MechaFlowManiac/Air-Cleaner-2/README.txt

Air-Cleaner-2 

An open source air filter frame concept.  Adaptable to multiple types of fans and filters. 
Based on the Corsi Rosenthal Box DIY air purifier.

This design and documentation is licensed under the CERN-OHL-P license.
