MechaFlowManiac/Air-Cleaner-2/20220318_Air-Cleaner-2_Overview.pdf

# Air Cleaner 2

# Based on the Corsi-Rosenthal Box*

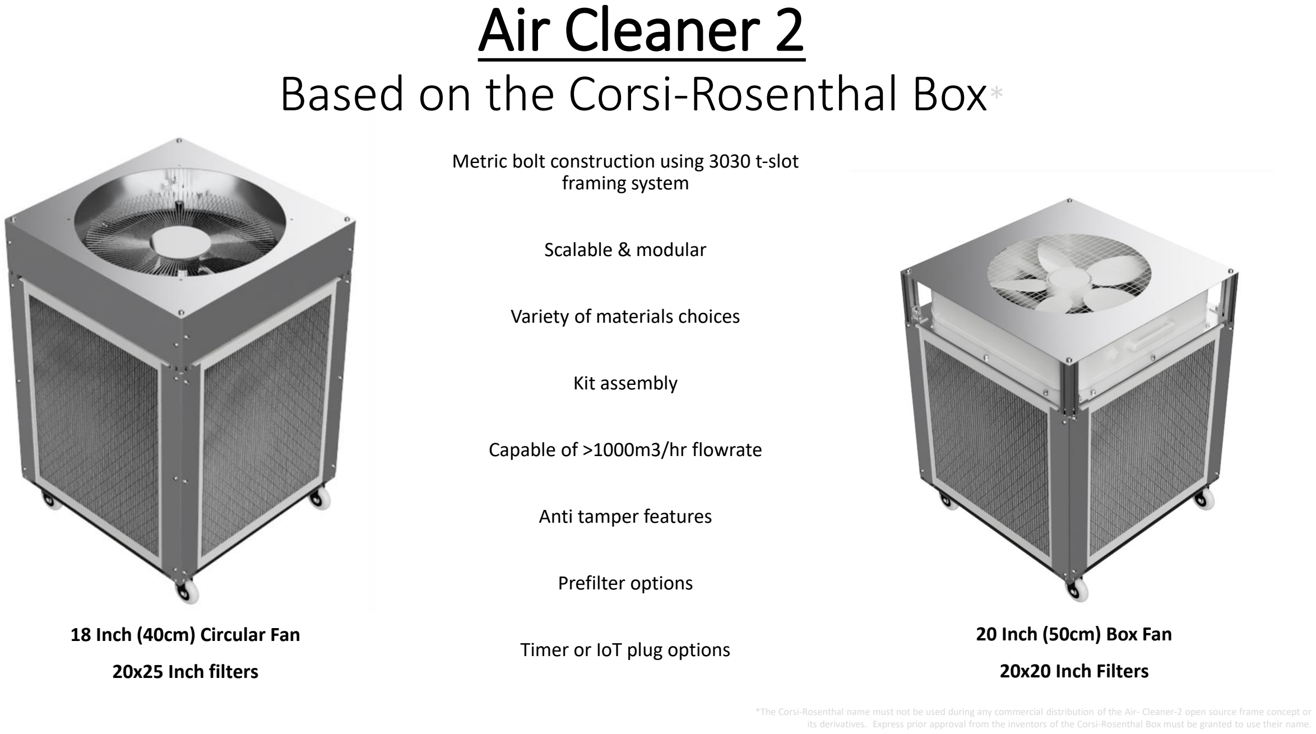
[picture p1: page 1]

Metric bolt construction using 3030 t-slot framing system

Scalable & modular

Variety of materials choices

Kit assembly

Capable of >1000m3/hr flowrate

Anti tamper features

Prefilter options

Timer or IoT plug options

### 18 Inch (40cm) Circular Fan

20x25 Inch filters

### 20 Inch (50cm) Box Fan

20x20 Inch Filters

*The Corsi-Rosenthal name must not be used during any commercial distribution of the Air- Cleaner-2 open source frame concept or its derivatives. Express prior approval from the inventors of the Corsi-Rosenthal Box must be granted to use their name. .

# Exploded view

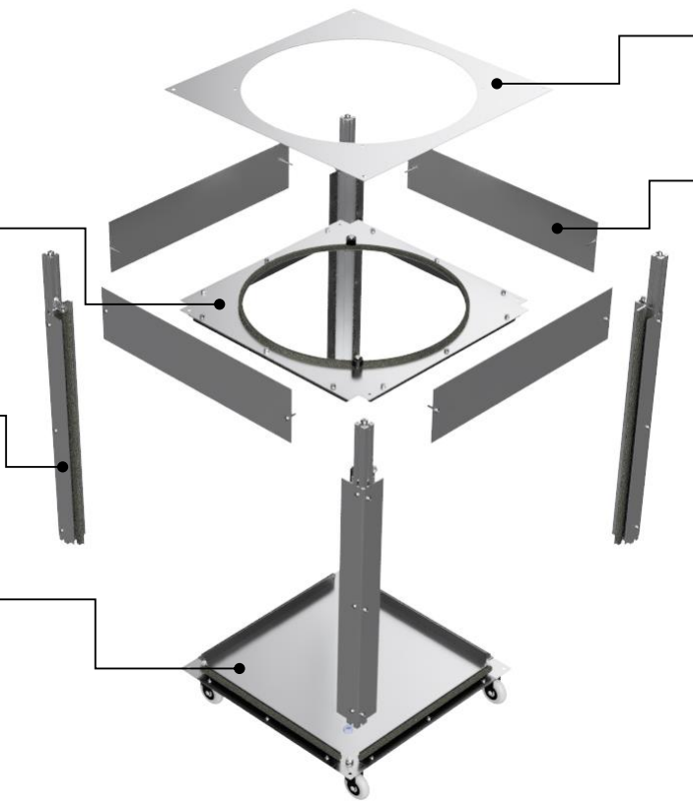
[picture p2: figure]

Fan bottom plate sub assembly

Corner sub assembly

Bottom plate sub assembly

Fan top plate

Fan enclosure plates

# Flat pack

# Sub assemblies

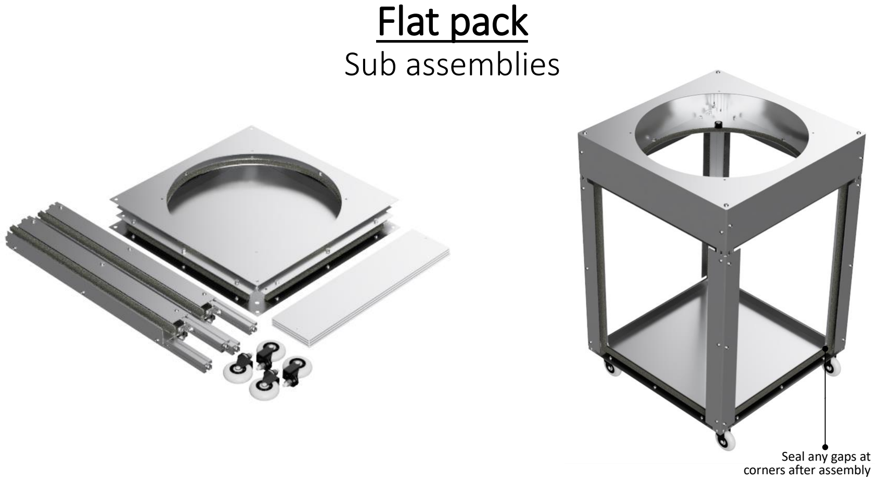
[picture p3: page 3]

Seal any gaps at
corners after assembly

# Fan bottom plate sub assembly

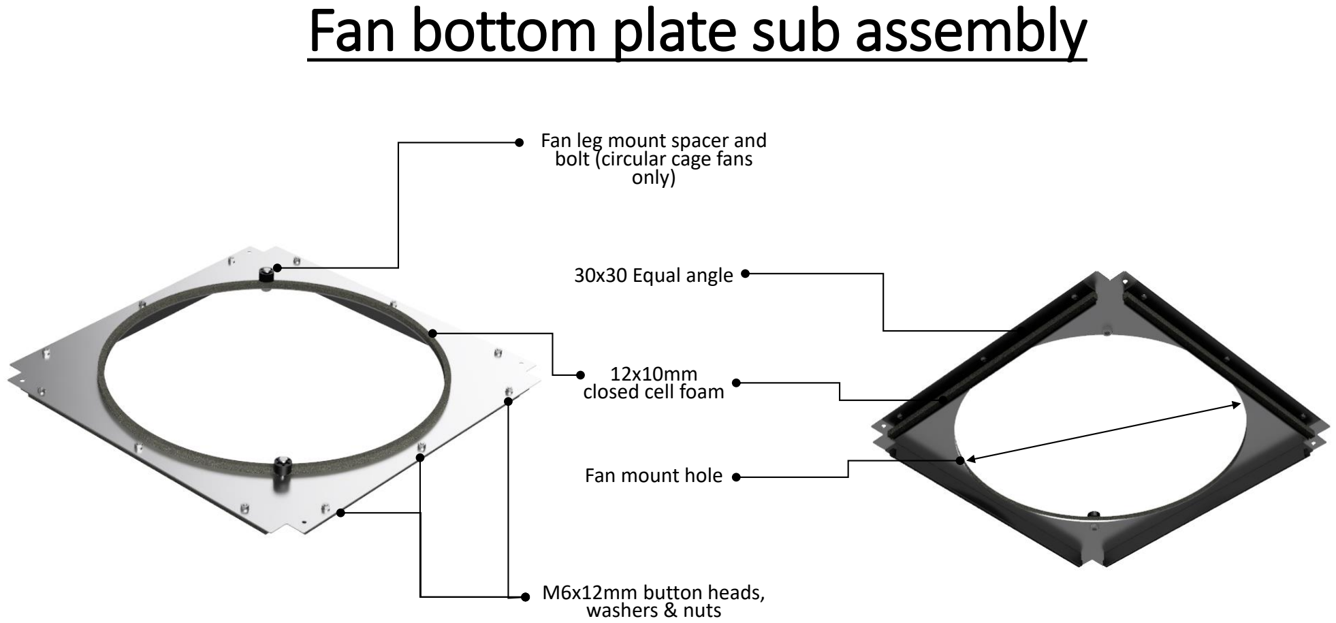
[picture p4: page 4]

Fan leg mount spacer and
bolt (circular cage fans
only)

30x30 Equal angle

12x10mm
closed cell foam

Fan mount hole

M6x12mm button heads,
washers & nuts

30x30 Aluminium t-slot

3030 inside corner brace
30x30x26mm
one side slotted

Filter clamp plate

30x30 equal angles +
12x10mm closed cell foam strip

# Corner sub assembly

M8 top & bottom

All other M6

# Base plate sub assembly

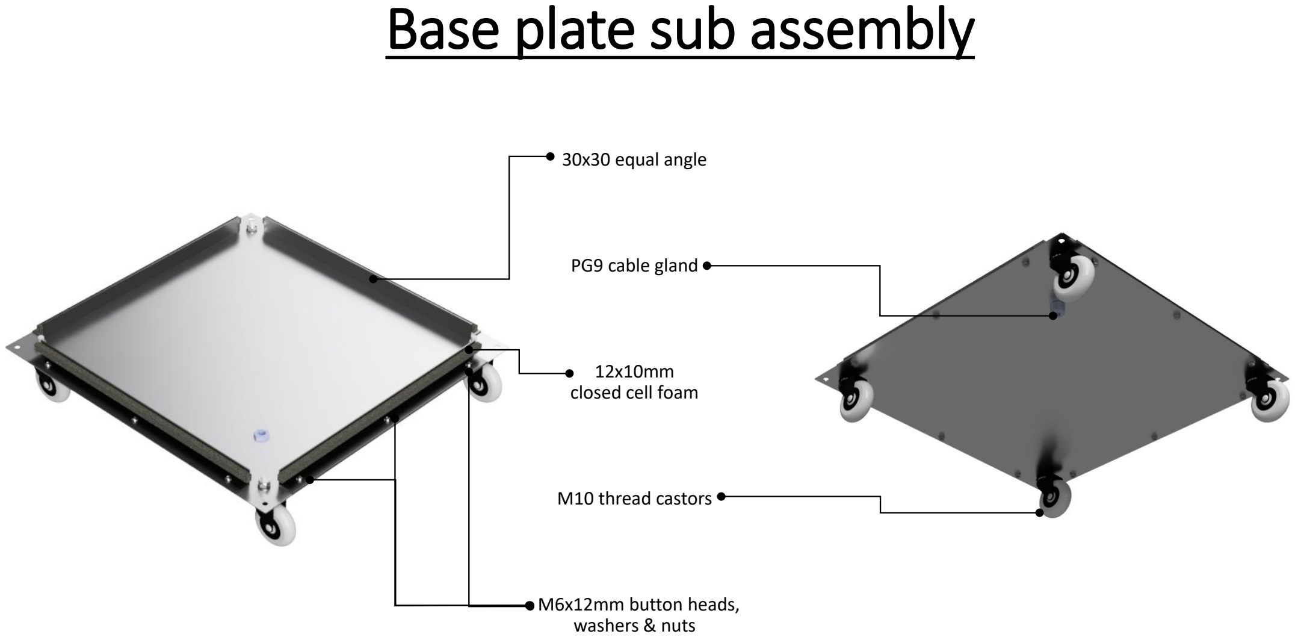
[picture p5: page 6]

30x30 equal angle

PG9 cable gland

12x10mm
closed cell foam

M10 thread castors

M6x12mm button heads,
washers & nuts

# Cable management

# PG9 gland

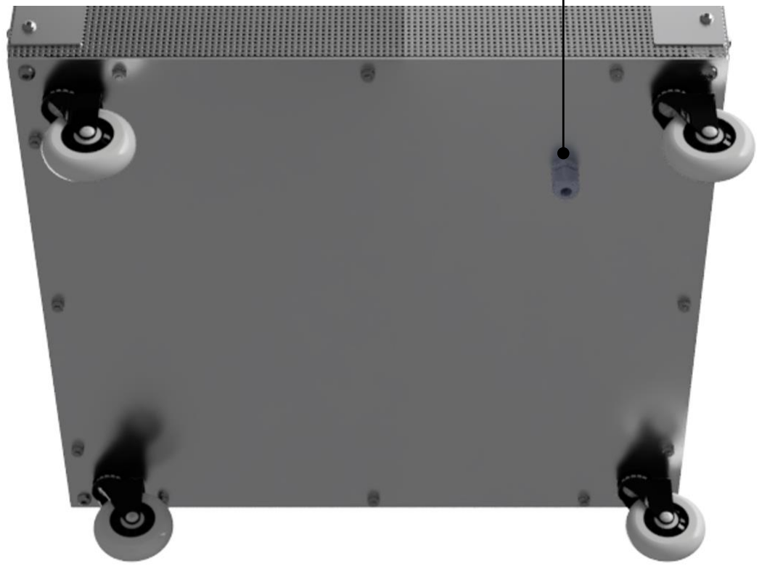
[picture p6: figure]

# OPTIONS

# Sizes

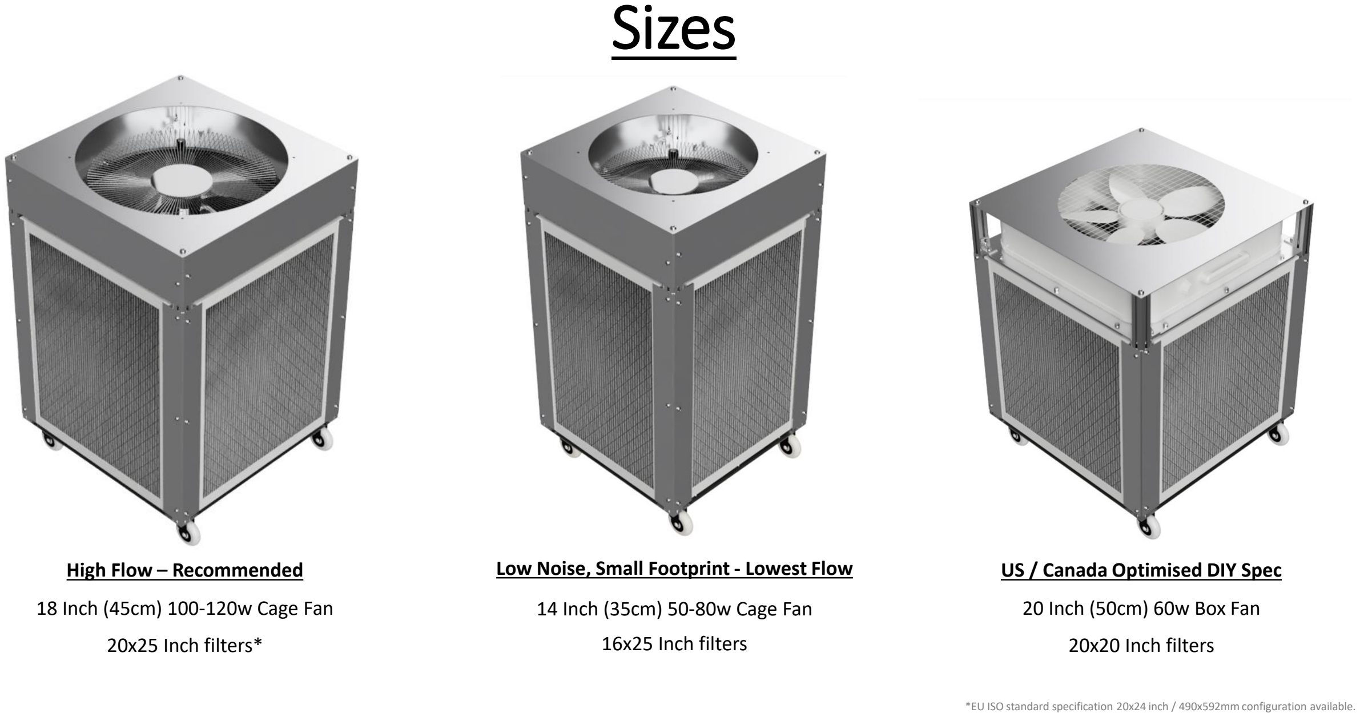
[picture p7: page 9]

High Flow – Recommended

18 Inch (45cm) 100-120w Cage Fan

20x25 Inch filters*

US / Canada Optimised DIY Spec

20 Inch (50cm) 60w Box Fan

20x20 Inch filters

Low Noise, Small Footprint - Lowest Flow

14 Inch (35cm) 50-80w Cage Fan 16x25 Inch filters

*EU ISO standard specification 20x24 inch / 490x592mm configuration available.

# Basic box

Example:

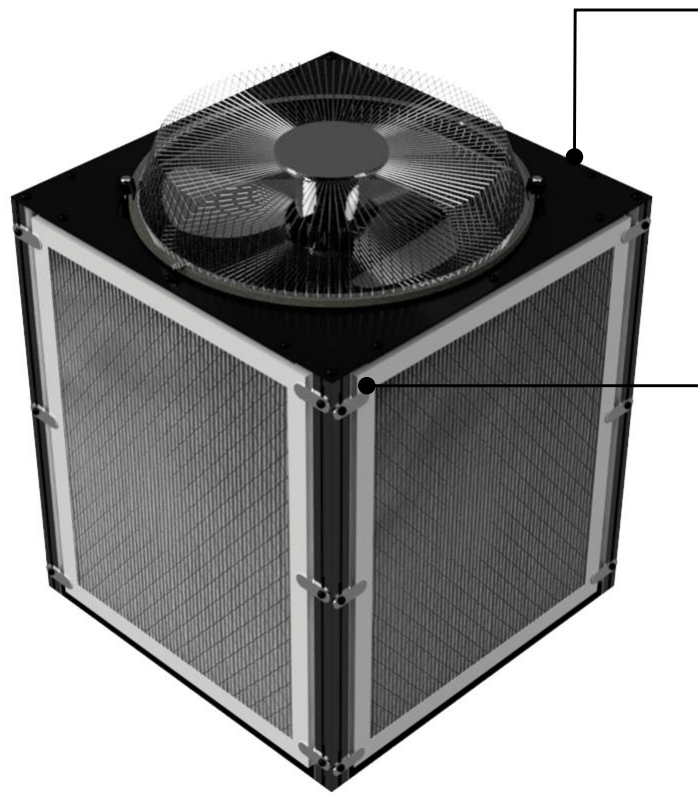
[picture p8: figure]
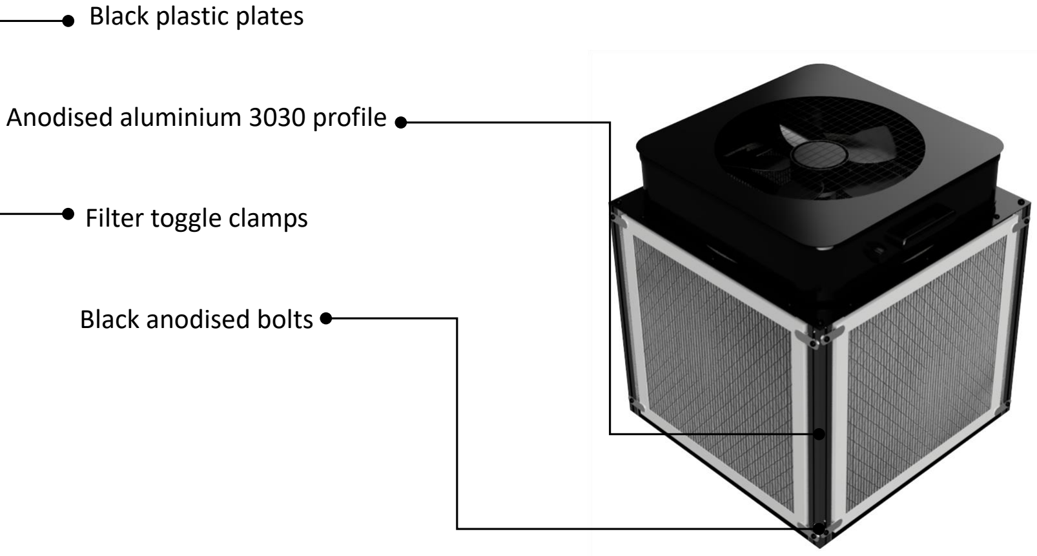
[picture p9: figure]
Black plastic plates; Anodised aluminium 3030 profile; Filter toggle clamps; Black anodised bolts

# Basic box mount

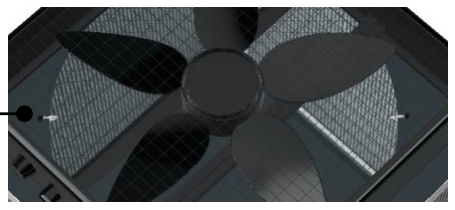
[picture p10: figure]
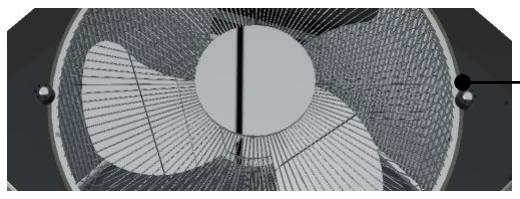
[picture p11: figure]

Cage fan pinned by leg bolts & spacers

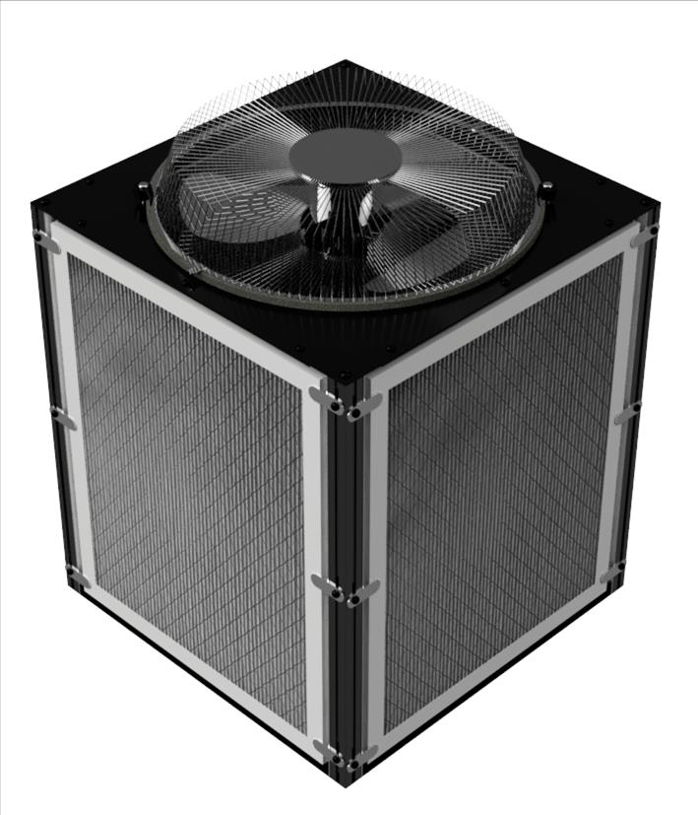
[picture p12: figure]
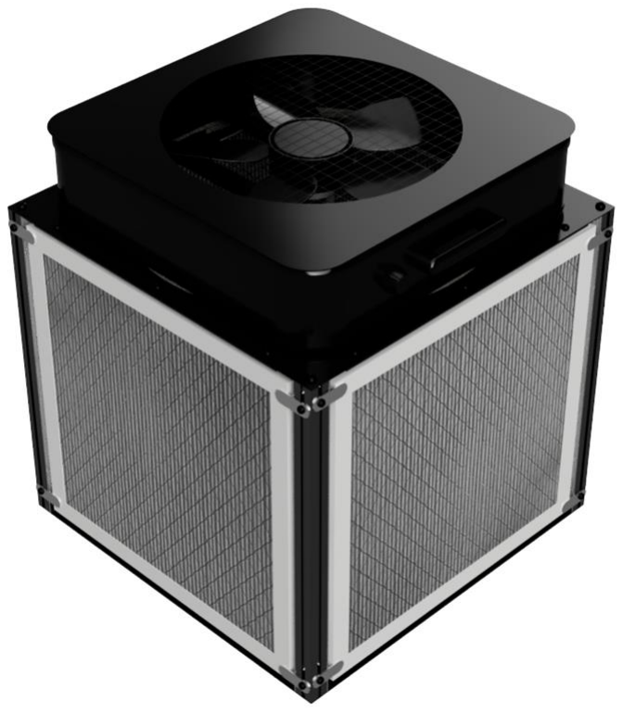
[picture p13: figure]

Box fan secured by 2x zip ties

# Material specifications

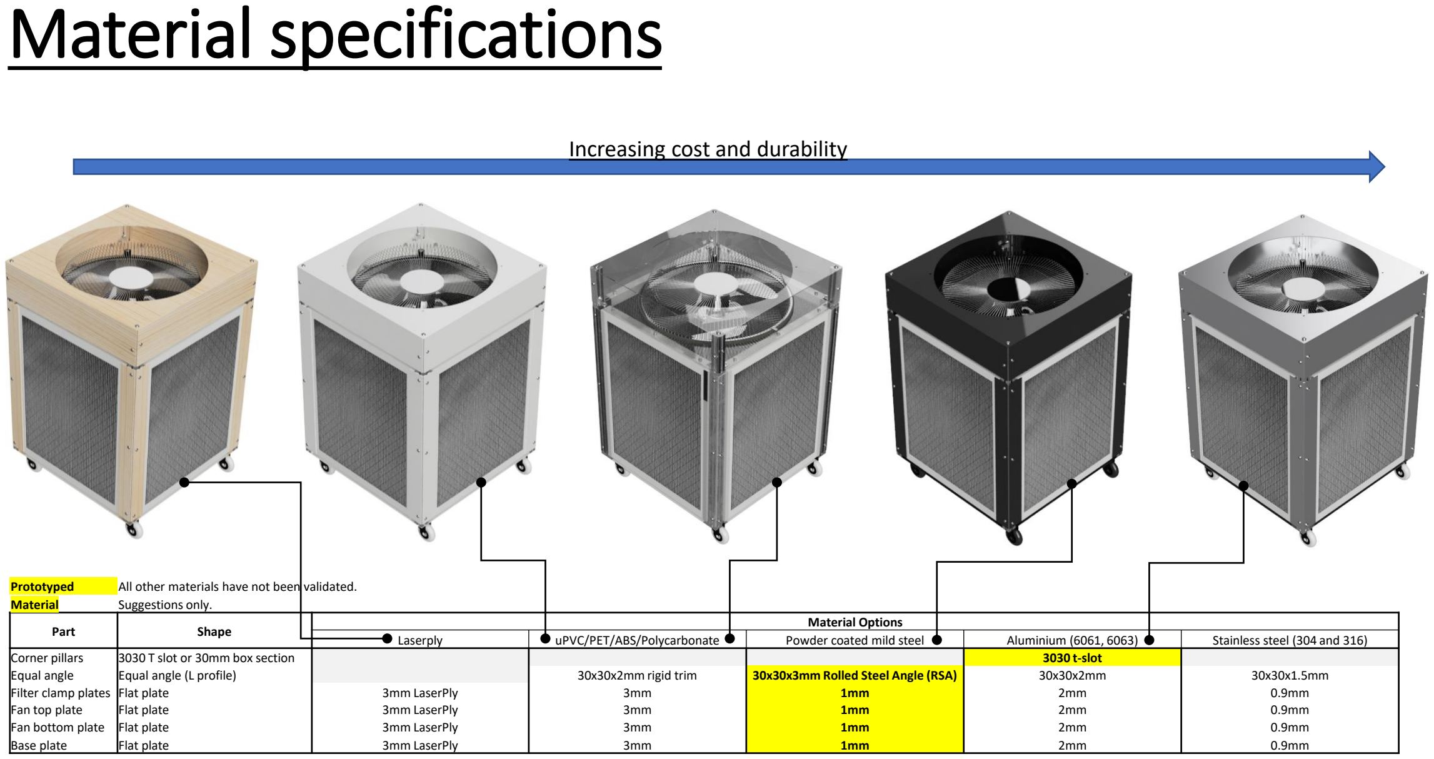
[picture p14: page 12]

Increasing cost and durability

Prototyped | All other materials have not been validated.
Material | Suggestions only.
Part | Shape | Material Options
Laserply | uPVC/PET/ABS/Polycarbonate | Powder coated mild steel | Aluminium (6061, 6063) | Stainless steel (304 and 316)
Corner pillars Equal angle Filter clamp plates Fan top plate Fan bottom plate Base plate | 3030 T slot or 30mm box section Equal angle (L profile) Flat plate Flat plate Flat plate Flat plate | 3mm LaserPly 3mm LaserPly 3mm LaserPly 3mm LaserPly | 30x30x2mm rigid trim 3mm 3mm 3mm 3mm | 30x30x3mm Rolled Steel Angle (RSA) 1mm 1mm 1mm 1mm | 3030 t-slot 30x30x2mm 2mm 2mm 2mm 2mm | 30x30x1.5mm 0.9mm 0.9mm 0.9mm 0.9mm

# Lowest Cost:

# Tapped Threads

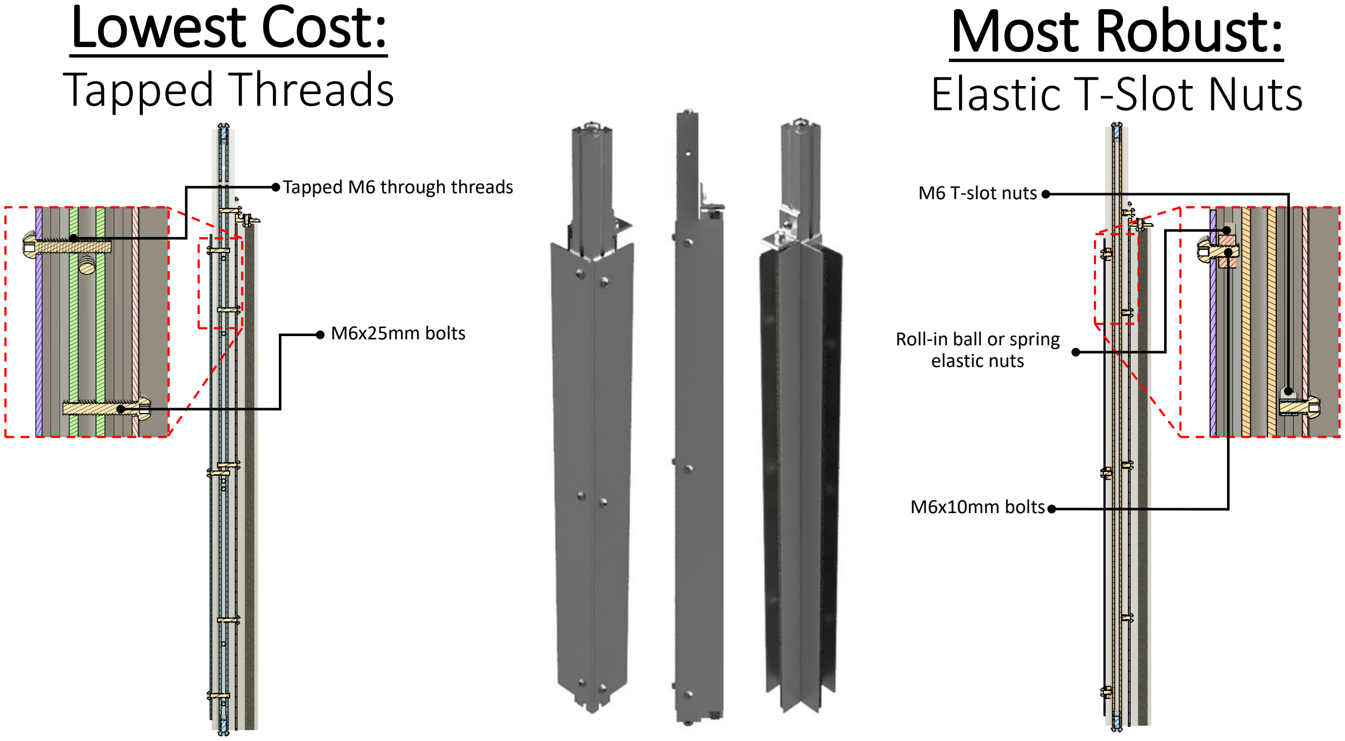
[picture p15: page 13]

Tapped M6 through threads

M6x25mm bolts

M6 T-slot nuts

Roll-in ball or spring
elastic nuts

M6x10mm bolts

# Most Robust:

# Elastic T-Slot Nuts

# Anti tamper

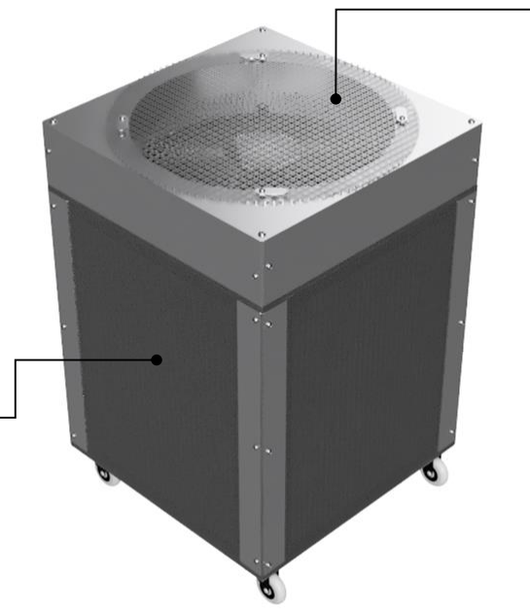
[picture p16: figure]

‘Fire pit’ fan grill
or rodent mesh

Fibreglass insect mesh prefilters

# Prefilter

# G3 or 4Oz fire retardant polyester wadding

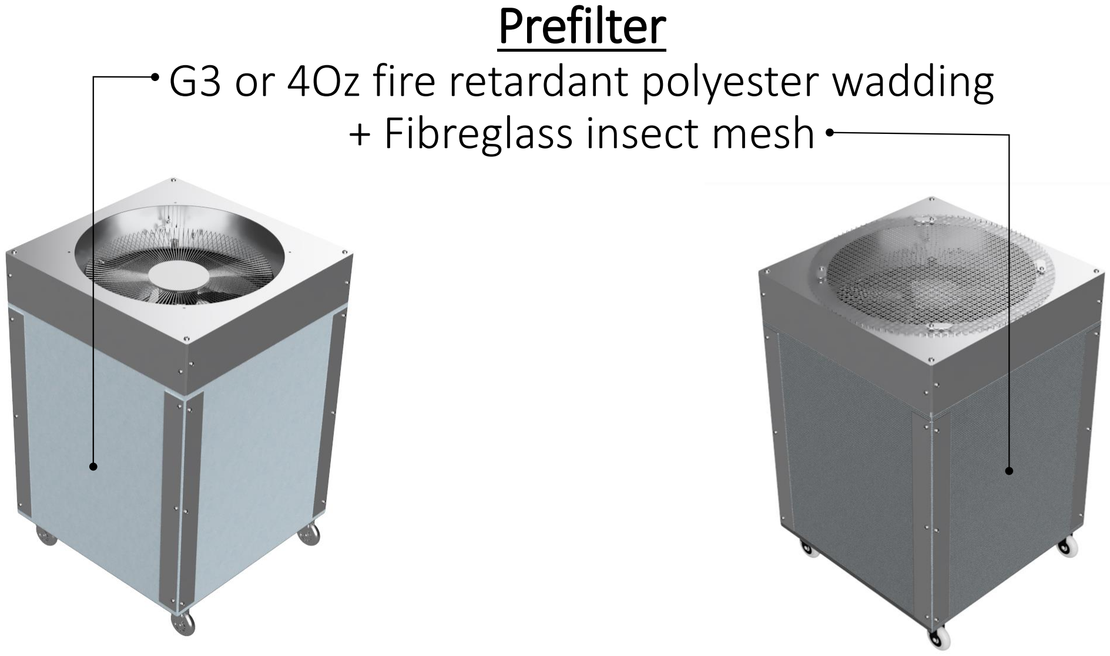
[picture p17: page 15]

# + Fibreglass insect mesh

# Aesthetic covers

# Custom vinyl print or painted panel

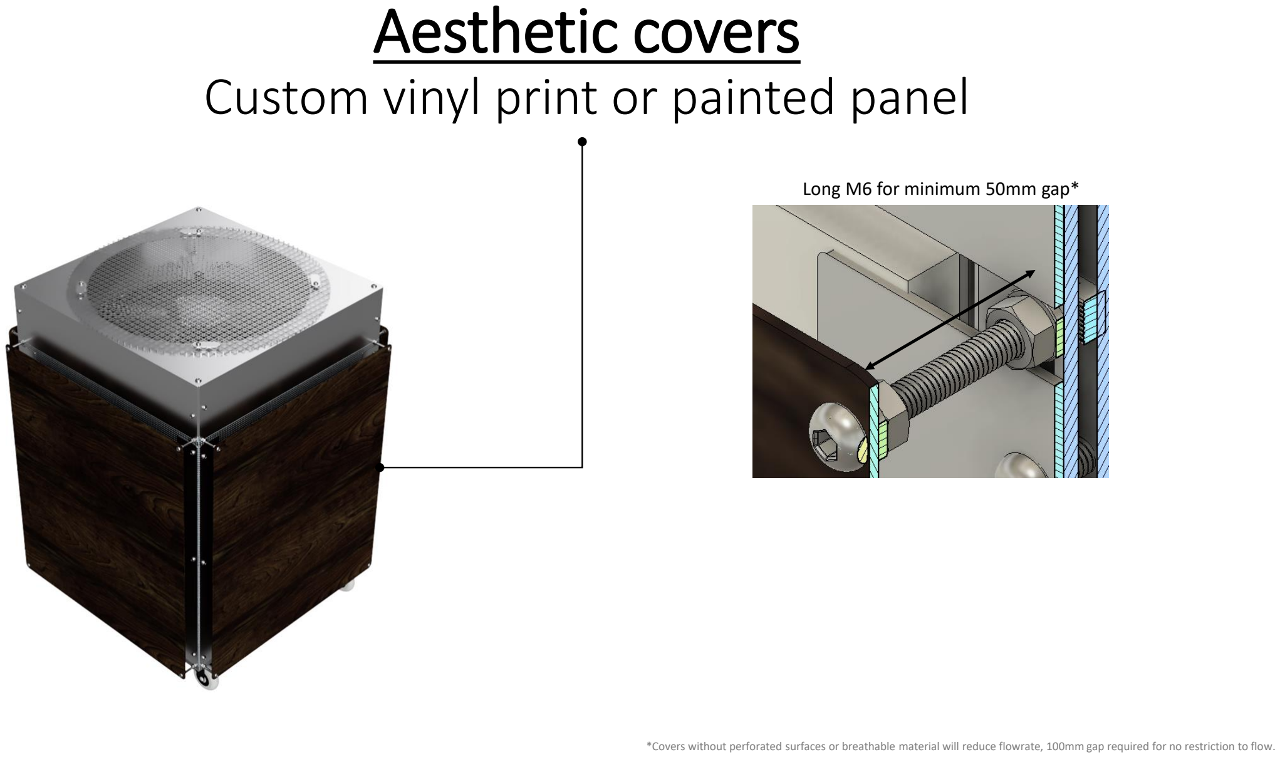
[picture p18: page 16]

Long M6 for minimum 50mm gap*

*Covers without perforated surfaces or breathable material will reduce flowrate, 100mm gap required for no restriction to flow.

# 1-4 filter construction

# Dummy filter blank plate example

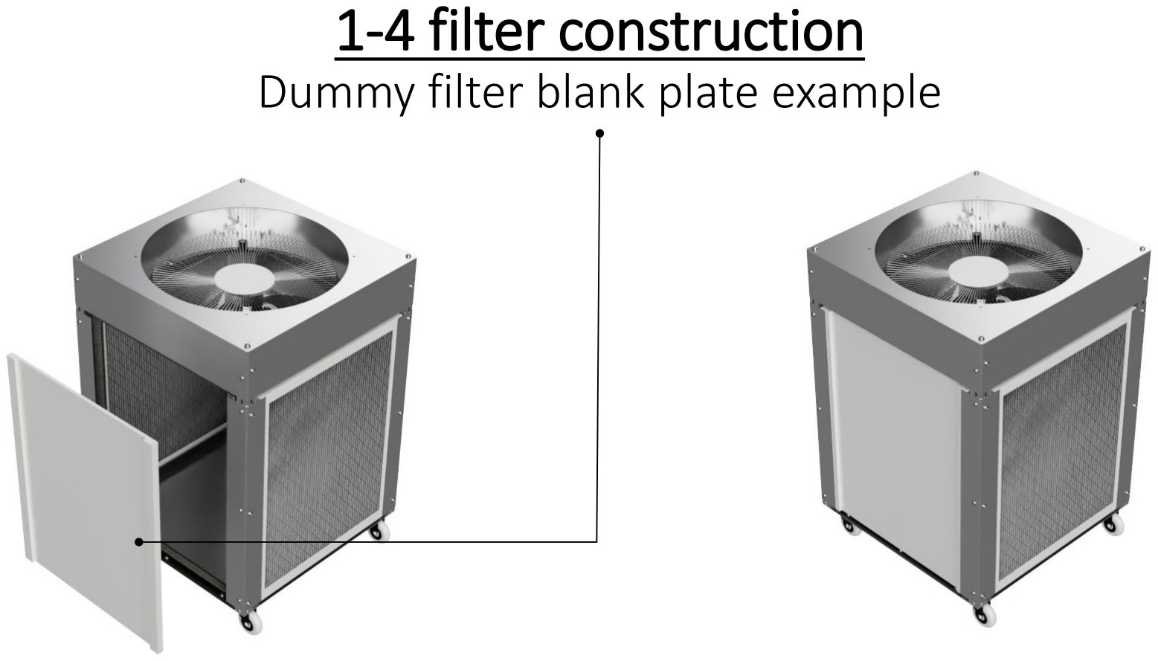
[picture p19: page 17]

# Filter clamp

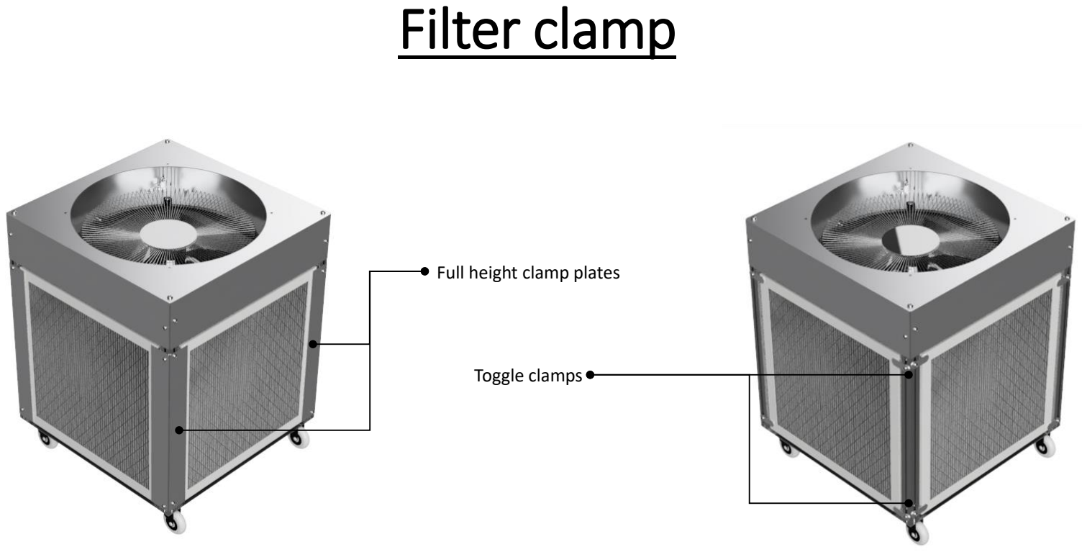
[picture p20: page 18]

Full height clamp plates

Toggle clamps

# 2” (48mm) deep filters

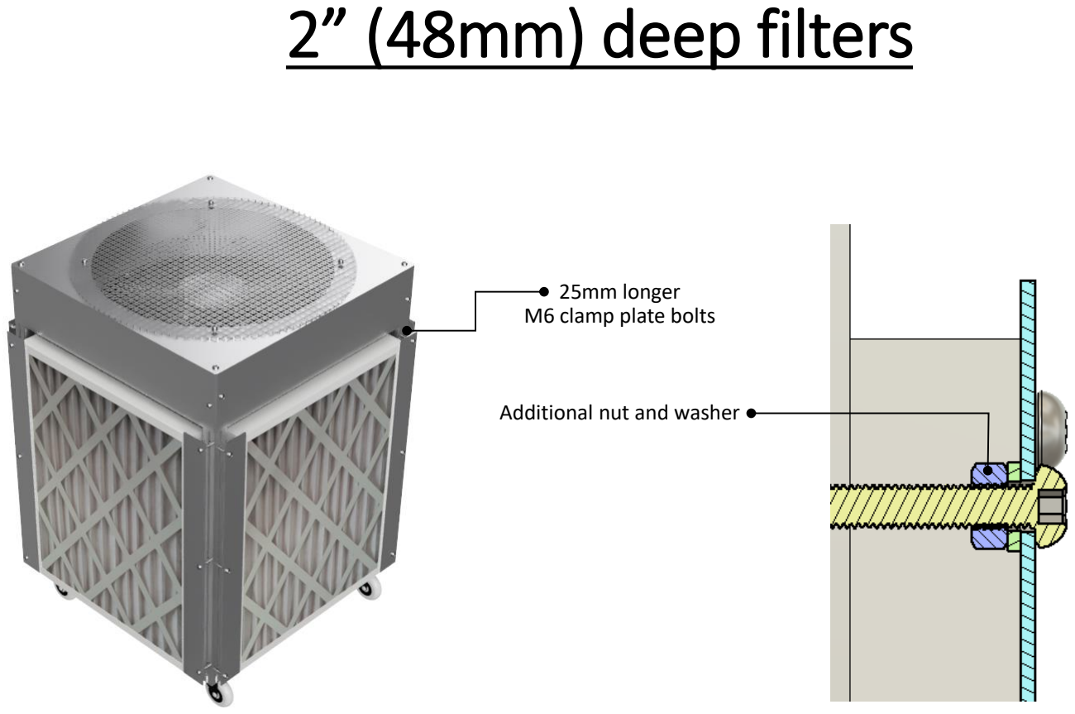
[picture p21: page 19]

25mm longer
M6 clamp plate bolts

Additional nut and washer

# EPA filter adapter example

# IKEA STARKVIND E12 EN1822

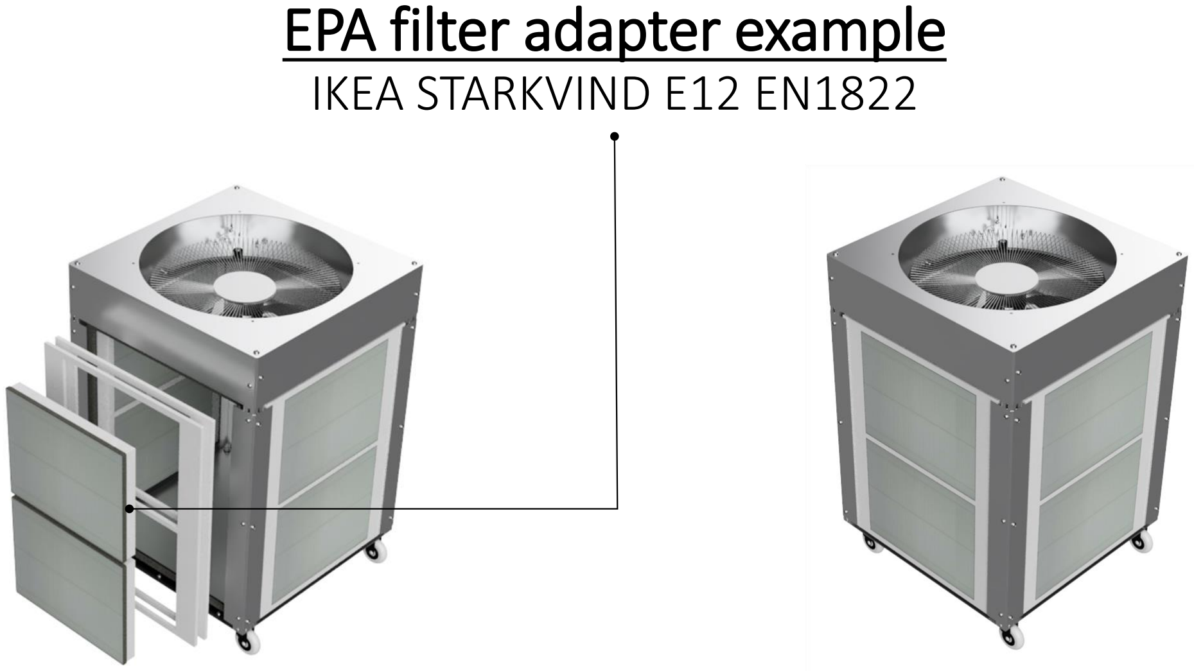
[picture p22: page 20]

# Commercial plate fan

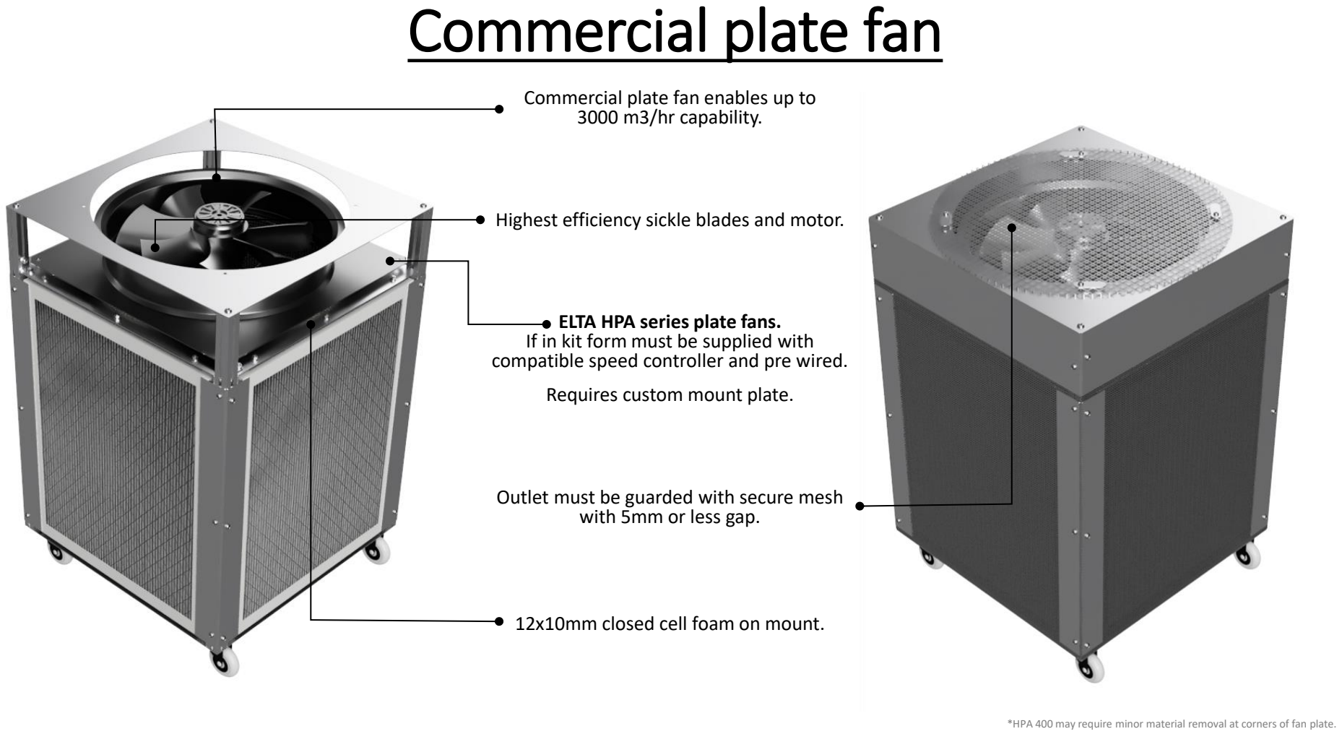
[picture p23: page 21]

Commercial plate fan enables up to 3000 m3/hr capability.

Highest efficiency sickle blades and motor.

ELTA HPA series plate fans. If in kit form must be supplied with compatible speed controller and pre wired. Requires custom mount plate.

Outlet must be guarded with secure mesh with 5mm or less gap.

12x10mm closed cell foam on mount.

*HPA 400 may require minor material removal at corners of fan plate.

# Fan and filter specifications

FANS – General specifications

### 20 Inch Box fans

- Speed adjustable models via side mounted dial.
- Max 70w rating advised for noise

### 18 Inch Cage Fans

- Legs removed
- Single speed (rear controls inaccessible)
- Max 120w rating advised for noise
- 500mm to edges of cage grill

### 14 Inch Cage Fans

- Legs removed
- Single speed (rear controls inaccessible)
- Max 70w rating advised for noise
- 385mm to edges of cage grill

High Efficiency Commercial Plate fans
20 Inch Filters: HPA315/4-1A, HPA400/6-1A 16 Inch Filters: HPA250/4-1A
- Pre-wired
- Speed switch / controller
- Outlet safety grill with 4mm or less gap

FILTERS – General specifications Panel types
- ISO F7/F8 ePM1 50% or higher
- MERV 13 or 14
- EPA 11, EPA 12
- Use filter with ASHRAE Standard 52.2, EN1822 or GB/T 14295 rating where appropriate for locality.

Panel sizes
ISO
- 490x592mm (20x24 equivalent)
- 490x620mm (20x25 equivalent)
- 24 or 48mm deep

ASHRAE
- 20x25 Inch
- 20x24 Inch
- 20x20 Inch
- 1 or 2 Inch deep (increase clamp bolt length for 2”)

Standard retail replacement filters with custom adapter
- E.g. IKEA STARKVIND EPA 12

Other sizes possible with custom adapter plates.

Recommended

### 20 Inch Box Fans

US/CA Default box fan: Lasko 3733
EU Default box fan: Sichler VT-241.B

### 18 Inch Cage Fans

High quality & flow: NETTA sickle blade High quality & efficient: Hydor Typhoon Budget & low noise: Prem-I-air EH0522

### 14 Inch Cage Fans

Recommendation list WIP, check dimensions of cage and adjust mount plate accordingly.

Filters
Retail Available: | Filtrete MPR 1900, 2200
Commercial: | EN1822 rated EPA 11/12

Pre filters
G2/G3 or 40z fire retardant polyester wadding prefilter
+ Fibreglass insect mesh

# USE & MAINTENANCE

# Filter replacement

Replacement schedule guide* Every 6 months if used 12 hrs/day Every 3-6 months 24 hrs/day

OR

Condition Monitoring Options PM2.5 sensor

RPM by blade pass frequency on tablet/phone spectrogram app +
Power consumption & voltage

SPL noise measure at 1m from edge of cart. E.g. NIOSH phone app or type 2 SPL meter

Air velocity meter (E.g. Testo 405i) sweep average velocity across filter inlet.

*Assumes 4x mini pleated filters, G3/wadding + insect mesh prefilters

# I/O Automation

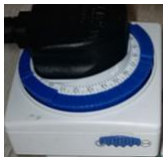
[picture p24: figure]

Timer inline socket

OR

IoT WIFI inline plug socket

# Placement Wall

Wall

50mm min
>100mm best

Blank
plate

### 3 Filters 1 blank plate

### 4 Filters

# Avoid corners Fan service schedule

Clean fan cage and blades at every filter change.

Re oil fan motor bearing every second filter change.
