MechaFlowManiac/Air-Cleaner-2/Air-Cleaner-2 Mechanical/20220318_Air-Cleaner-2_BOM.xlsx

Sheet: BOM
 |  | Cart / Box |  |  | Cart | Cart | Cart | Cart | Box | Box | Box | Box
 |  | Fan |  |  | 18 Inch (45cm) Cage Fan | 18 Inch (45cm) Cage Fan | 14 Inch (35cm) Cage Fan | 20 Inch (50cm) Box Fan | 18 Inch (45cm) Cage Fan | 18 Inch (45cm) Cage Fan | 14 Inch (35cm) Cage Fan | 20 Inch (50cm) Box Fan
 |  | Default Filter Size |  |  | 20x25x1 Inch | 20x24x1 Inch / 490x592mm | 16x25x1 Inch | 20x20x1 Inch | 20x25x1 Inch | 20x24x1 Inch | 16x25x1 Inch / 490x592mm | 20x20x1 Inch
 | QTY |  | QTY per sub assembly | Total quantity required
Fan Mount Assembly | 1 | Fan Top Plate | 1 | 1 | AC2_C_18CFTP_20HZ | AC2_C_18CFTP_20HZ | AC2_C_14CFTP_16HZ | AC2_C_20BXFTP_20HZ | N/A | N/A | N/A | N/A
Fan Mount Assembly | 1 | Fan Enclosure Plate | 4 | 4 | AC2_C_FEP_20HZ | AC2_C_FEP_20HZ | AC2_C_FEP_16HZ | N/A | N/A | N/A | N/A | N/A
Fan Mount Assembly | 1 | Fan Bottom Plate | 1 | 1 | AC2_C_18CFBP_20HZ | AC2_C_18CFBP_20HZ | AC2_C_14CFBP_16HZ | AC2_C_20BXFBP_20HZ | AC2_B_18CFBP_20HZ | AC2_B_18CFBP_20HZ | AC2_B_14CFBP_16HZ | AC2_B_18CFBP_20HZ
Fan Mount Assembly | 1 | Fan anti vibration mount | 1 | 1 | 12x10mm closed cell foam | 12x10mm closed cell foam | 12x10mm closed cell foam | 12x10mm closed cell foam | 12x10mm closed cell foam | 12x10mm closed cell foam | 12x10mm closed cell foam | 12x10mm closed cell foam
Fan Mount Assembly | 1 | Equal angle Horizontal | 4 | 4 | AC2_C_EA_20HZ | AC2_C_EA_20HZ | AC2_C_EA_16HZ | AC2_C_EA_20HZ | AC2_C_EA_20HZ | AC2_C_EA_20HZ | AC2_C_EA_16HZ | AC2_C_EA_20HZ
Fan Mount Assembly | 1 | Filter compression seal | 4 | 4 | 12x10mm closed cell foam | 12x10mm closed cell foam | 12x10mm closed cell foam | 12x10mm closed cell foam | 12x10mm closed cell foam | 12x10mm closed cell foam | 12x10mm closed cell foam | 12x10mm closed cell foam
Corner Assembly | 4 | Corner pillar | 1 | 4 | AC2_C_TST_25VT | AC2_C_TST_24VT | AC2_C_TST_25VT | AC2_C_TST_20VT | AC2_B_TST_25VT | AC2_B_TST_24VT | AC2_B_TST_25VT | AC2_B_TST_20VT
Corner Assembly | 4 | Equal angle vertical | 2 | 8 | AC2_C_EA_25VT | AC2_C_EA_24VT | AC2_C_EA_25VT | AC2_C_EA_20VT | AC2_C_EA_25VT | AC2_C_EA_24VT | AC2_C_EA_25VT | AC2_C_EA_20VT
Corner Assembly | 4 | Filter compression seal | 4 | 4 | 12x10mm closed cell foam | 12x10mm closed cell foam | 12x10mm closed cell foam | 12x10mm closed cell foam | 12x10mm closed cell foam | 12x10mm closed cell foam | 12x10mm closed cell foam | 12x10mm closed cell foam
Corner Assembly | 4 | Filter clamp | 2 | 8 | AC2_C_FCP_25VT | AC2_C_FCP_24VT | AC2_C_FCP_25VT | AC2_C_FCP_20VT | AC2_B_FCT | AC2_B_FCT | AC2_B_FCT | AC2_B_FCT
Corner Assembly | 4 | Corner bracket | 1 | 4 | 3030 slotted inside corner brace | 3030 slotted inside corner brace | 3030 slotted inside corner brace | 3030 slotted inside corner brace | N/A | N/A | N/A | N/A
Base plate assembly | 1 | Base Plate | 1 | 1 | AC2_C_BP_20HZ | AC2_C_BP_20HZ | AC2_C_BP_16HZ | AC2_C_BP_20HZ | AC2_B_BP_20HZ | AC2_B_BP_20HZ | AC2_B_BP_16HZ | AC2_B_BP_20HZ
Base plate assembly | 1 | Wheels | 4 | 4 | M10 trolley castor | M10 trolley castor | M10 trolley castor | M10 trolley castor | N/A | N/A | N/A | N/A
Base plate assembly | 1 | Cable Gland | 1 | 1 | PG9 Nylon Locknut Cable Gland | PG9 Nylon Locknut Cable Gland | PG9 Nylon Locknut Cable Gland | PG9 Nylon Locknut Cable Gland | N/A | N/A | N/A | N/A
Base plate assembly | 1 | Equal angle Horizontal | 4 | 4 | AC2_C_EA_20HZ | AC2_C_EA_20HZ | AC2_C_EA_16HZ | AC2_C_EA_20HZ | AC2_C_EA_20HZ | AC2_C_EA_20HZ | AC2_C_EA_16HZ | AC2_C_EA_20HZ
Base plate assembly | 1 | Filter compression seal | 4 | 4 | 12x10mm closed cell foam | 12x10mm closed cell foam | 12x10mm closed cell foam | 12x10mm closed cell foam | 12x10mm closed cell foam | 12x10mm closed cell foam | 12x10mm closed cell foam | 12x10mm closed cell foam
Fan Bottom plate | 1 | M6x12 bolt* + washer + nut |  |  | 16 | 16 | 16 | 16 | 12 | 12 | 12 | 12
Base plate assembly | 1 | M6x12 bolt* + washer + nut |  |  | 12 | 12 | 12 | 12 | 12 | 12 | 12 | 12
 |  | **Adjust as necessary depending on plate material thickness |  | Total M6x12 | 28 | 28 | 28 | 28 | 24 | 24 | 24 | 24
Fan Enclosure plates | 4 | M6x25 bolt** |  |  | 2 | 2 | 2 | 0 | 0 | 0 | 0 | 0
Corner Assembly | 4 | M6x25 bolt** |  |  | 13 | 13 | 13 | 11 | 12 | 12 | 12 | 10
 |  | **If using T-slot nuts instead of threaded 3030, replace with M6x10 |  | Total M6x25 | 60 | 60 | 60 | 44 | 48 | 48 | 48 | 40
Base plate assembly | 1 | M8x15 bolt |  |  | 4 | 4 | 4 | 4 | 4 | 4 | 4 | 4
Fan Top plate | 1 | M8x15 bolt |  |  | 4 | 4 | 4 | 4 | 4 | 4 | 4 | 4
 |  |  |  | Total M8x15 | 8 | 8 | 8 | 8 | 8 | 8 | 8 | 8

Sheet: Material Options Summary
Prototyped material | All other specifications have not been tested and are suggestions only
Part | Shape | Material Options |  |  |  |  | Material options | Thickness
 |  | Laserply | uPVC/PET/ABS/Polycarbonate | Painted mild steel | Aluminium (6061, 6063) | Stainless steel (304 and 316)
Corner pillers | 3030 T slot or 30mm box section |  |  |  | 3030 t-slot |  | Aluminium | 2mm
Angle extrusions | Equal angle (L profile) |  | 30x30x2mm rigid trim | 30x30x3mm Rolled Steel Angle (RSA) | 30x30x2mm | 30x30x1.5mm | Painted mild steel | 1-2mm
Filter clamp plates | Flat plate | 3mm LaserPly | 3mm | 1mm | 2mm | 0.9mm | uPVC/PET/ABS extrusion | 2-3mm
Fan top plate | Flat plate | 3mm LaserPly | 3mm | 1mm | 2mm | 0.9mm
Fan bottom plate | Flat plate | 3mm LaserPly | 3mm | 1mm | 2mm | 0.9mm
Base plate | Flat plate | 3mm LaserPly | 3mm | 1mm | 2mm | 0.9mm

Sheet: Part Name List
Design Title | Version | Cart / Box | Alias | Part Name 1 | Part Size | Alias | Filter size alias | Drawing number
Air Cleaner | 2 | Cart | AC2_C | Base Plate | 16 Inch Horizontal | BP | 16HZ | AC2_C_BP_16HZ
Air Cleaner | 2 | Cart | AC2_C | Base Plate | 20 Inch Horizontal | BP | 20HZ | AC2_C_BP_20HZ
Air Cleaner | 2 | Cart | AC2_C | 14 Inch Cage Fan Bottom Plate | 16 Inch Horizontal | 14CFBP | 16HZ | AC2_C_14CFBP_16HZ
Air Cleaner | 2 | Cart | AC2_C | 18 Inch Cage Fan Bottom Plate | 20 Inch Horizontal | 18CFBP | 20HZ | AC2_C_18CFBP_20HZ
Ait Cleaner | 2 | Cart | AC2_C | 20 Inch Box Fan bottom Plate | 20 Inch Horizontal | 20BXFBP | 20HZ | AC2_C_20BXFBP_20HZ
Air Cleaner | 2 | Cart | AC2_C | 14 Inch Cage Fan Top Plate | 16 Inch Horizontal | 14CFTP | 16HZ | AC2_C_14CFTP_16HZ
Air Cleaner | 2 | Cart | AC2_C | 18 Inch Cage Fan Top Plate | 20 Inch Horizontal | 18CFTP | 20HZ | AC2_C_18CFTP_20HZ
Air Cleaner | 2 | Cart | AC2_C | 20 Inch Box Fan Top Plate | 20 Inch Horizontal | 20BXFTP | 20HZ | AC2_C_20BXFTP_20HZ
Air Cleaner | 2 | Cart | AC2_C | Aesthetic Cover | 20 x 20 Inch | ASC | 20HZ20VT | AC2_C_ASC_20HZ20VT
Air Cleaner | 2 | Cart | AC2_C | Aesthetic Cover | 20 x 25 Inch | ASC | 20HZ25VT | AC2_C_ASC_20HZ25VT
Air Cleaner | 2 | Cart | AC2_C | Filter clamp Plate | 20 Inch Vertical | FCP | 20VT | AC2_C_FCP_20VT
Air Cleaner | 2 | Cart | AC2_C | Filter clamp Plate | 24 Inch 592mm Vertical | FCP | 24VT | AC2_C_FCP_24VT
Air Cleaner | 2 | Cart | AC2_C | Filter clamp Plate | 25 Inch Vertical | FCP | 25VT | AC2_C_FCP_25VT
Air Cleaner | 2 | Cart | AC2_C | Fan enclosure plate | 16 Inch Horizontal | FEP | 16HZ | AC2_C_FEP_16HZ
Air Cleaner | 2 | Cart | AC2_C | Fan enclosure plate | 20 Inch Hoizontal | FEP | 20HZ | AC2_C_FEP_20HZ
Air Cleaner | 2 | Cart | AC2_C | Equal Angle | 16 Inch Horizontal | EA | 16HZ | AC2_C_EA_16HZ
Air Cleaner | 2 | Cart | AC2_C | Equal Angle | 20 Inch Horizontal | EA | 20HZ | AC2_C_EA_20HZ
Air Cleaner | 2 | Cart | AC2_C | Equal angle vertical | 20 Inch Vertical | EA | 20VT | AC2_C_EA_20VT
Air Cleaner | 2 | Cart | AC2_C | Equal angle vertical | 24 Inch 592mm Vertical | EA | 24VT | AC2_C_EA_24VT
Air Cleaner | 2 | Cart | AC2_C | Equal angle vertical | 25 Inch Vertical | EA | 25VT | AC2_C_EA_25VT
Air Cleaner | 2 | Cart | AC2_C | 3030 T-Slot Threaded | 20 Inch Vertical | TST | 20VT | AC2_C_TST_20VT
Air Cleaner | 2 | Cart | AC2_C | 3030 T-Slot Threaded | 24 Inch 592mm Vertical | TST | 24VT | AC2_C_TST_24VT
Air Cleaner | 2 | Cart | AC2_C | 3030 T-Slot Threaded | 25 Inch Vertical | TST | 25VT | AC2_C_TST_25VT
Air Cleaner | 2 | Box | AC2_B | Base Plate | 16 Inch Horizontal | BP | 16HZ | AC2_B_BP_16HZ
Air Cleaner | 2 | Box | AC2_B | Base Plate | 20 Inch Horizontal | BP | 20HZ | AC2_B_BP_20HZ
Air Cleaner | 2 | Box | AC2_B | 14 Inch Cage Fan Bottom Plate | 16 Inch Horizontal | 14CFBP | 16HZ | AC2_B_14CFBP_16HZ
Air Cleaner | 2 | Box | AC2_B | 18 Inch Cage Fan Bottom Plate | 20 Inch Horizontal | 18CFBP | 20HZ | AC2_B_18CFBP_20HZ
Air Cleaner | 2 | Box | AC2_B | 3030 T-Slot Threaded | 20 Inch Vertical | TST | 20VT | AC2_B_TST_20VT
Air Cleaner | 2 | Box | AC2_B | 3030 T-Slot Threaded | 24 Inch 592mm Vertical | TST | 24VT | AC2_B_TST_24VT
Air Cleaner | 2 | Box | AC2_B | 3030 T-Slot Threaded | 25 Inch Vertical | TST | 25VT | AC2_B_TST_25VT
Air Cleaner | 2 | Box | AC2_B | Filter clamp toggle |  | FCT |  | AC2_B_FCT_
Air Cleaner | 2 | Cart | AC2_C | HPA250 Cage Fan Top Plate | 16 Inch Horizontal | HPA250FBP | 16HZ | AC2_C_HPA250FBP_16HZ
Air Cleaner | 2 | Cart | AC2_C | HPA315 Cage Fan Top Plate | 20 Inch Horizontal | HPA315FBP | 20HZ | AC2_C_HPA315FBP_20HZ
Air Cleaner | 2 | Cart | AC2_C | HPA400 Cage Fan Top Plate | 20 Inch Horizontal | HPA400FBP | 20HZ | AC2_C_HPA400FBP_20HZ

Sheet: Naming Example
Example part name | Design Alias | Cart/Box (C/B) | Component Alias | Filter dimension Horizontal/Vertical (HZ/VT) | Model Version | Full label
AC2_C_18CFBP_20HZ_01 | AC2 | C | 18CFBP | 20HZ | 01 | Air Cleaner 2_Cart_18 Inch Cage Fan Bottom Plate_20 Inch Horizontal Filter size_Model version 1
