MechaFlowManiac/Air-Cleaner-2/Air-Cleaner-2 Mechanical/DXF/AC2_B_TST_24VT_Rev1.dxf

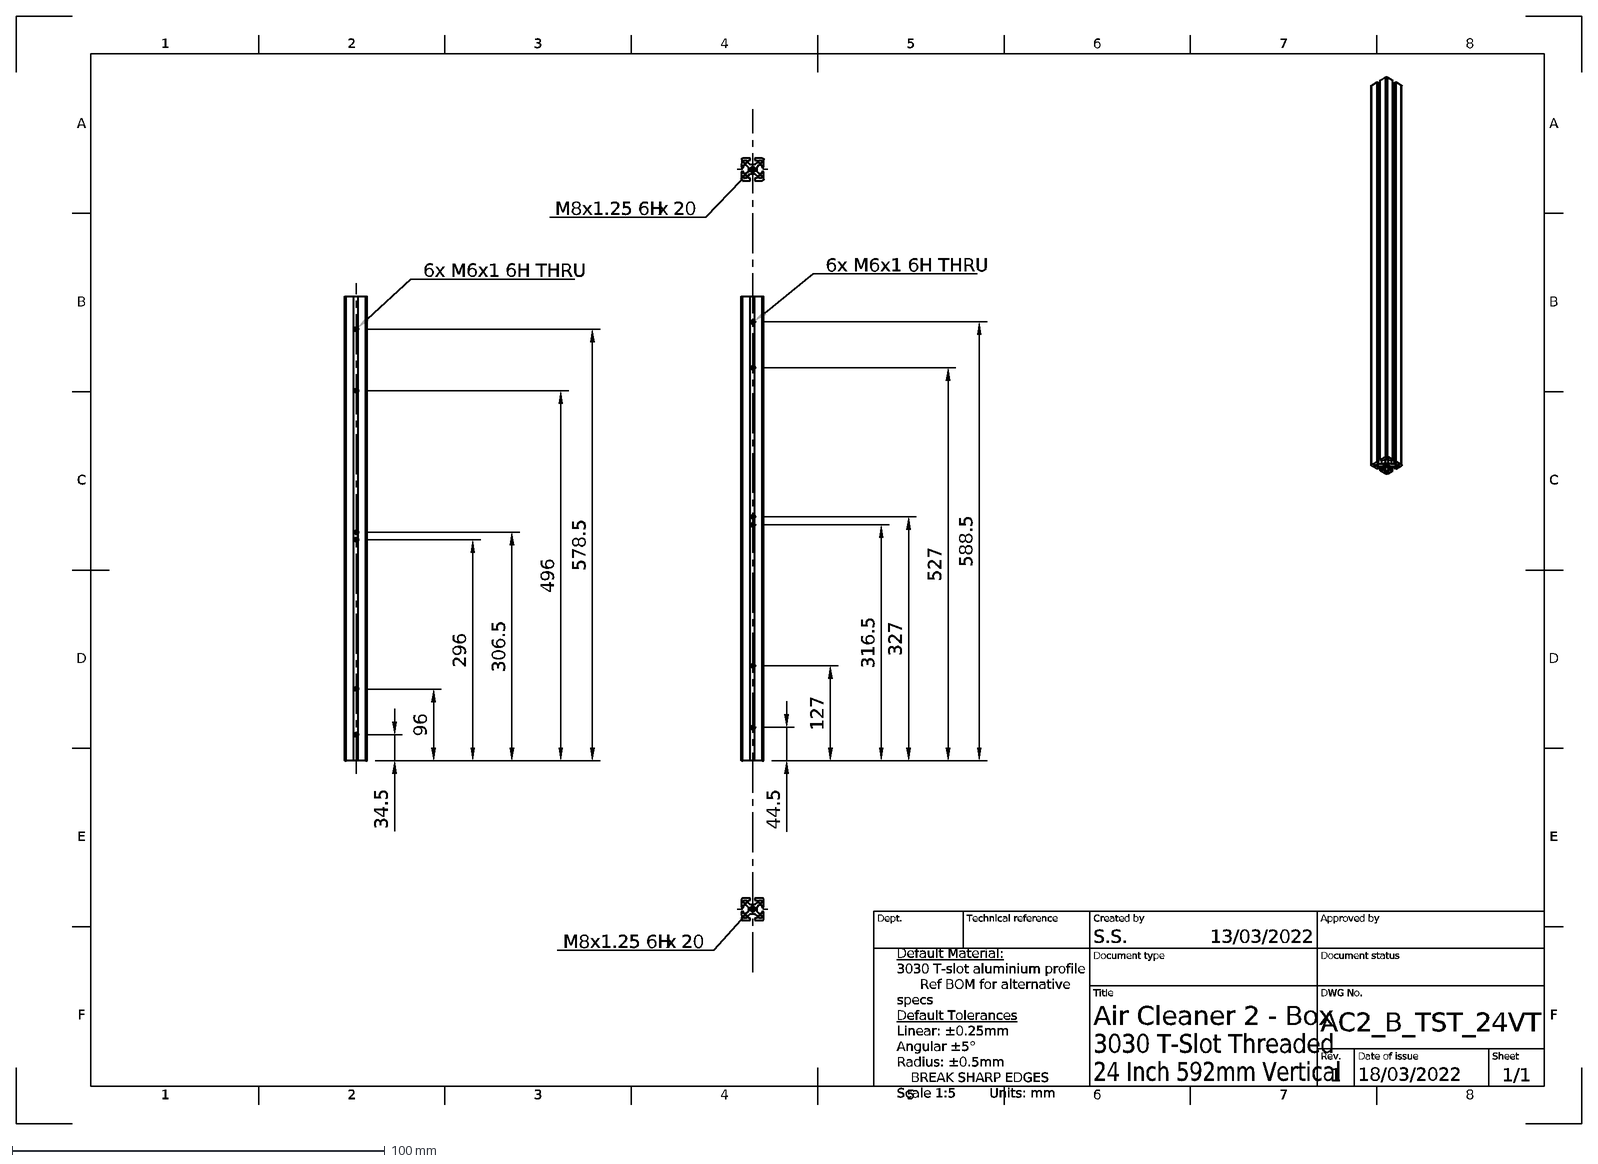
[picture p25: CAD file, 2022-03-18]
Air-Cleaner-2 Mechanical/DXF/AC2_B_TST_24VT_Rev1.dxf
1
A
2
3
4
5
6
7
8
B
C
D
E
F
18/03/2022
24 Inch 592mm Vertical
13/03/2022
1/1
3030 T-Slot Threaded
AC2_B_TST_24VT
Air Cleaner 2 - Box
S.S.
Dept.
Technical reference
Created by
Approved by
Document type
Document status
Title
DWG No.
Rev.
Date of issue
Sheet
M8x1.25 6H
20
44.5
127
316.5
327
527
588.5
34.5
96
296
306.5
496
578.5
Default Material: 3030 T-slot aluminium profile Ref BOM for alternative specs Default Tolerances Linear: ±0.25mm Angular ±5° Radius: ±0.5mm BREAK SHARP EDGES Sc
6x M6x1 6H THRU
