MechaFlowManiac/Air-Cleaner-2/Air-Cleaner-2 Mechanical/STP/AC2_C_ASC_20HZ20VT_01.step

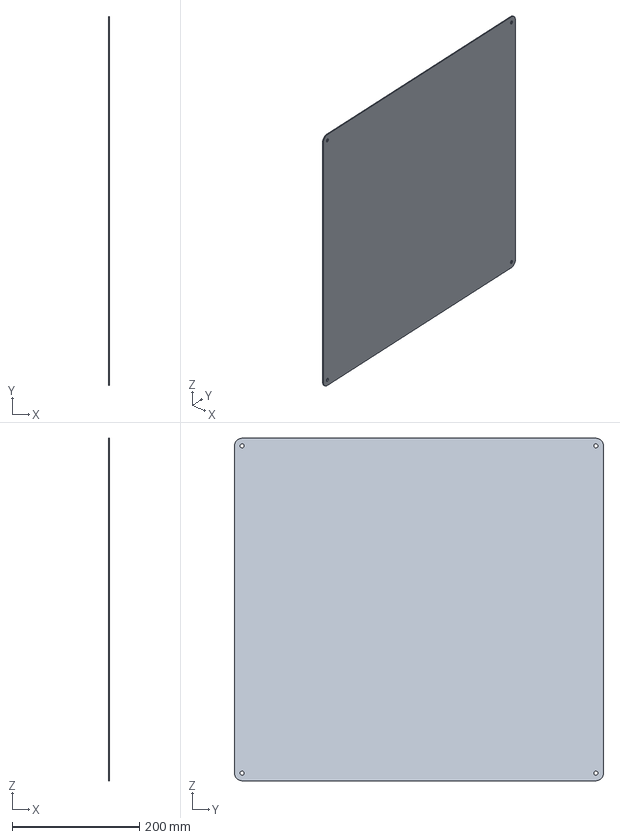
[picture p30: CAD file, 2022-03-18]
Air-Cleaner-2 Mechanical/STP/AC2_C_ASC_20HZ20VT_01.step
2.00 x 580.0 x 538.5 mm
