MechaFlowManiac/Air-Cleaner-2/Air-Cleaner-2 Mechanical/STP/AC2_C_FCP_20VT_01.step

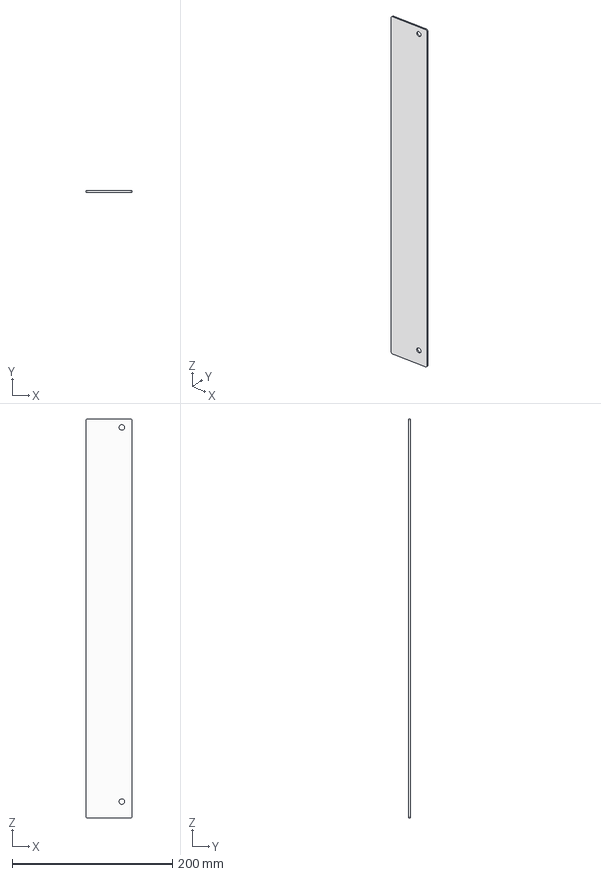
[picture p32: CAD file, 2022-03-18]
Air-Cleaner-2 Mechanical/STP/AC2_C_FCP_20VT_01.step
58.0 x 2.00 x 498.0 mm
