MechaFlowManiac/Air-Cleaner-2/Air-Cleaner-2 Mechanical/DXF/AC2_C_HPA315FBP_20HZ_Rev1.dxf

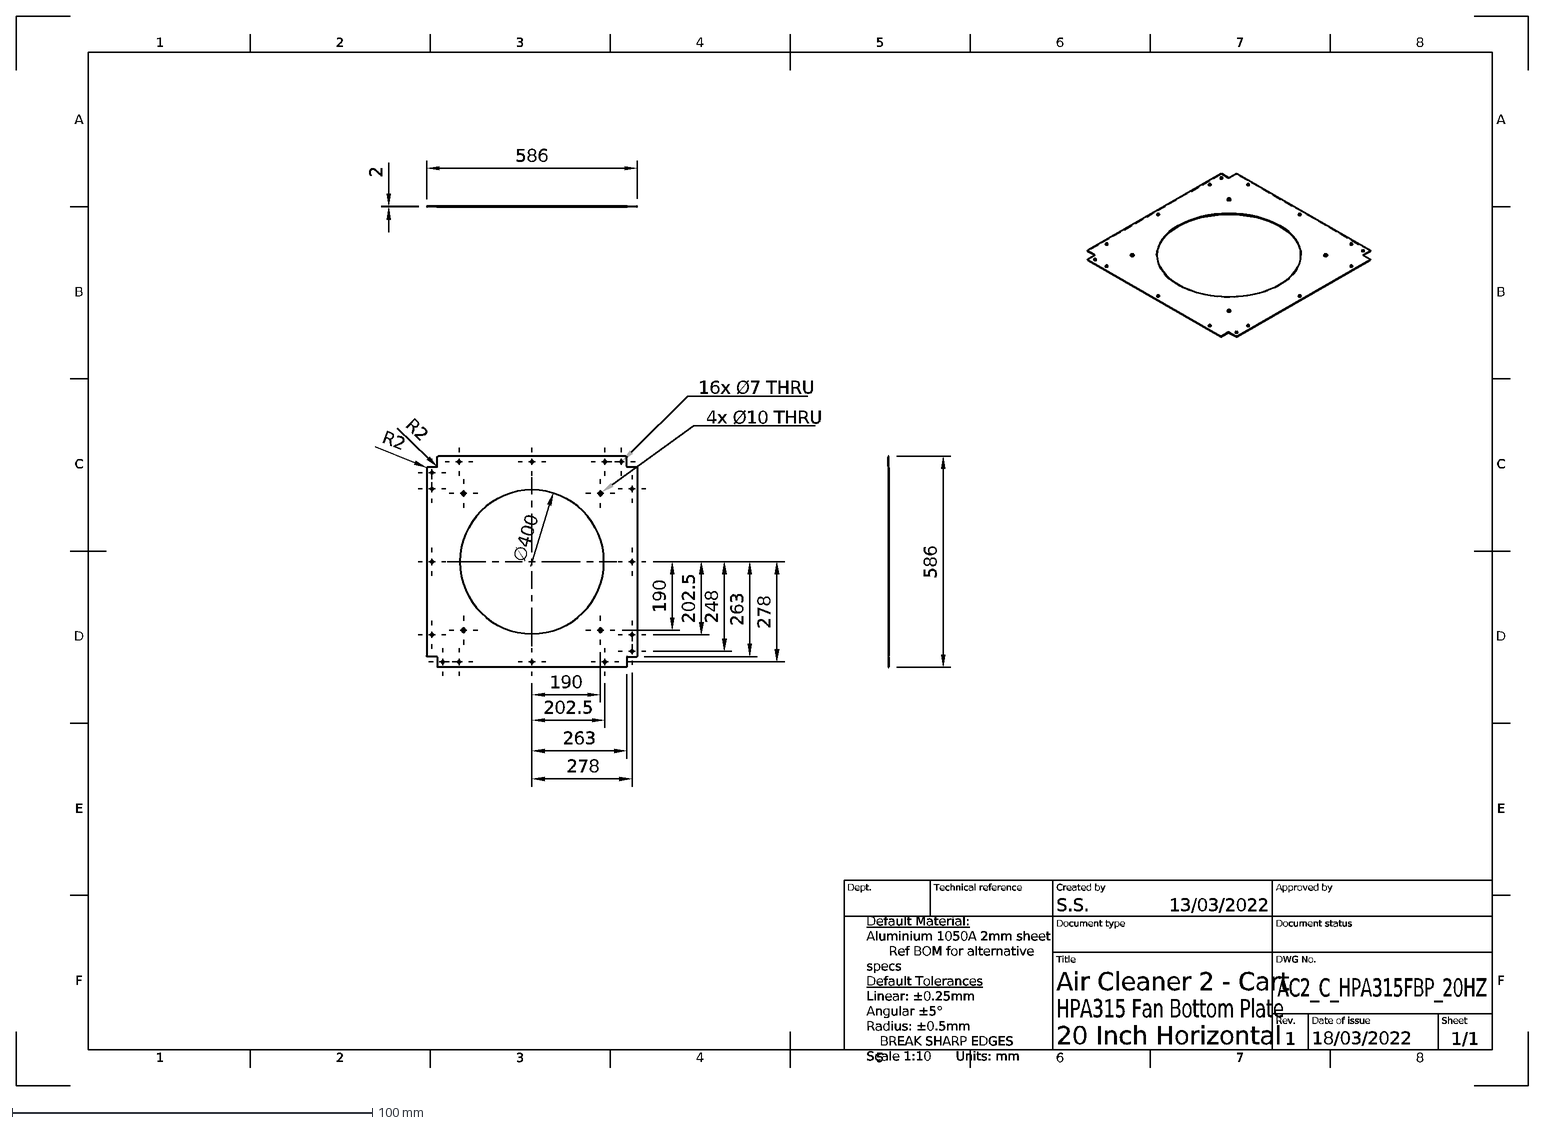
[picture p35: CAD file, 2022-03-18]
Air-Cleaner-2 Mechanical/DXF/AC2_C_HPA315FBP_20HZ_Rev1.dxf
1
A
2
3
4
5
6
7
8
B
C
D
E
F
18/03/2022
20 Inch Horizontal
13/03/2022
1/1
HPA315 Fan Bottom Plate
AC2_C_HPA315FBP_20HZ
Air Cleaner 2 - Cart
S.S.
Dept.
Technical reference
Created by
Approved by
Document type
Document status
Title
DWG No.
Rev.
Date of issue
Sheet
190
202.5
278
248
∅400
16x Ø7 THRU
4x Ø10 THRU
Default Material: Aluminium 1050A 2mm sheet Ref BOM for alternative specs Default Tolerances Linear: ±0.25mm Angular ±5° Radius: ±0.5mm BREAK SHARP EDGES Scale 
586
R2
263
