MechaFlowManiac/Air-Cleaner-2/Air-Cleaner-2 Mechanical/STP/AC2_C_EA_20VT_01.step

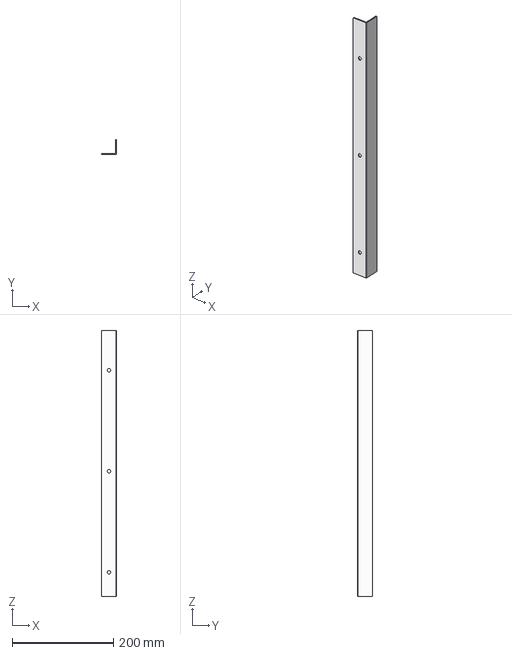
[picture p36: CAD file, 2022-03-18]
Air-Cleaner-2 Mechanical/STP/AC2_C_EA_20VT_01.step
30.0 x 30.0 x 526.0 mm
