MechaFlowManiac/Air-Cleaner-2/Air-Cleaner-2 Mechanical/STP/AC2_C_FEP_20HZ_02.step

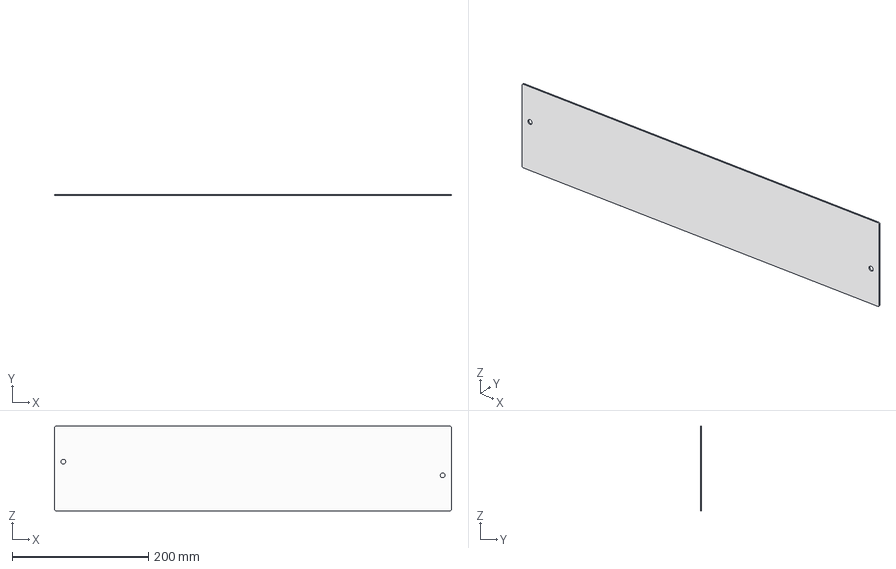
[picture p38: CAD file, 2022-03-18]
Air-Cleaner-2 Mechanical/STP/AC2_C_FEP_20HZ_02.step
582.0 x 2.00 x 124.0 mm
