MechaFlowManiac/Air-Cleaner-2/Air-Cleaner-2 Mechanical/STP/AC2_C_EA_16HZ_01.step

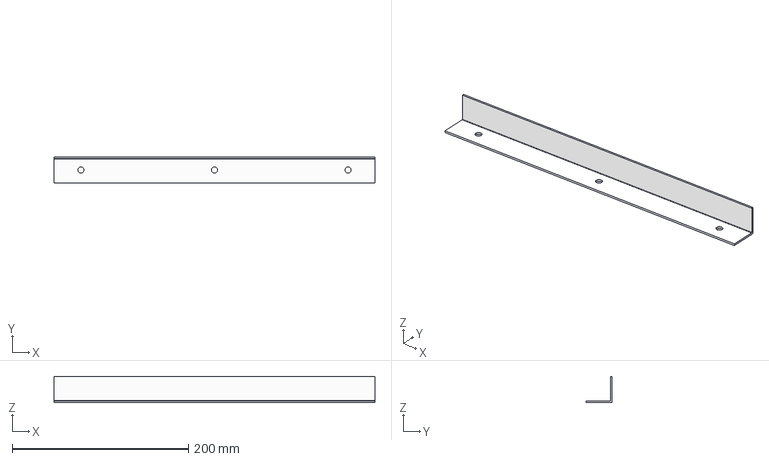
[picture p40: CAD file, 2022-03-18]
Air-Cleaner-2 Mechanical/STP/AC2_C_EA_16HZ_01.step
364.0 x 30.0 x 30.0 mm
