MechaFlowManiac/Air-Cleaner-2/Air-Cleaner-2 Mechanical/DXF/AC2_C_14CFTP_16HZ_Rev1.dxf

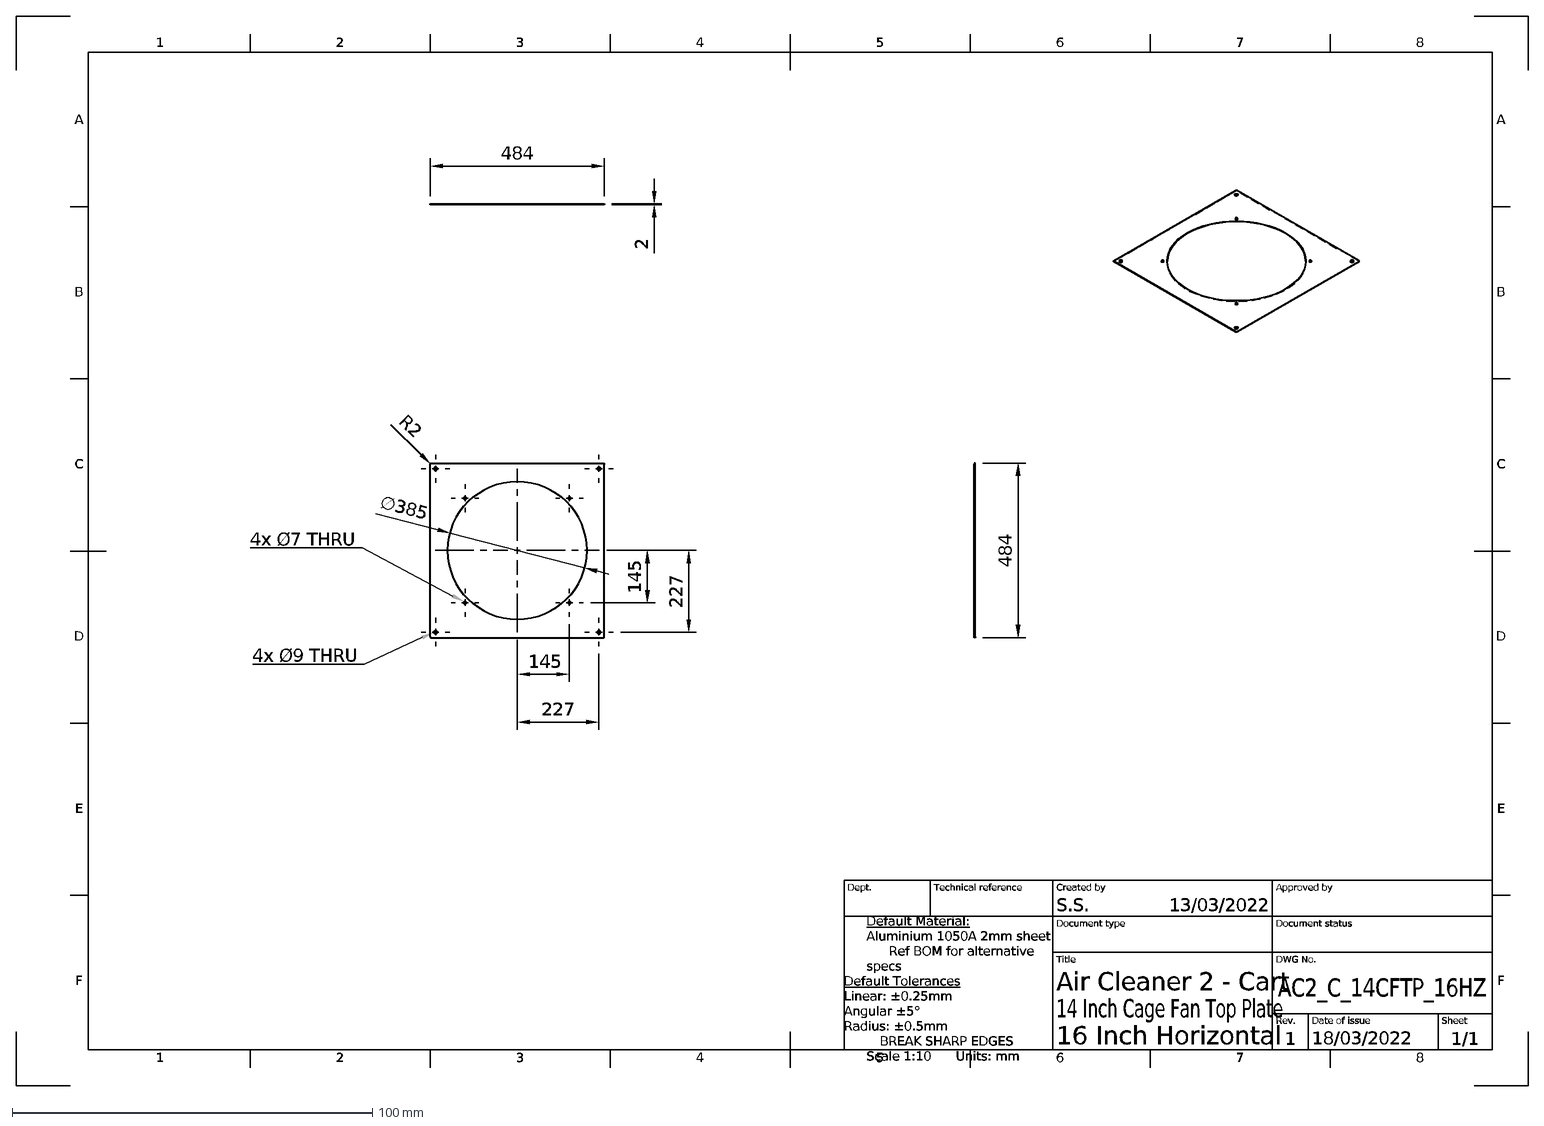
[picture p41: CAD file, 2022-03-18]
Air-Cleaner-2 Mechanical/DXF/AC2_C_14CFTP_16HZ_Rev1.dxf
1
A
2
3
4
5
6
7
8
B
C
D
E
F
18/03/2022
16 Inch Horizontal
13/03/2022
1/1
14 Inch Cage Fan Top Plate
AC2_C_14CFTP_16HZ
Air Cleaner 2 - Cart
S.S.
Dept.
Technical reference
Created by
Approved by
Document type
Document status
Title
DWG No.
Rev.
Date of issue
Sheet
484
4x Ø9 THRU
4x Ø7 THRU
Default Material: Aluminium 1050A 2mm sheet Ref BOM for alternative specs Default Tolerances Linear: ±0.25mm Angular ±5° Radius: ±0.5mm BREAK SHARP EDGES Scale 
145
227
∅385
R2
