MechaFlowManiac/Air-Cleaner-2/Air-Cleaner-2 Mechanical/STP/AC2_C_18CFBP_20HZ_02.step

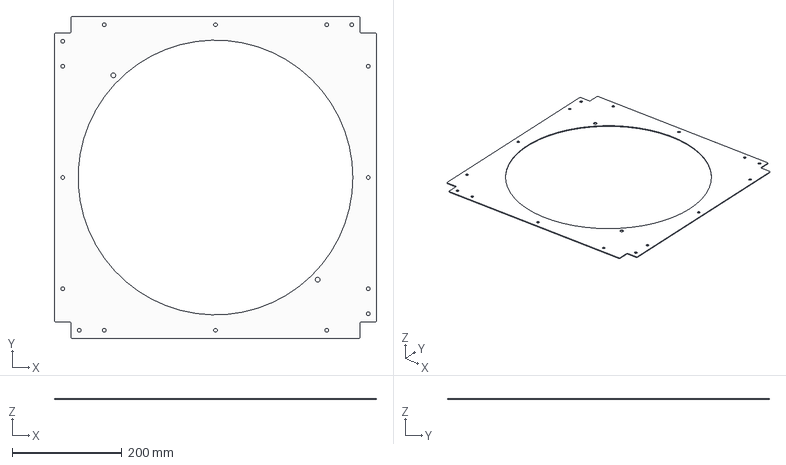
[picture p42: CAD file, 2022-03-18]
Air-Cleaner-2 Mechanical/STP/AC2_C_18CFBP_20HZ_02.step
586.0 x 586.0 x 2.00 mm
