MechaFlowManiac/Air-Cleaner-2/Air-Cleaner-2 Mechanical/STP/AC2_C_EA_20HZ_01.step

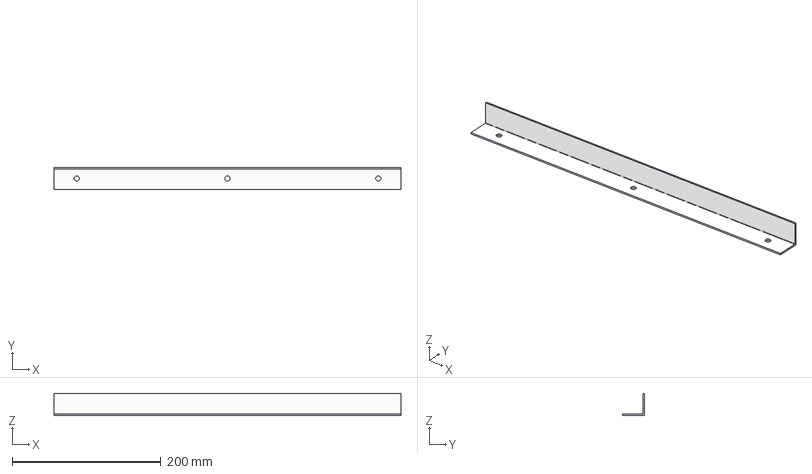
[picture p44: CAD file, 2022-03-18]
Air-Cleaner-2 Mechanical/STP/AC2_C_EA_20HZ_01.step
466.0 x 30.0 x 30.0 mm
