MechaFlowManiac/Air-Cleaner-2/Air-Cleaner-2 Mechanical/STP/AC2_B_FCT_01.step

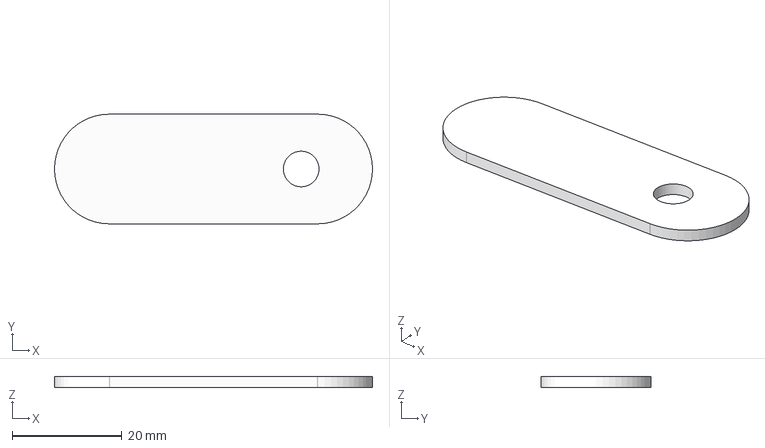
[picture p48: CAD file, 2022-03-18]
Air-Cleaner-2 Mechanical/STP/AC2_B_FCT_01.step
58.0 x 20.0 x 2.00 mm
