MechaFlowManiac/Air-Cleaner-2/Air-Cleaner-2 Mechanical/DXF/AC2_B_FCT_Rev1.dxf

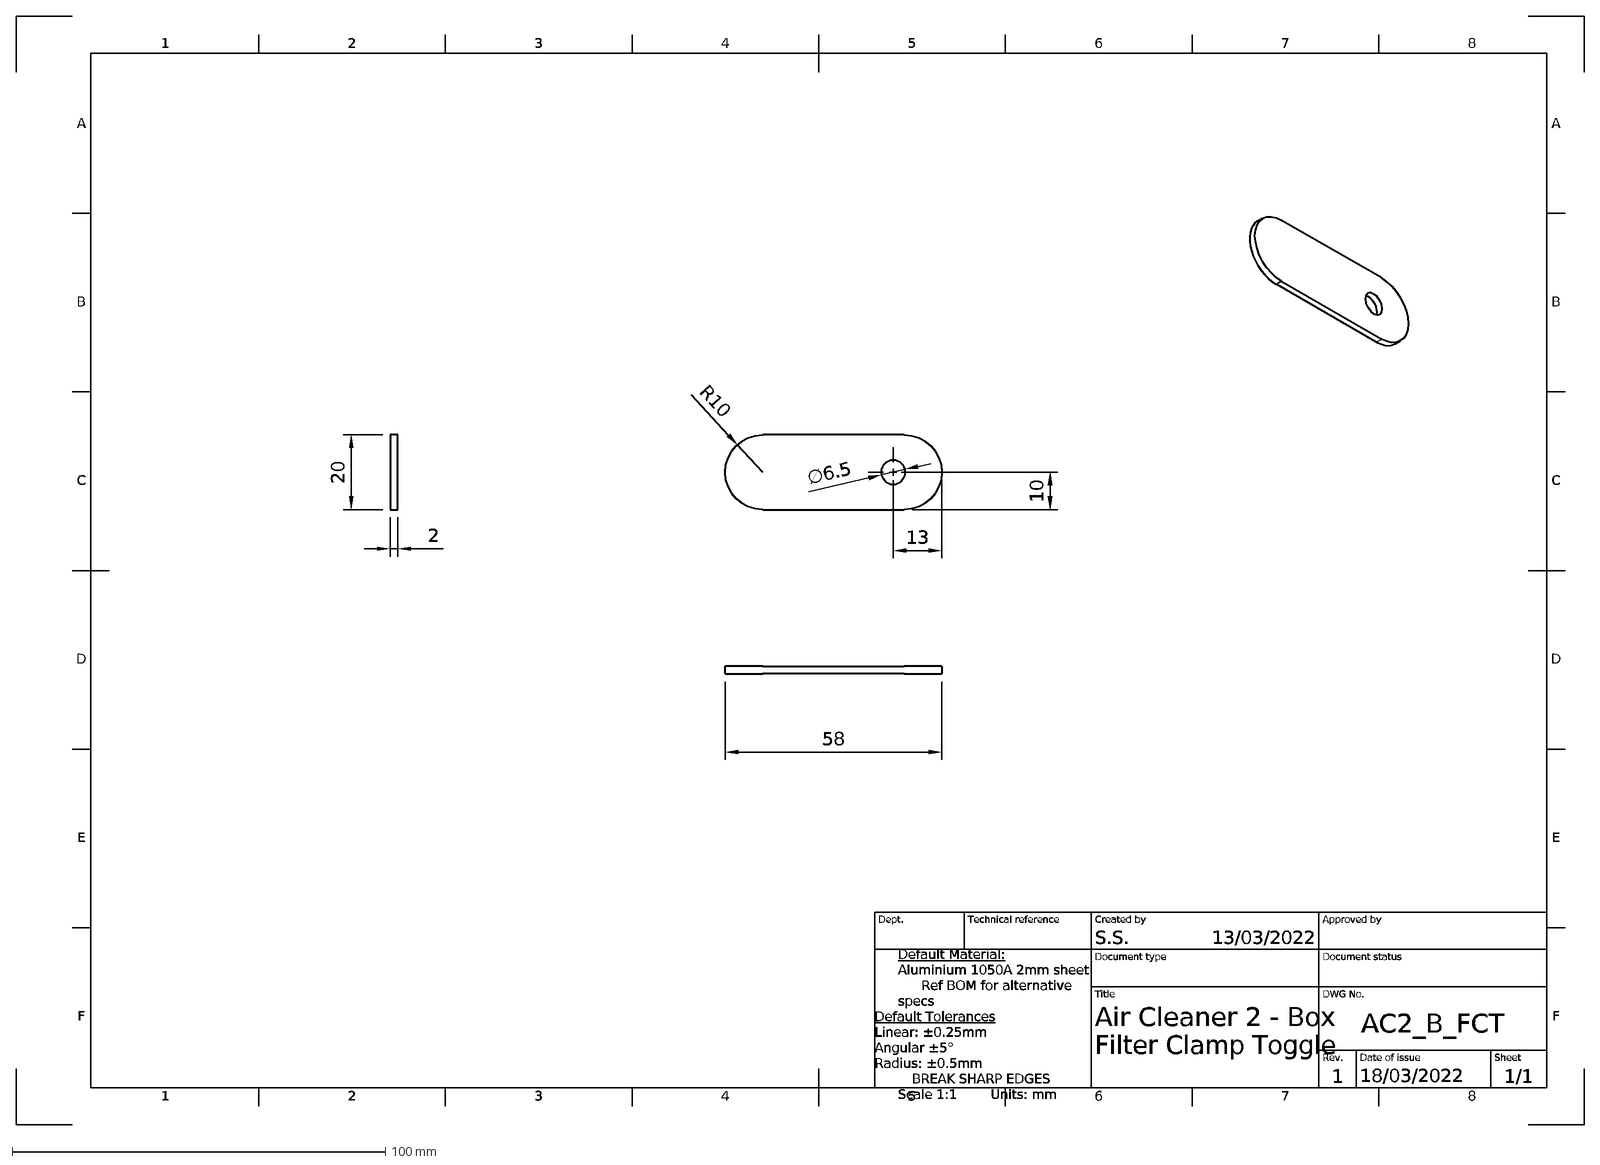
[picture p49: CAD file, 2022-03-18]
Air-Cleaner-2 Mechanical/DXF/AC2_B_FCT_Rev1.dxf
1
A
2
3
4
5
6
7
8
B
C
D
E
F
18/03/2022
13/03/2022
1/1
Filter Clamp Toggle
AC2_B_FCT
Air Cleaner 2 - Box
S.S.
Dept.
Technical reference
Created by
Approved by
Document type
Document status
Title
DWG No.
Rev.
Date of issue
Sheet
10
R10
∅6.5
58
13
Default Material: Aluminium 1050A 2mm sheet Ref BOM for alternative specs Default Tolerances Linear: ±0.25mm Angular ±5° Radius: ±0.5mm BREAK SHARP EDGES Scale 
20
