MechaFlowManiac/Air-Cleaner-2/Air-Cleaner-2 Mechanical/STP/AC2_C_FCP_24VT_01.step

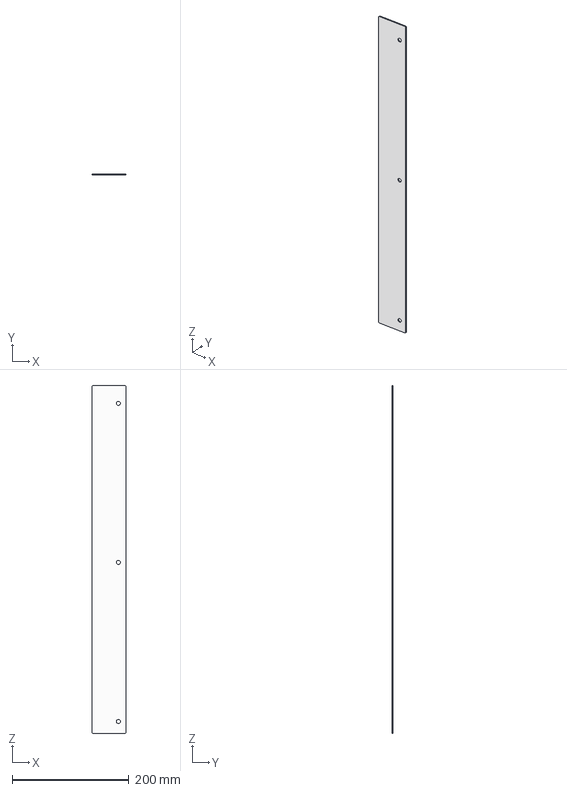
[picture p56: CAD file, 2022-03-18]
Air-Cleaner-2 Mechanical/STP/AC2_C_FCP_24VT_01.step
58.0 x 2.00 x 595.0 mm
