MechaFlowManiac/Air-Cleaner-2/Air-Cleaner-2 Mechanical/STP/AC2_C_HPA315FBP_20HZ_01.step

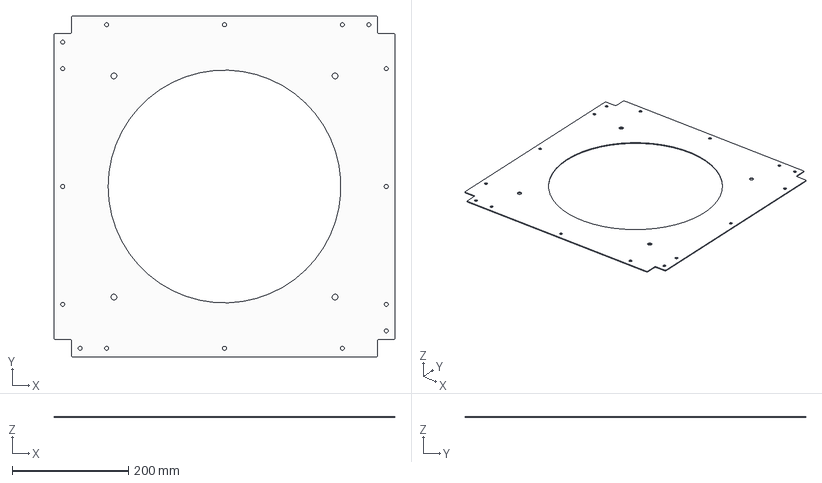
[picture p58: CAD file, 2022-03-18]
Air-Cleaner-2 Mechanical/STP/AC2_C_HPA315FBP_20HZ_01.step
586.0 x 586.0 x 2.00 mm
