MechaFlowManiac/Air-Cleaner-2/Air-Cleaner-2 Mechanical/STP/AC2_C_ASC_20HZ25VT_01.step

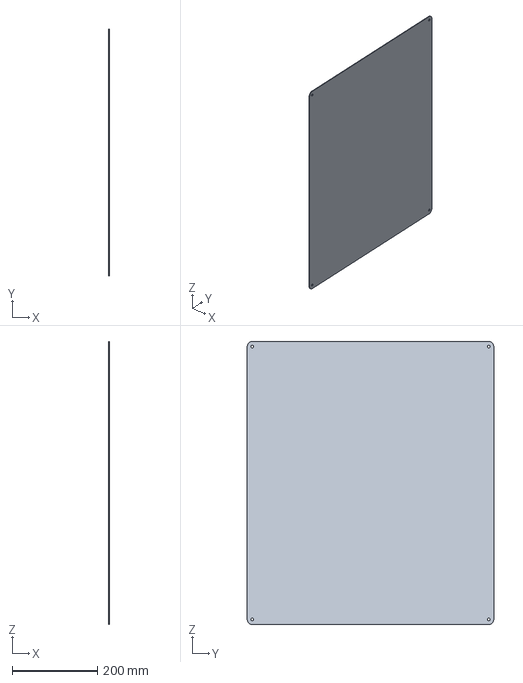
[picture p61: CAD file, 2022-03-18]
Air-Cleaner-2 Mechanical/STP/AC2_C_ASC_20HZ25VT_01.step
2.00 x 580.0 x 665.5 mm
