MechaFlowManiac/Air-Cleaner-2/Air-Cleaner-2 Mechanical/STP/AC2_C_EA_25VT_01.step

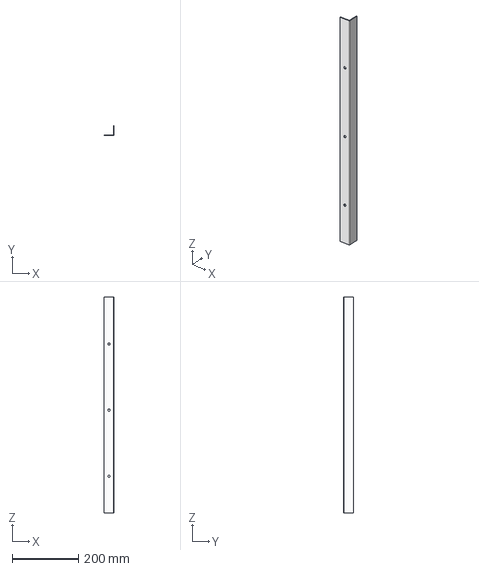
[picture p63: CAD file, 2022-03-18]
Air-Cleaner-2 Mechanical/STP/AC2_C_EA_25VT_01.step
30.0 x 30.0 x 653.0 mm
