MechaFlowManiac/Air-Cleaner-2/Air-Cleaner-2 Mechanical/DXF/AC2_C_EA_16HZ_Rev1.dxf

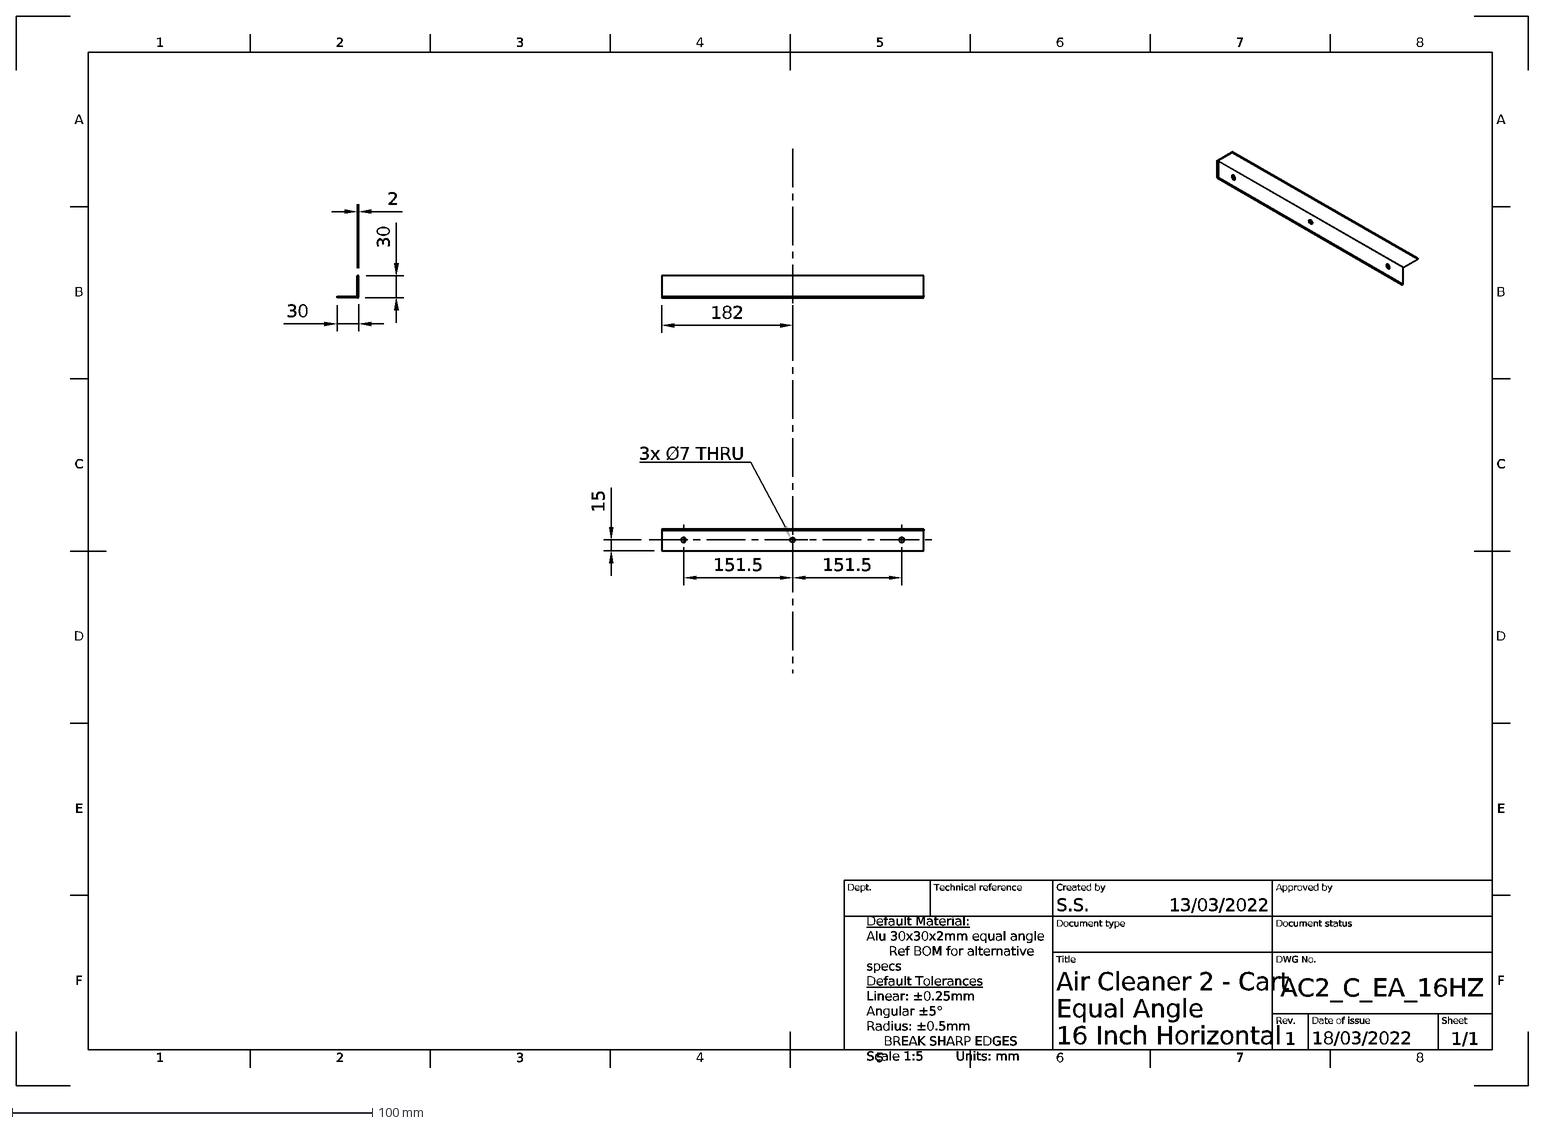
[picture p64: CAD file, 2022-03-18]
Air-Cleaner-2 Mechanical/DXF/AC2_C_EA_16HZ_Rev1.dxf
1
A
2
3
4
5
6
7
8
B
C
D
E
F
18/03/2022
16 Inch Horizontal
13/03/2022
1/1
Equal Angle
AC2_C_EA_16HZ
Air Cleaner 2 - Cart
S.S.
Dept.
Technical reference
Created by
Approved by
Document type
Document status
Title
DWG No.
Rev.
Date of issue
Sheet
30
151.5
Default Material: Alu 30x30x2mm equal angle Ref BOM for alternative specs Default Tolerances Linear: ±0.25mm Angular ±5° Radius: ±0.5mm BREAK SHARP EDGES Scale 
3x Ø7 THRU
15
182
