MechaFlowManiac/Air-Cleaner-2/Air-Cleaner-2 Mechanical/STP/AC2_C_14CFBP_16HZ_01.step

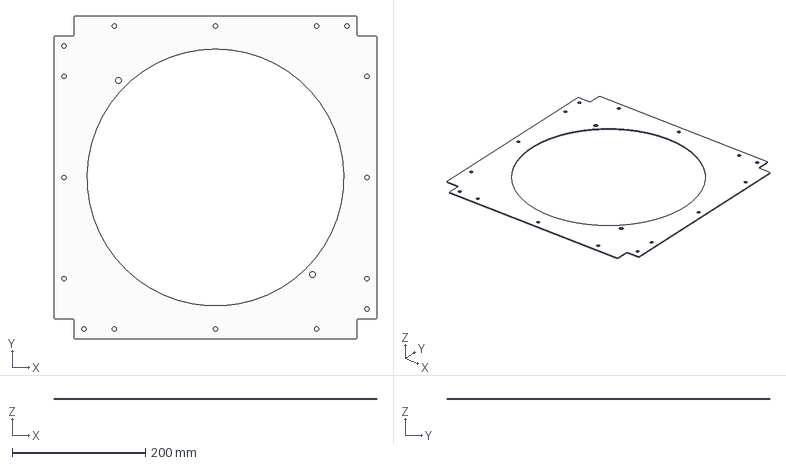
[picture p67: CAD file, 2022-03-18]
Air-Cleaner-2 Mechanical/STP/AC2_C_14CFBP_16HZ_01.step
484.0 x 484.0 x 2.00 mm
