MechaFlowManiac/Air-Cleaner-2/Air-Cleaner-2 Mechanical/DXF/AC2_C_BP_20HZ_Rev1.dxf

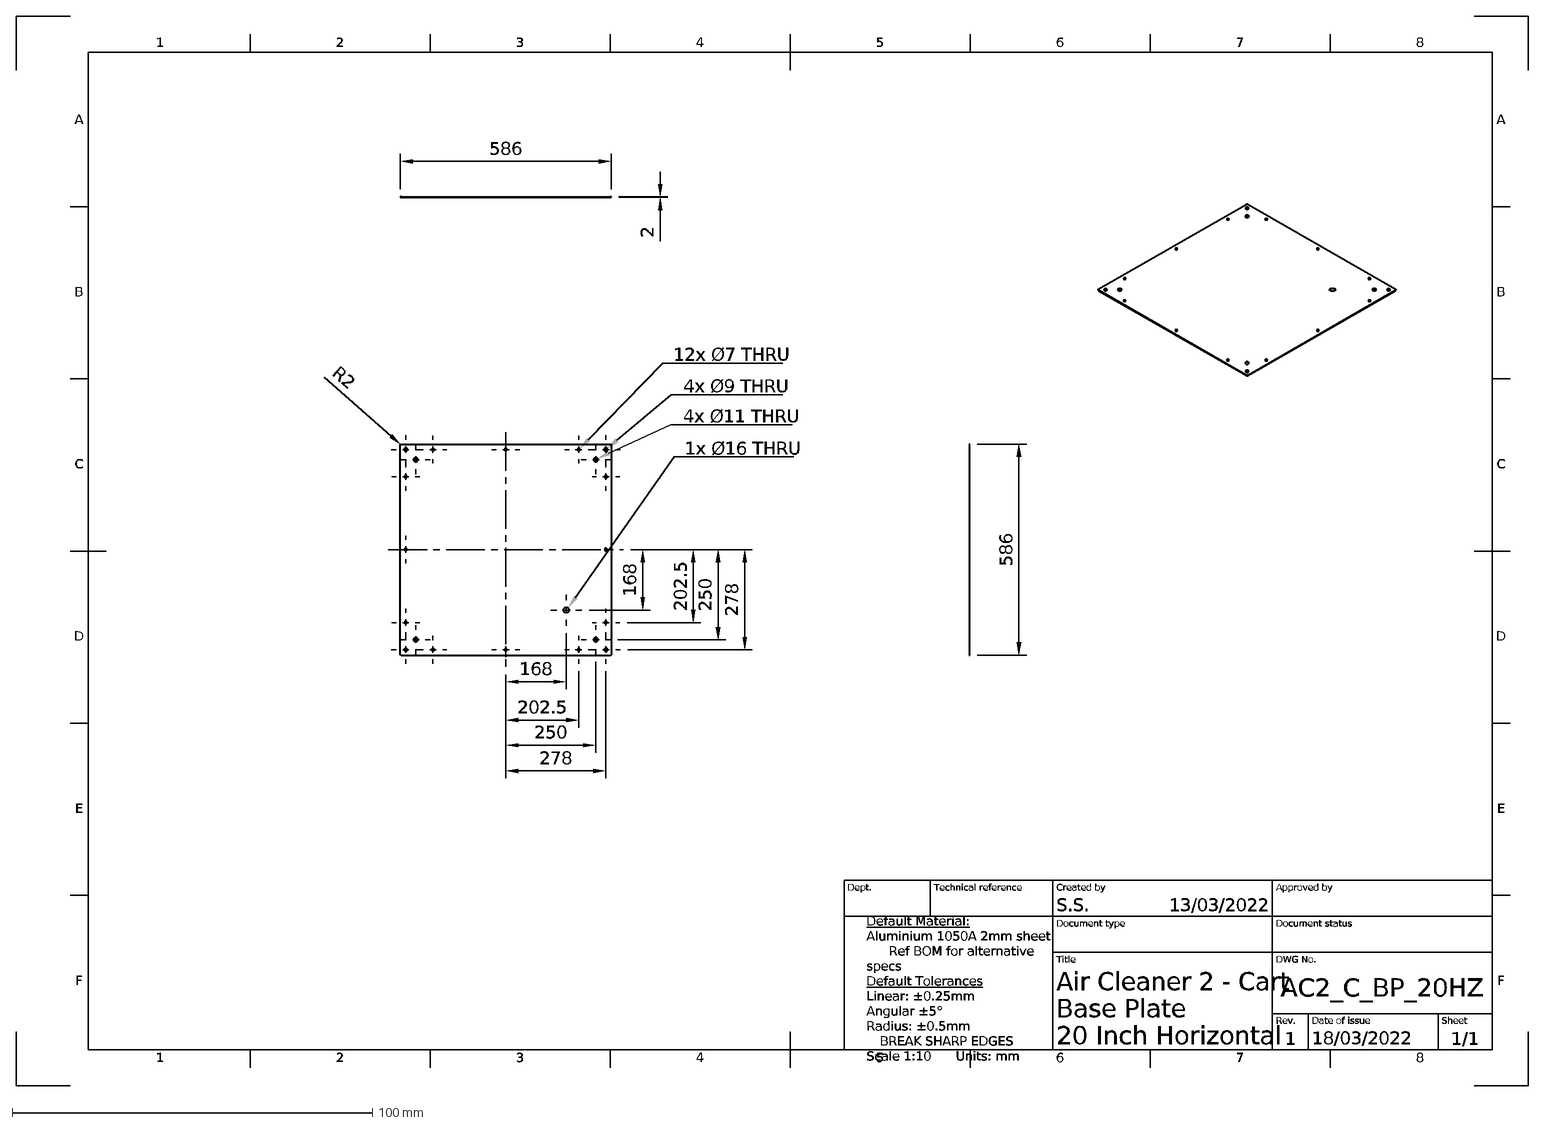
[picture p72: CAD file, 2022-03-18]
Air-Cleaner-2 Mechanical/DXF/AC2_C_BP_20HZ_Rev1.dxf
1
A
2
3
4
5
6
7
8
B
C
D
E
F
18/03/2022
20 Inch Horizontal
13/03/2022
1/1
Base Plate
AC2_C_BP_20HZ
Air Cleaner 2 - Cart
S.S.
Dept.
Technical reference
Created by
Approved by
Document type
Document status
Title
DWG No.
Rev.
Date of issue
Sheet
586
1x Ø16 THRU
4x Ø11 THRU
12x Ø7 THRU
Default Material: Aluminium 1050A 2mm sheet Ref BOM for alternative specs Default Tolerances Linear: ±0.25mm Angular ±5° Radius: ±0.5mm BREAK SHARP EDGES Scale 
R2
4x Ø9 THRU
168
202.5
250
278
