MechaFlowManiac/Air-Cleaner-2/Air-Cleaner-2 Mechanical/DXF/AC2_C_TST_20VT_Rev1.dxf

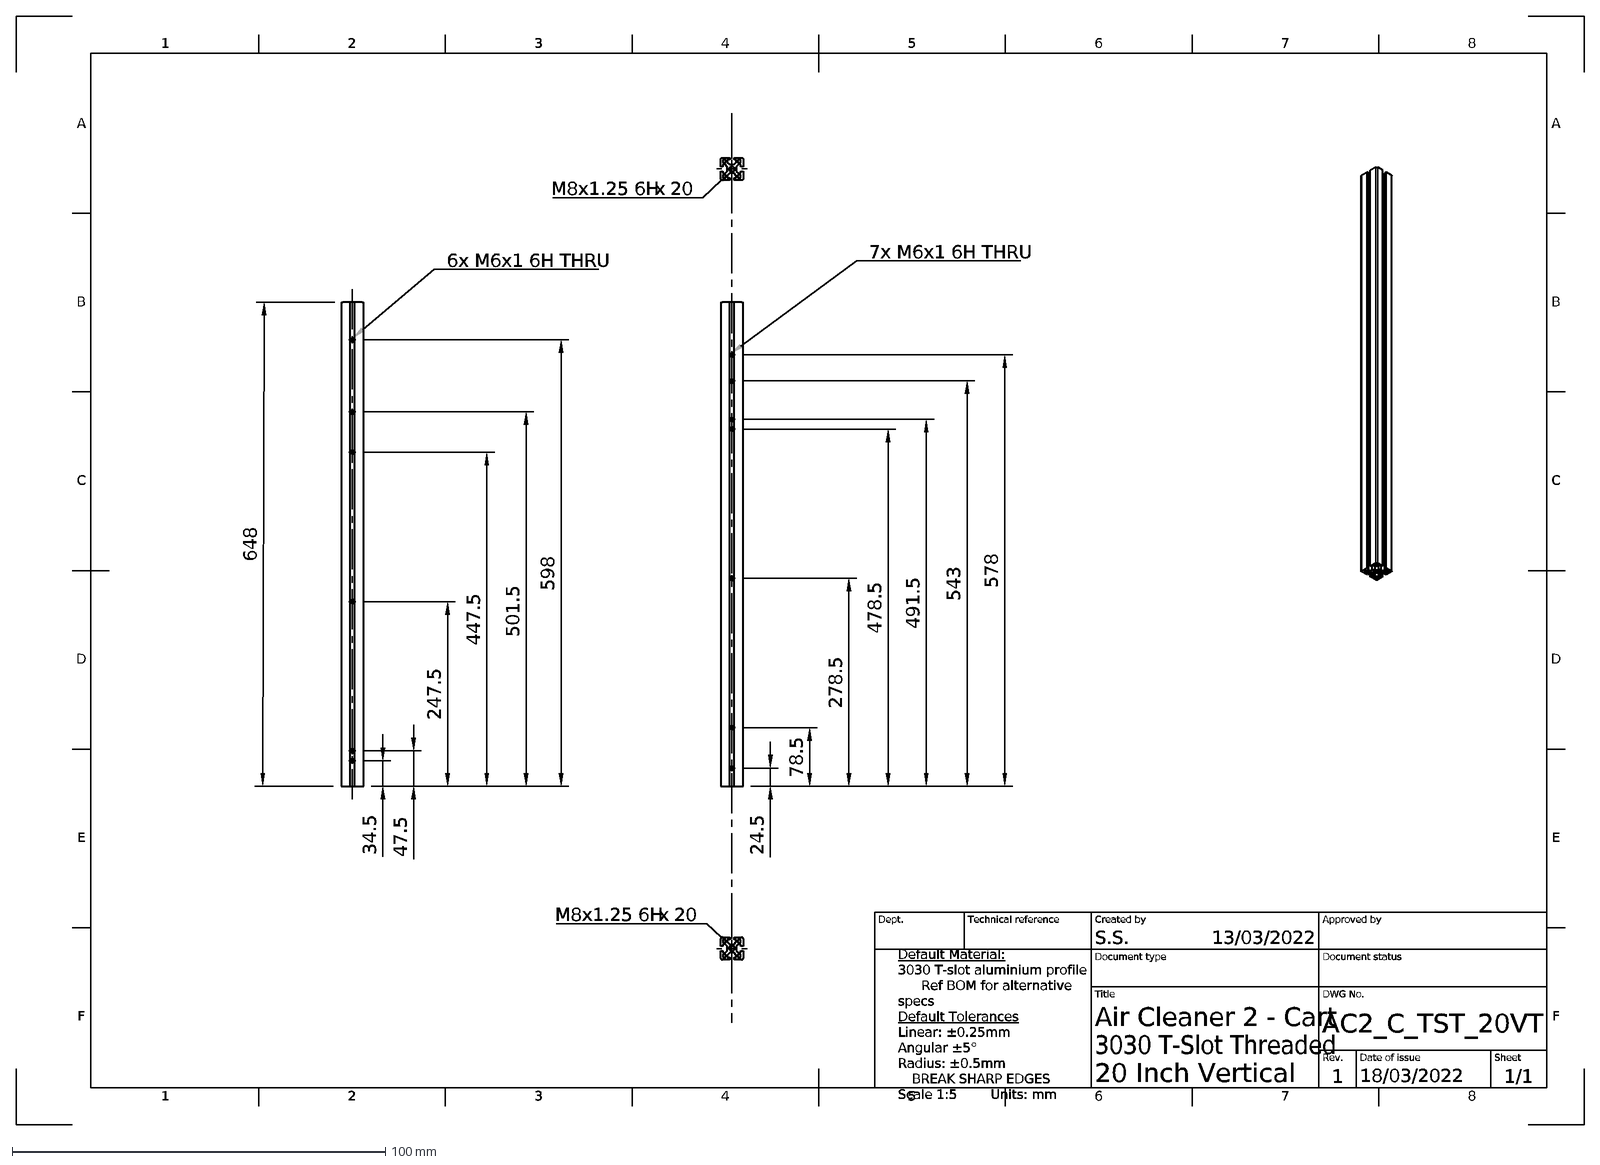
[picture p73: CAD file, 2022-03-18]
Air-Cleaner-2 Mechanical/DXF/AC2_C_TST_20VT_Rev1.dxf
1
A
2
3
4
5
6
7
8
B
C
D
E
F
18/03/2022
20 Inch Vertical
13/03/2022
1/1
3030 T-Slot Threaded
AC2_C_TST_20VT
Air Cleaner 2 - Cart
S.S.
Dept.
Technical reference
Created by
Approved by
Document type
Document status
Title
DWG No.
Rev.
Date of issue
Sheet
648
M8x1.25 6H
20
Default Material: 3030 T-slot aluminium profile Ref BOM for alternative specs Default Tolerances Linear: ±0.25mm Angular ±5° Radius: ±0.5mm BREAK SHARP EDGES Sc
7x M6x1 6H THRU
6x M6x1 6H THRU
34.5
47.5
247.5
447.5
501.5
598
24.5
78.5
278.5
478.5
491.5
578
543
