MechaFlowManiac/Air-Cleaner-2/Air-Cleaner-2 Mechanical/DXF/AC2_C_18CFBP_20HZ_Rev2.dxf

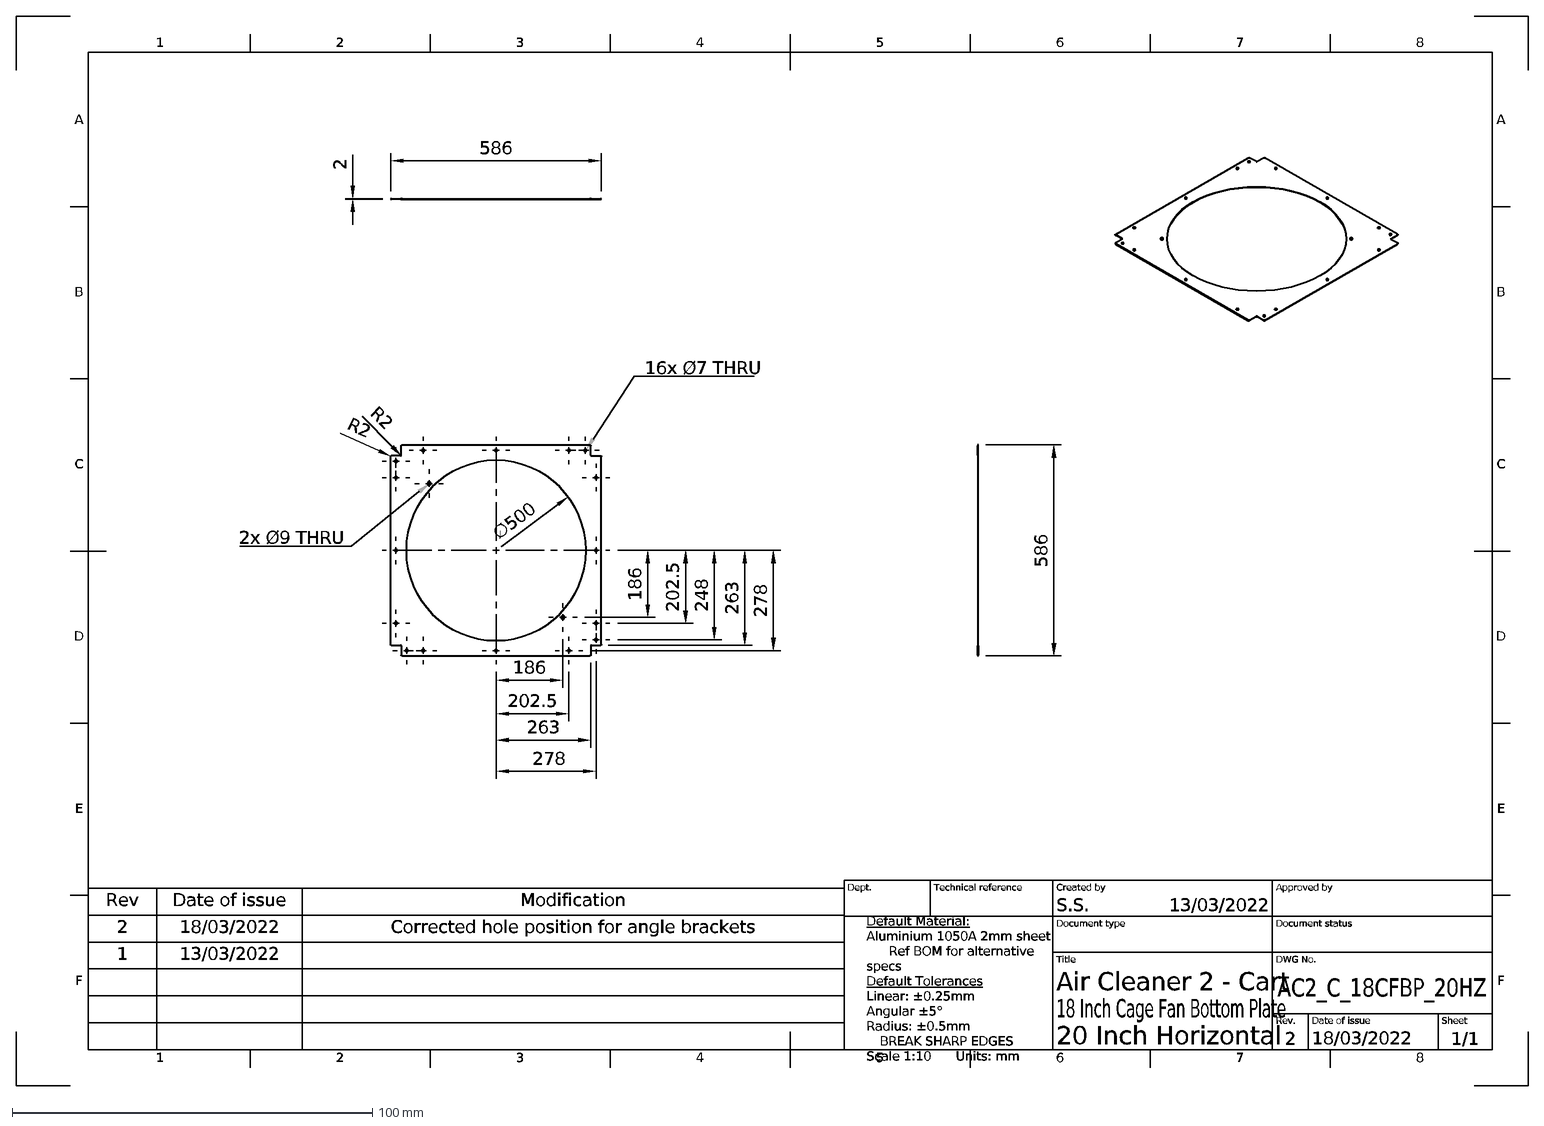
[picture p77: CAD file, 2022-03-18]
Air-Cleaner-2 Mechanical/DXF/AC2_C_18CFBP_20HZ_Rev2.dxf
1
A
2
3
4
5
6
7
8
B
C
D
E
F
18/03/2022
20 Inch Horizontal
13/03/2022
1/1
18 Inch Cage Fan Bottom Plate
AC2_C_18CFBP_20HZ
Air Cleaner 2 - Cart
S.S.
Dept.
Technical reference
Created by
Approved by
Document type
Document status
Title
DWG No.
Rev.
Date of issue
Sheet
∅500
16x Ø7 THRU
Default Material: Aluminium 1050A 2mm sheet Ref BOM for alternative specs Default Tolerances Linear: ±0.25mm Angular ±5° Radius: ±0.5mm BREAK SHARP EDGES Scale 
2x Ø9 THRU
278
186
202.5
248
263
586
Corrected hole position for angle brackets
Rev
Modification
R2
