MechaFlowManiac/Air-Cleaner-2/Air-Cleaner-2 Mechanical/DXF/AC2_B_TST_20VT_Rev1.dxf

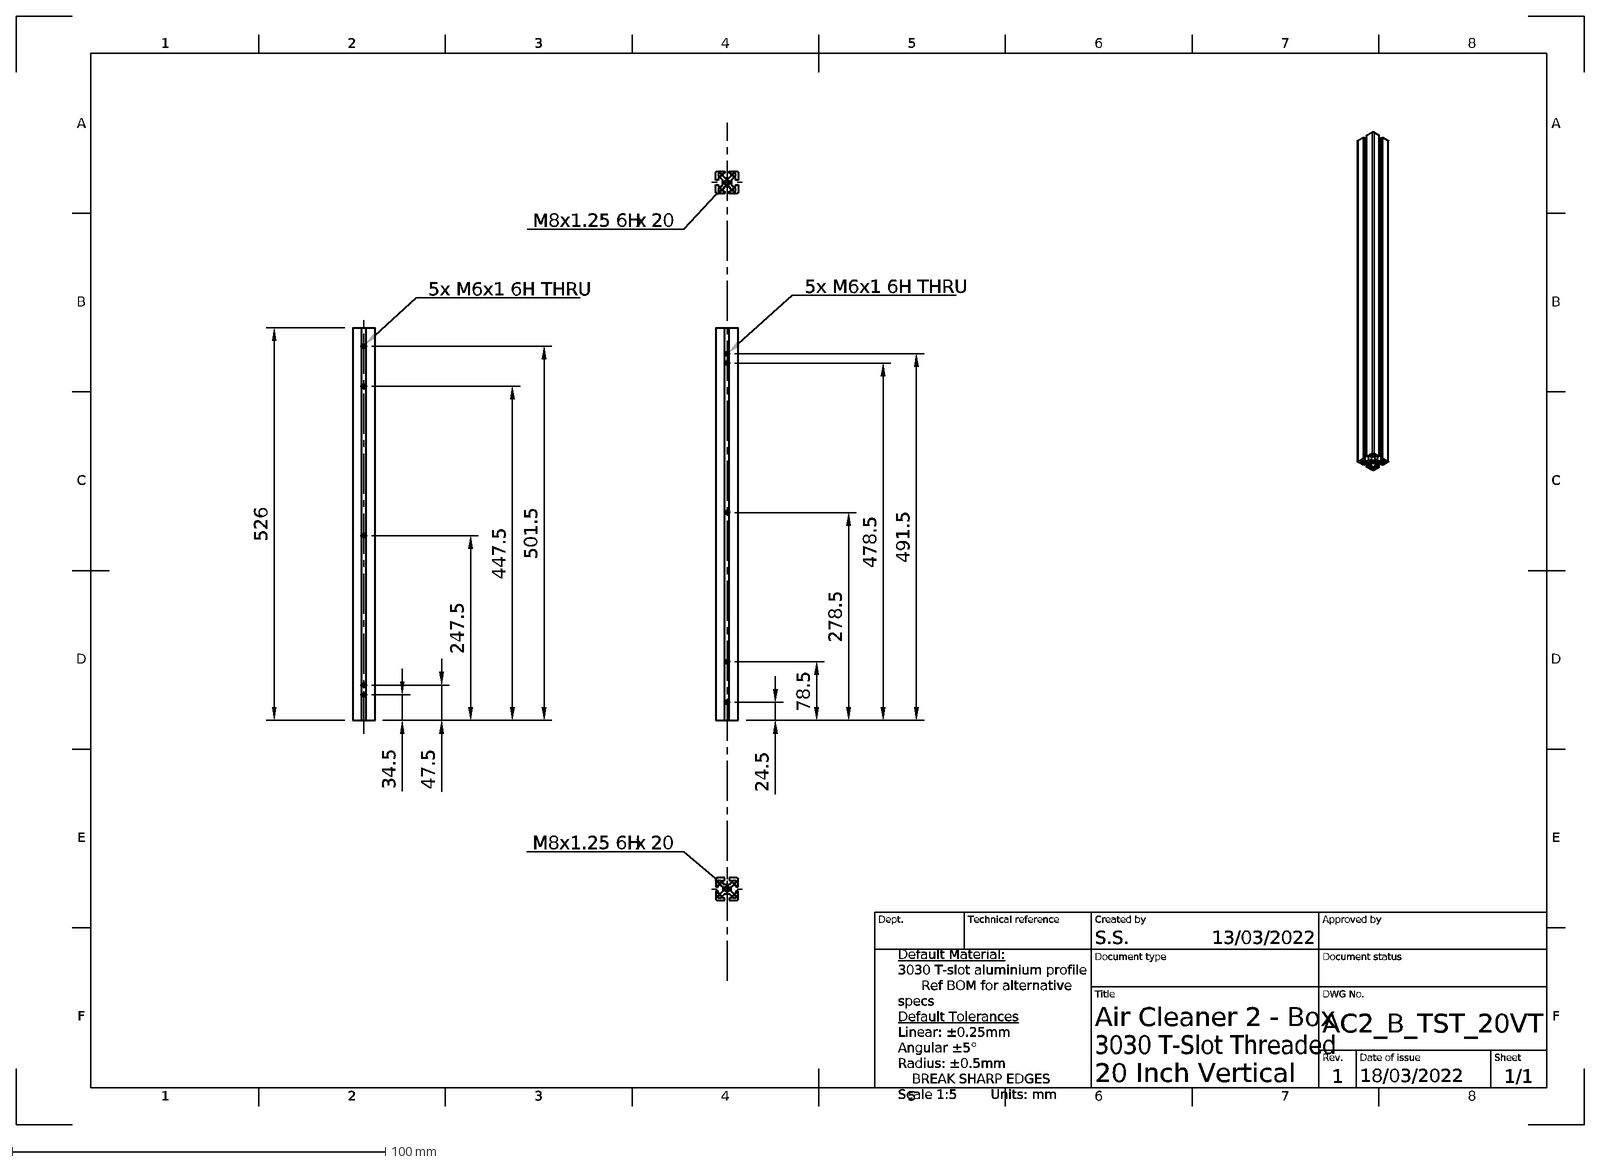
[picture p78: CAD file, 2022-03-18]
Air-Cleaner-2 Mechanical/DXF/AC2_B_TST_20VT_Rev1.dxf
1
A
2
3
4
5
6
7
8
B
C
D
E
F
18/03/2022
20 Inch Vertical
13/03/2022
1/1
3030 T-Slot Threaded
AC2_B_TST_20VT
Air Cleaner 2 - Box
S.S.
Dept.
Technical reference
Created by
Approved by
Document type
Document status
Title
DWG No.
Rev.
Date of issue
Sheet
24.5
78.5
278.5
478.5
491.5
M8x1.25 6H
20
526
34.5
47.5
247.5
447.5
501.5
5x M6x1 6H THRU
Default Material: 3030 T-slot aluminium profile Ref BOM for alternative specs Default Tolerances Linear: ±0.25mm Angular ±5° Radius: ±0.5mm BREAK SHARP EDGES Sc
