MechaFlowManiac/Air-Cleaner-2/(list of files, cad)

Other CAD files:
Air-Cleaner-2 Mechanical/STP/AC2_B_18CFBP_20HZ_01.step
Air-Cleaner-2 Mechanical/STP/AC2_C_BP_16HZ_01.step
Air-Cleaner-2 Mechanical/STP/AC2_B_14CFBP_16HZ_01.step
Air-Cleaner-2 Mechanical/STP/AC2_C_20BXFTP_20HZ_01.step
Air-Cleaner-2 Mechanical/STP/AC2_B_BP_20HZ_01.step
Air-Cleaner-2 Mechanical/STP/AC2_C_20BXFBP_20HZ_01.step
Air-Cleaner-2 Mechanical/STP/AC2_C_HPA400FBP_20HZ_01.step
