MechaFlowManiac/Air-Cleaner-2/Air-Cleaner-2 Mechanical/PDF/AC2_B_14CFBP_16HZ_Rev1.pdf

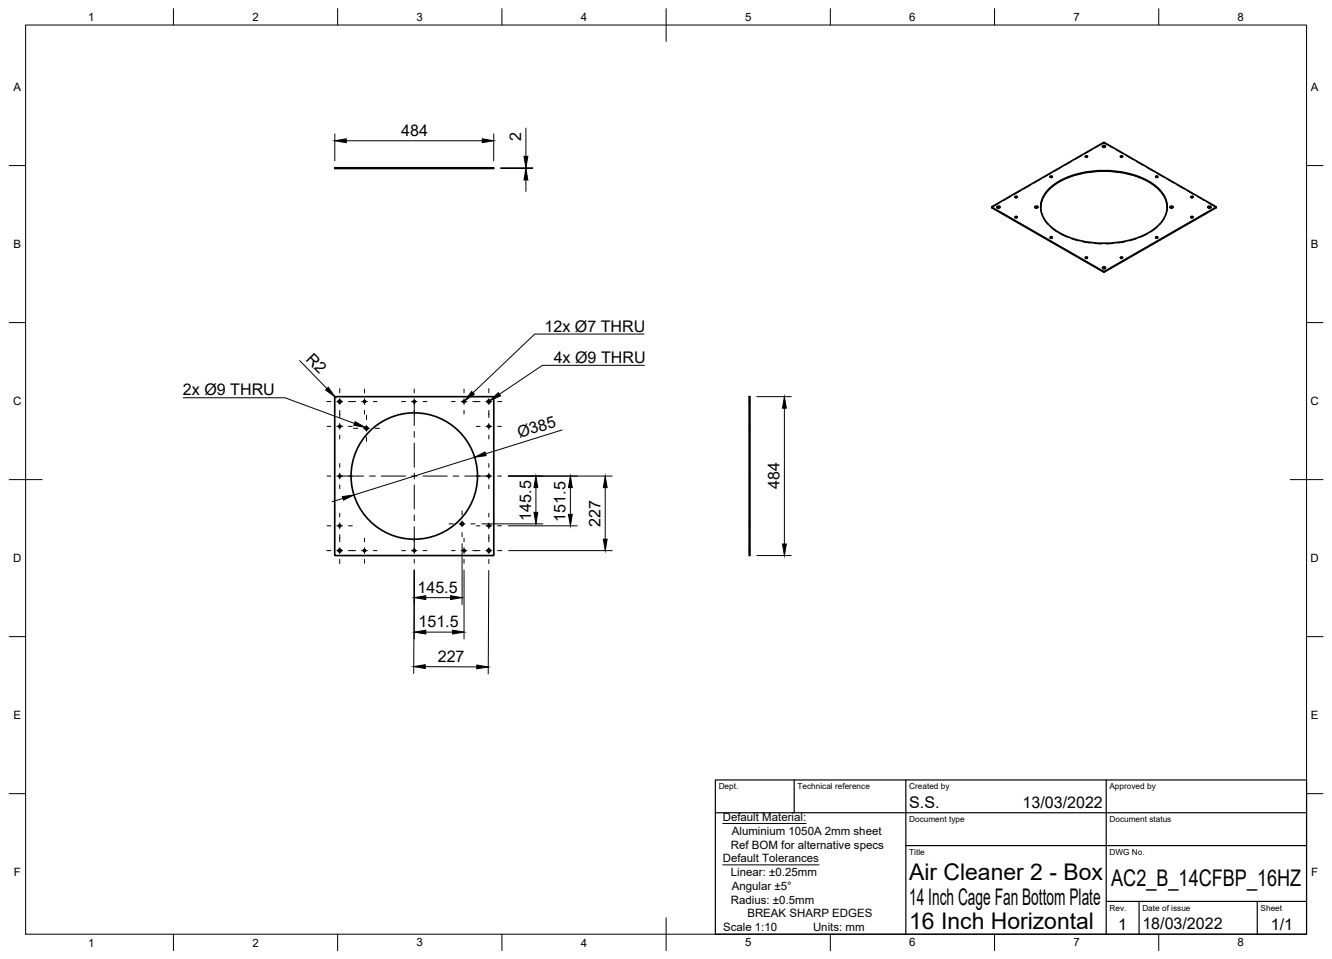
[picture p80: page 1]
Title; DWG No.; Rev.; Date of issue; Sheet; 16 Inch Horizontal; Air Cleaner 2 - Box; AC2_B_14CFBP_16HZ; R2 4x Ø9 THRU; 12x Ø7 THRU; 2x Ø9 THRU; Scale 1:10; Units: mm

Dept. | Technical reference | Created by S.S. 13/03/2022 | Approved by

Default Material:
Aluminium 1050A 2mm sheet
Ref BOM for alternative specs
Default Tolerances
Linear: ±0.25mm
Angular ±5°
Radius: ±0.5mm
BREAK SHARP EDGES

Document type | Document status

14 Inch Cage Fan Bottom Plate
