MechaFlowManiac/Air-Cleaner-2/Air-Cleaner-2 Mechanical/PDF/AC2_B_18CFBP_20HZ_Rev1.pdf

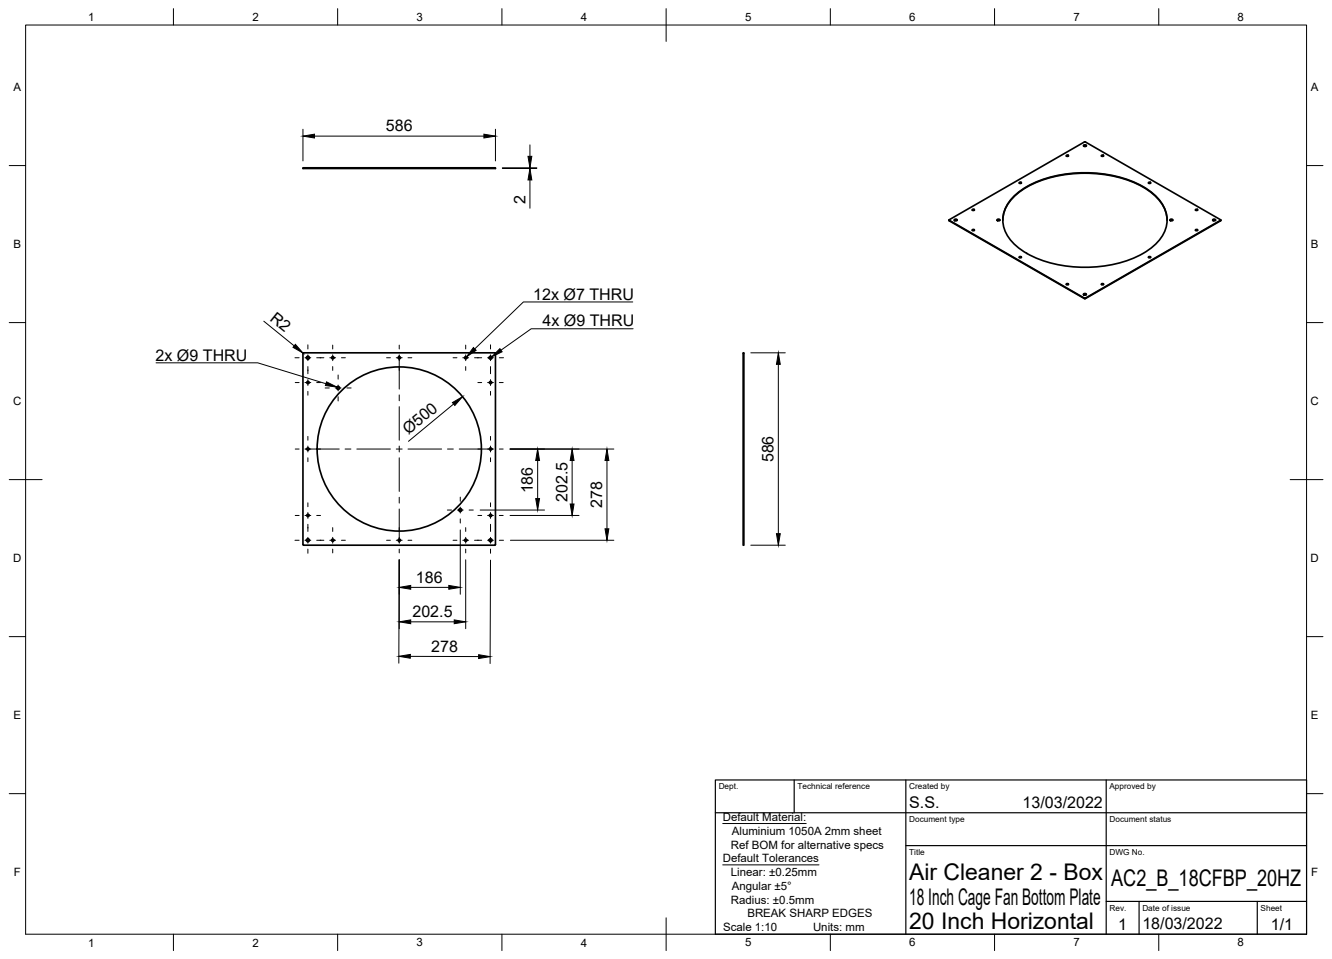
[picture p81: page 1]
Title; DWG No.; Rev.; Date of issue; Sheet; 20 Inch Horizontal; Air Cleaner 2 - Box; AC2_B_18CFBP_20HZ; 4x Ø9 THRU; 12x Ø7 THRU; Scale 1:10; Units: mm; 2x Ø9 THRU

Dept. | Technical reference | Created by S.S. 13/03/2022 | Approved by

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

Document type | Document status

18 Inch Cage Fan Bottom Plate
