MechaFlowManiac/Air-Cleaner-2/Air-Cleaner-2 Mechanical/PDF/AC2_B_FCT_Rev1.pdf

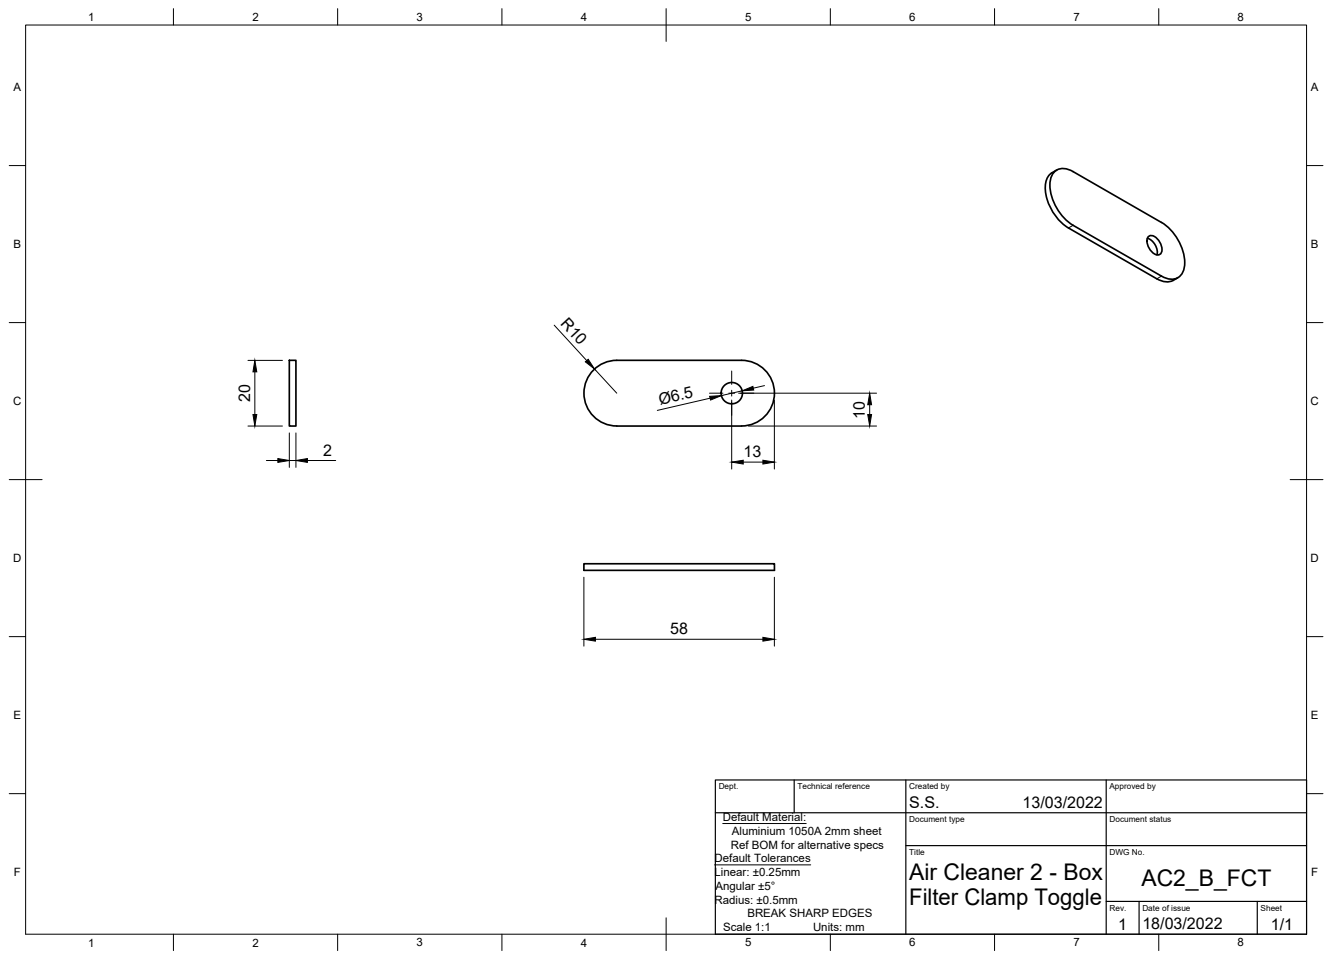
[picture p82: page 1]
Title; DWG No.; Rev.; Date of issue; Sheet; Air Cleaner 2 - Box; AC2_B_FCT; Scale 1:1; Units: mm 20

Dept. | Technical reference | Created by 13/03/2022 | Approved by

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

Document type | Document status

Filter Clamp Toggle
