MechaFlowManiac/Air-Cleaner-2/Air-Cleaner-2 Mechanical/PDF/AC2_B_TST_20VT_Rev1.pdf

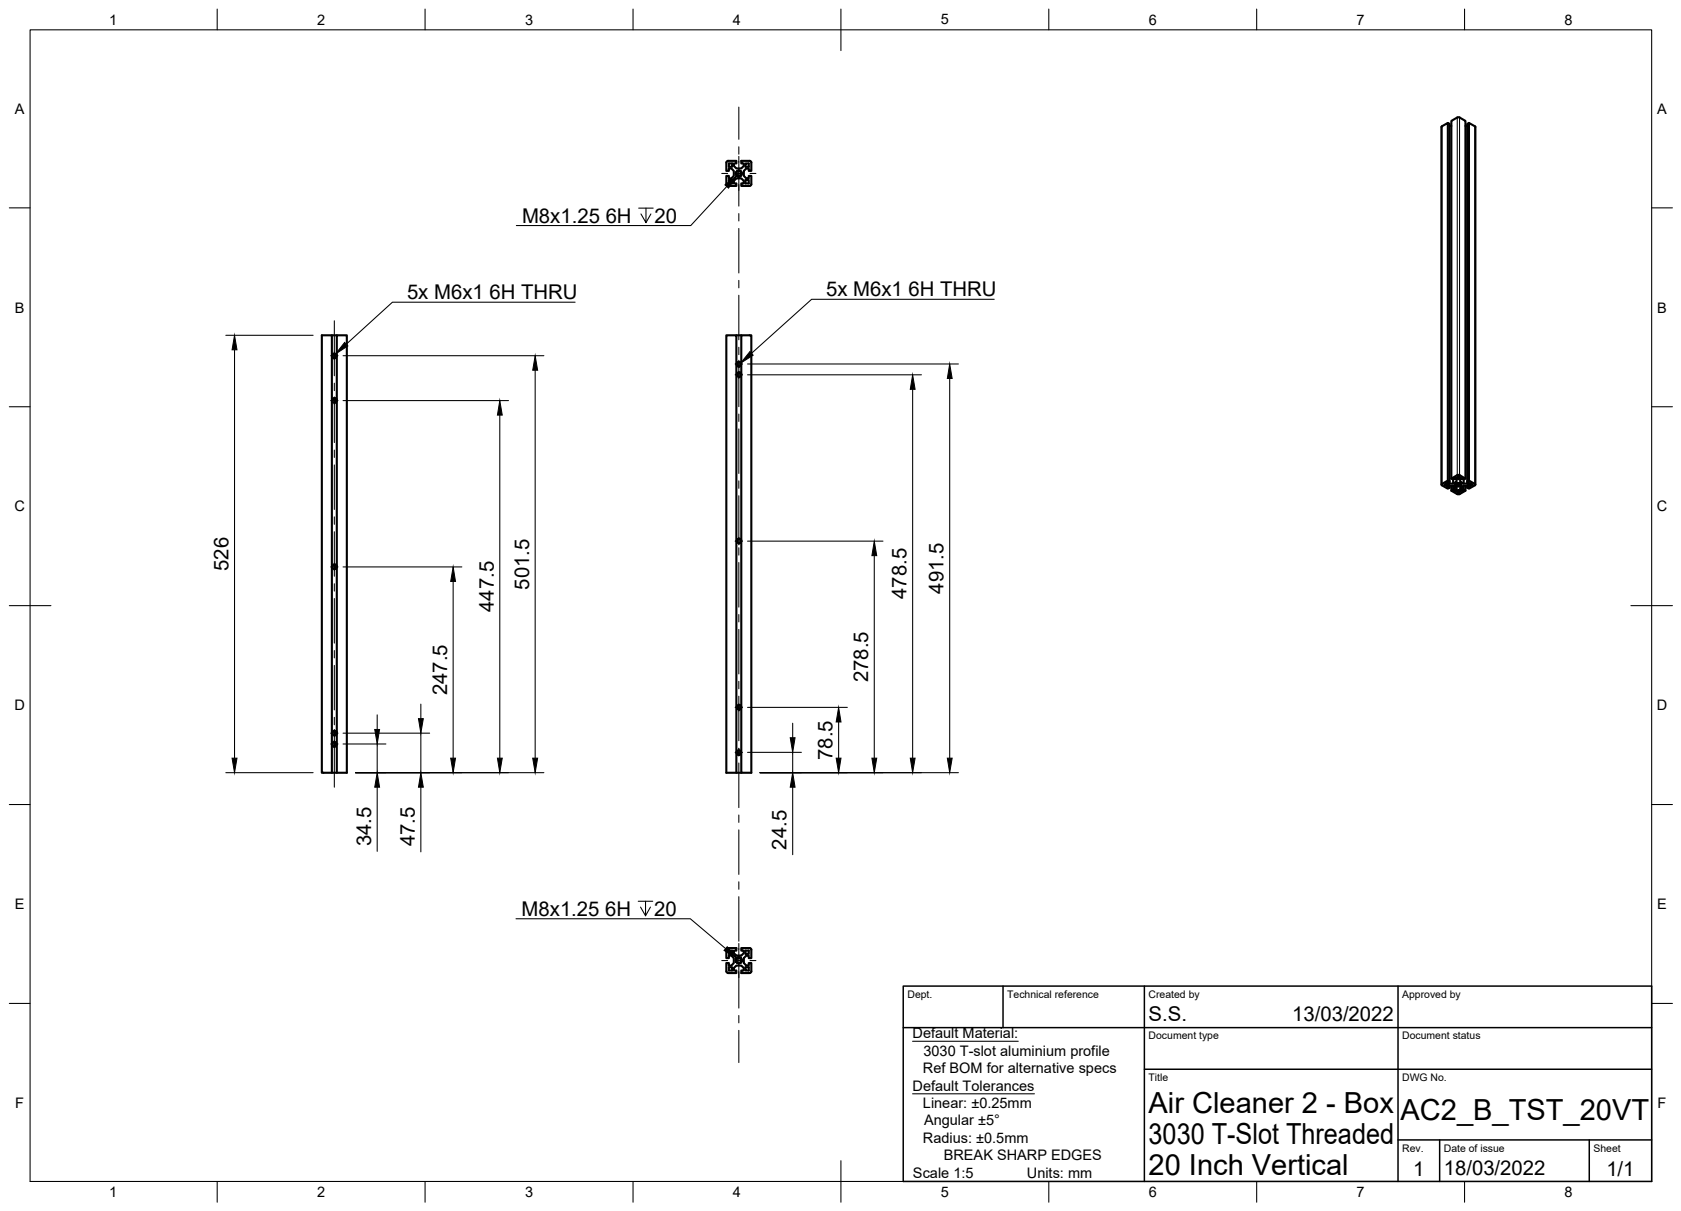
[picture p83: page 1]
Title; DWG No.; Rev.; Date of issue; Sheet; 20 Inch Vertical; 3030 T-Slot Threaded; 5x M6x1 6H THRU; Scale 1:5; Units: mm

Dept. | Technical reference | Created by 13/03/2022 | Approved by

Default Material:
3030 T-slot aluminium profile
Ref BOM for alternative specs
Default Tolerances
Linear: ±0.25mm
Angular ±5°
Radius: ±0.5mm
BREAK SHARP EDGES

Document type | Document status

Air Cleaner 2 - Box AC2_B_TST_20VT
