MechaFlowManiac/Air-Cleaner-2/Air-Cleaner-2 Mechanical/PDF/AC2_B_TST_24VT_Rev1.pdf

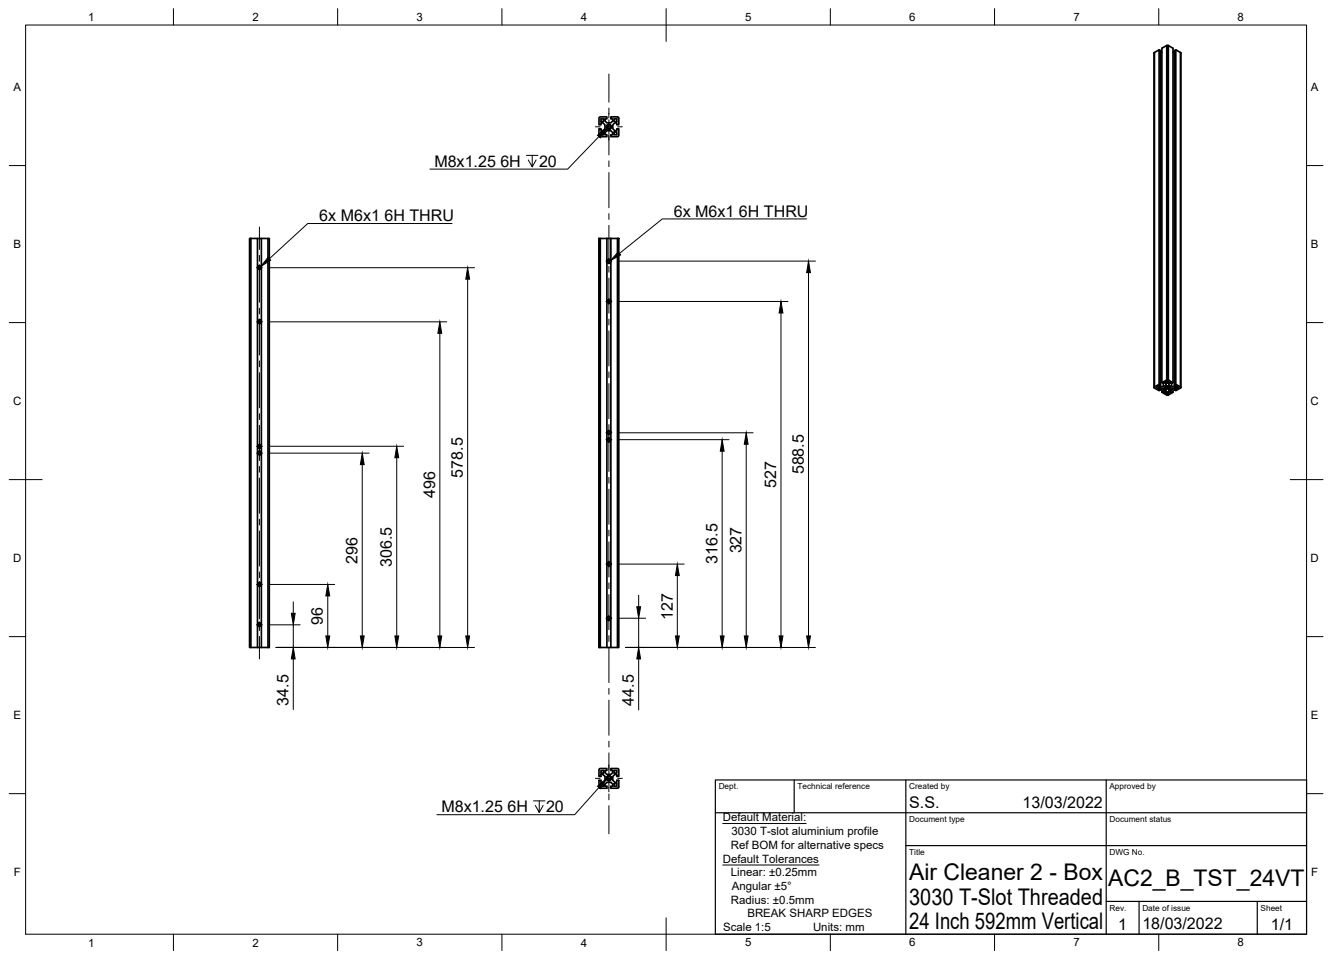
[picture p84: page 1]
Title; DWG No.; Rev.; Date of issue; Sheet; 24 Inch 592mm Vertical; Scale 1:5; Units: mm; 6x M6x1 6H THRU

Dept. | Technical reference | Created by 13/03/2022 | Approved by

Default Material: | | Document type | Document status

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

Air Cleaner 2 - Box AC2_B_TST_24VT
3030 T-Slot Threaded
