MechaFlowManiac/Air-Cleaner-2/Air-Cleaner-2 Mechanical/PDF/AC2_C_18CFBP_20HZ_Rev2.pdf

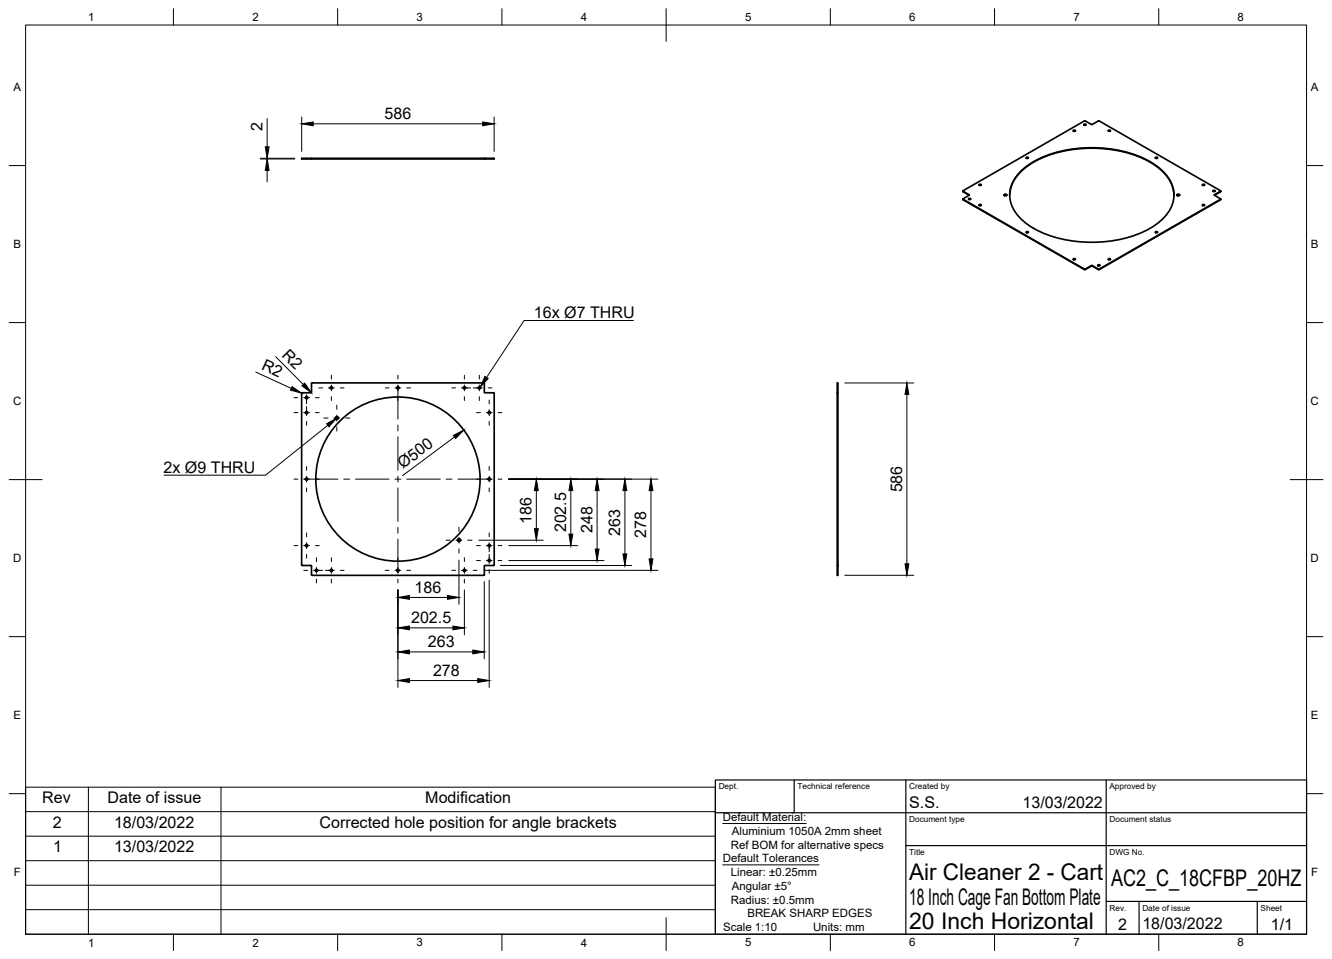
[picture p85: page 1]
16x Ø7 THRU; 2x Ø9 THRU

Dept. | Technical reference | Created by S.S. 13/03/2022 | Approved by

Rev | Date of issue | Modification

2 | 18/03/2022 | Corrected hole position for angle brackets | Default Material: Aluminium 1050A 2mm sheet Ref BOM for alternative specs Default Tolerances Linear: ±0.25mm Angular ±5° Radius: ±0.5mm BREAK SHARP EDGES Scale 1:10 Units: mm | Document type | Document status
1 | 13/03/2022

Title Air Cleaner 2 - Cart 18 Inch Cage Fan Bottom Plate 20 Inch Horizontal | DWG No. AC2_C_18CFBP_20HZ

Rev. 2 | Date of issue 18/03/2022 | Sheet 1/1
