MechaFlowManiac/Air-Cleaner-2/Air-Cleaner-2 Mechanical/PDF/AC2_C_ASC_20HZ20VT_Rev1.pdf

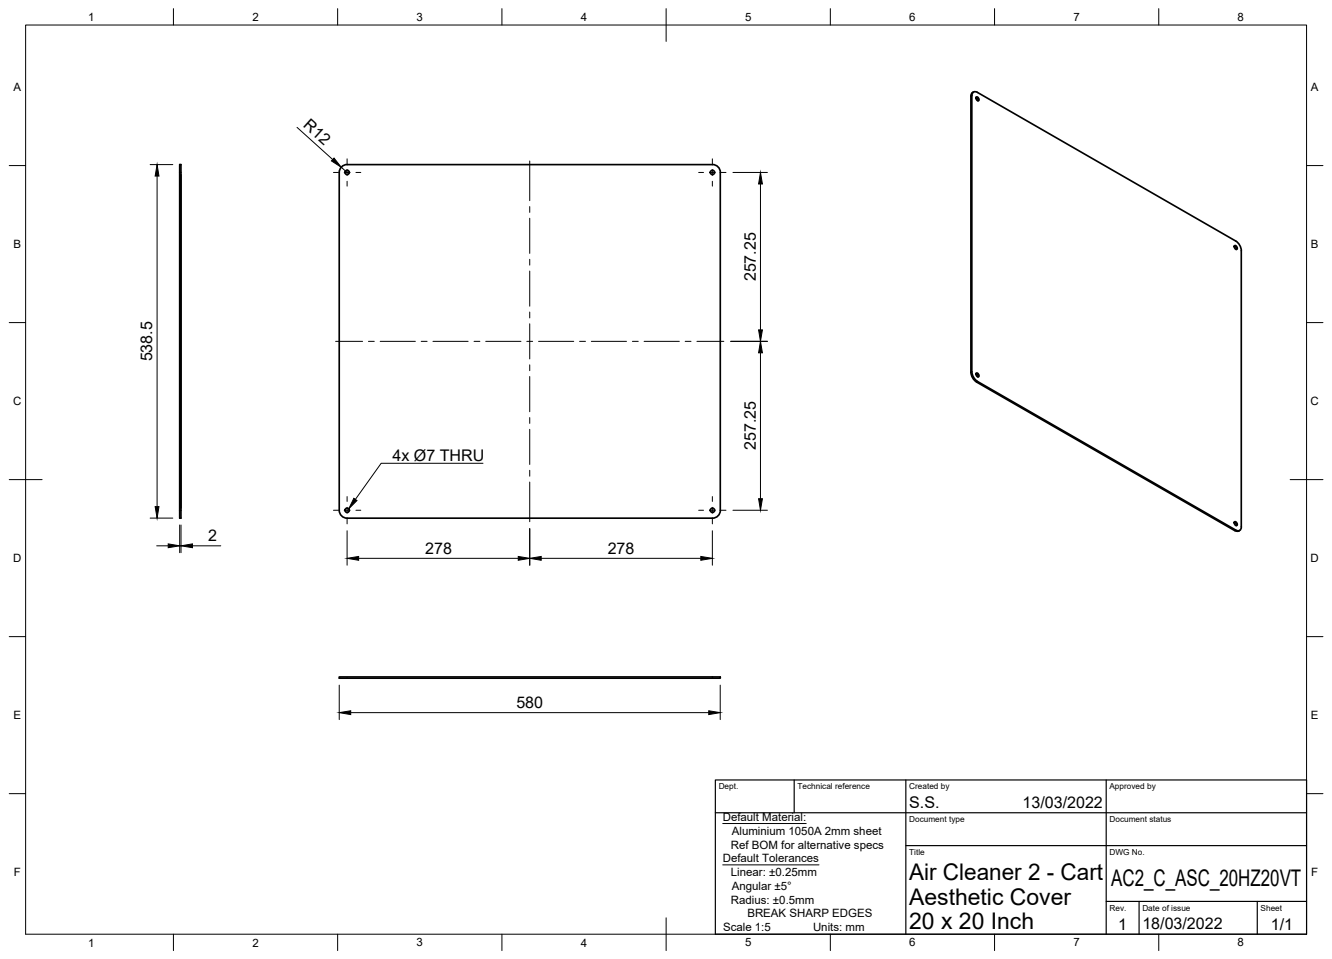
[picture p87: page 1]
Title; DWG No.; Rev.; Date of issue; Sheet; 20 x 20 Inch; Aesthetic Cover; Air Cleaner 2 - Cart; AC2_C_ASC_20HZ20VT; 4x Ø7 THRU; Scale 1:5; Units: mm

Dept. | Technical reference | Created by S.S. 13/03/2022 | Approved by

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

Document type | Document status
