MechaFlowManiac/Air-Cleaner-2/Air-Cleaner-2 Mechanical/PDF/AC2_C_BP_20HZ_Rev1.pdf

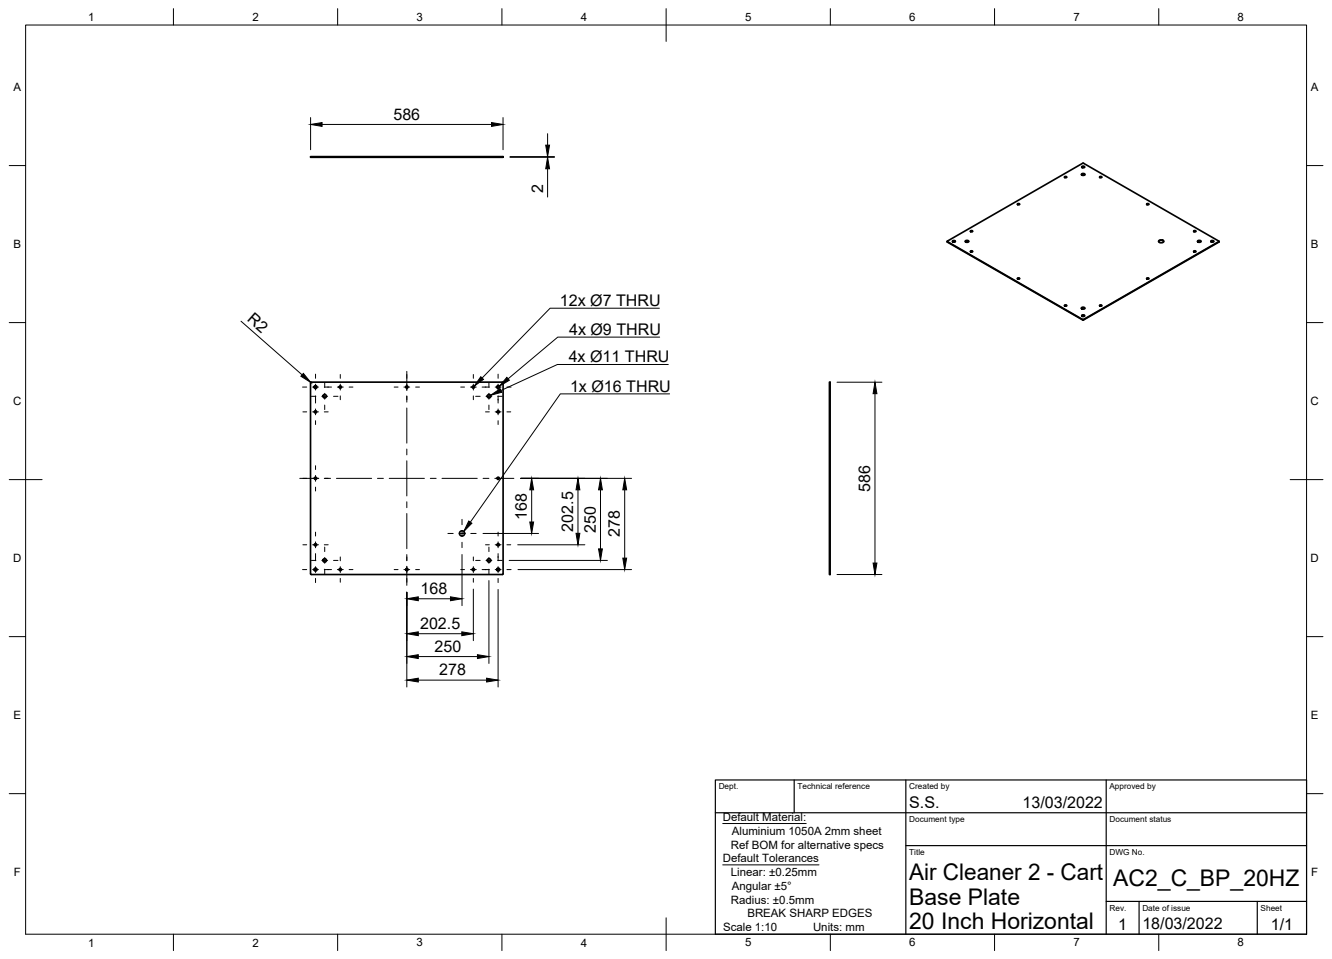
[picture p90: page 1]
Title; DWG No.; Rev.; Date of issue; Sheet; 20 Inch Horizontal; Base Plate; Air Cleaner 2 - Cart; 1x Ø16 THRU; 4x Ø11 THRU; 12x Ø7 THRU; Scale 1:10; Units: mm; 4x Ø9 THRU

Dept. | Technical reference | Created by 13/03/2022 | Approved by

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

Document type | Document status
