MechaFlowManiac/Air-Cleaner-2/Air-Cleaner-2 Mechanical/PDF/AC2_C_EA_16HZ_Rev1.pdf

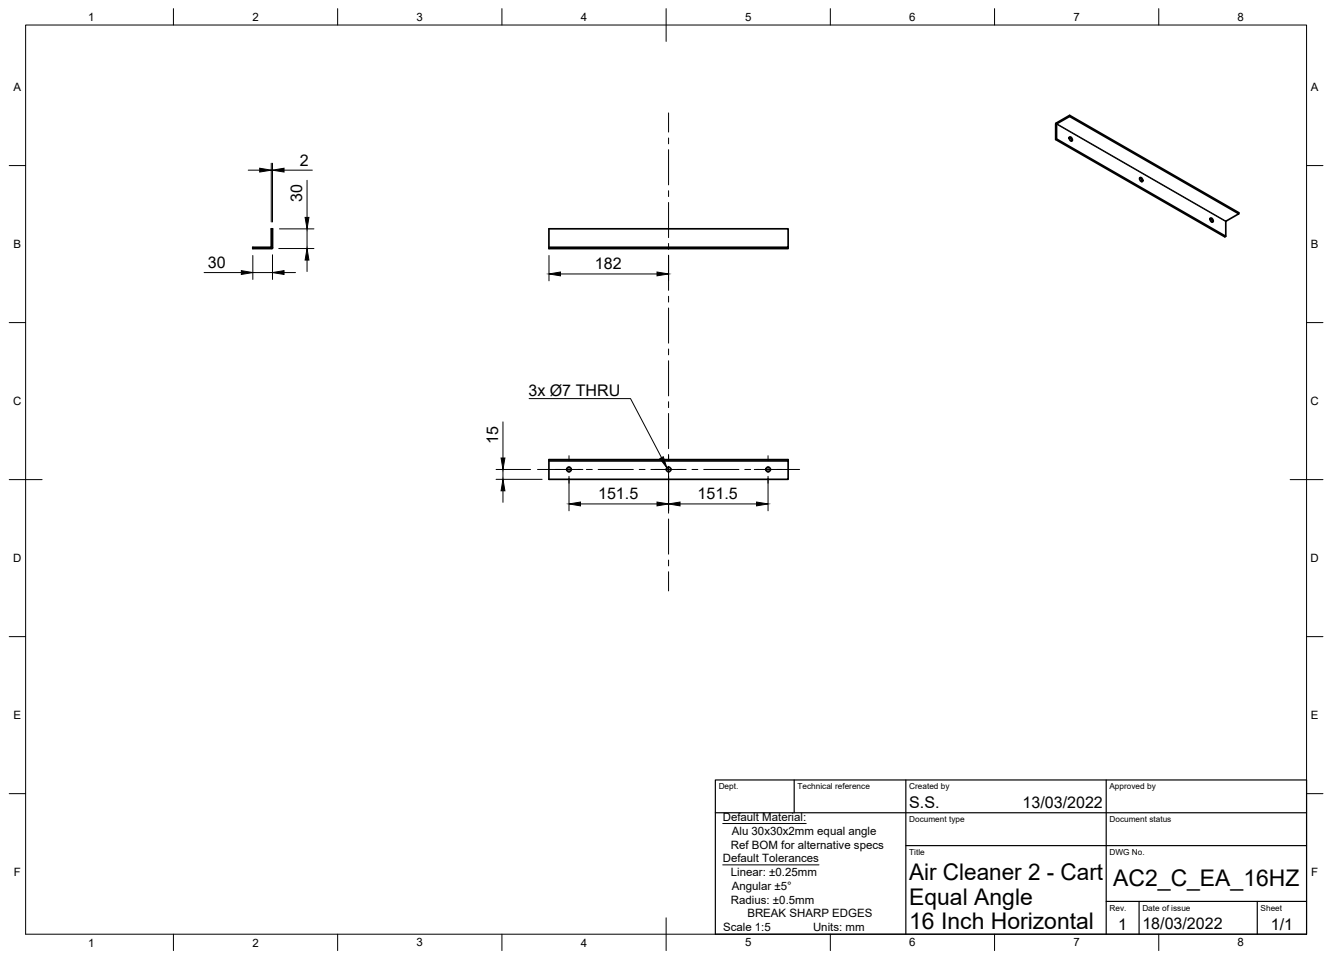
[picture p91: page 1]
Title; DWG No.; Rev.; Date of issue; Sheet; 16 Inch Horizontal; Equal Angle; Air Cleaner 2 - Cart; Scale 1:5; Units: mm; 3x Ø7 THRU 15

Dept. | Technical reference | Created by S.S. 13/03/2022 | Approved by

Default Material:
Alu 30x30x2mm equal angle
Ref BOM for alternative specs
Default Tolerances
Linear: ±0.25mm
Angular ±5°
Radius: ±0.5mm
BREAK SHARP EDGES

Document type | Document status
