MechaFlowManiac/Air-Cleaner-2/Air-Cleaner-2 Mechanical/PDF/AC2_C_EA_25VT_Rev1.pdf

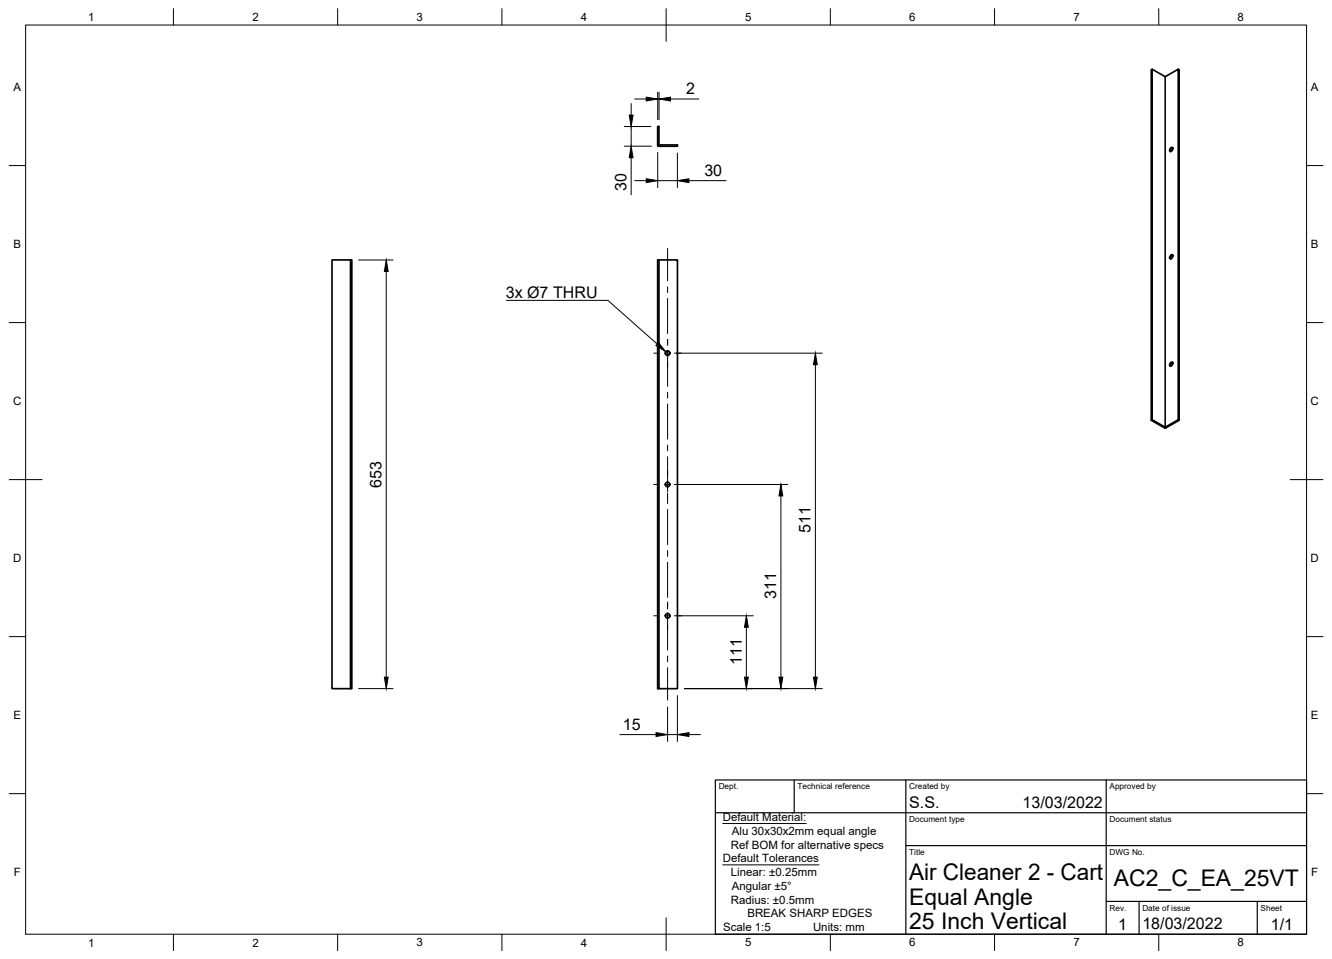
[picture p92: page 1]
Title; DWG No.; Rev.; Date of issue; Sheet; 25 Inch Vertical; Equal Angle; Air Cleaner 2 - Cart; 3x Ø7 THRU; Scale 1:5; Units: mm 111

Dept. | Technical reference | Created by 13/03/2022 | Approved by

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

Document type | Document status
