MechaFlowManiac/Air-Cleaner-2/Air-Cleaner-2 Mechanical/PDF/AC2_C_FCP_20VT_Rev1.pdf

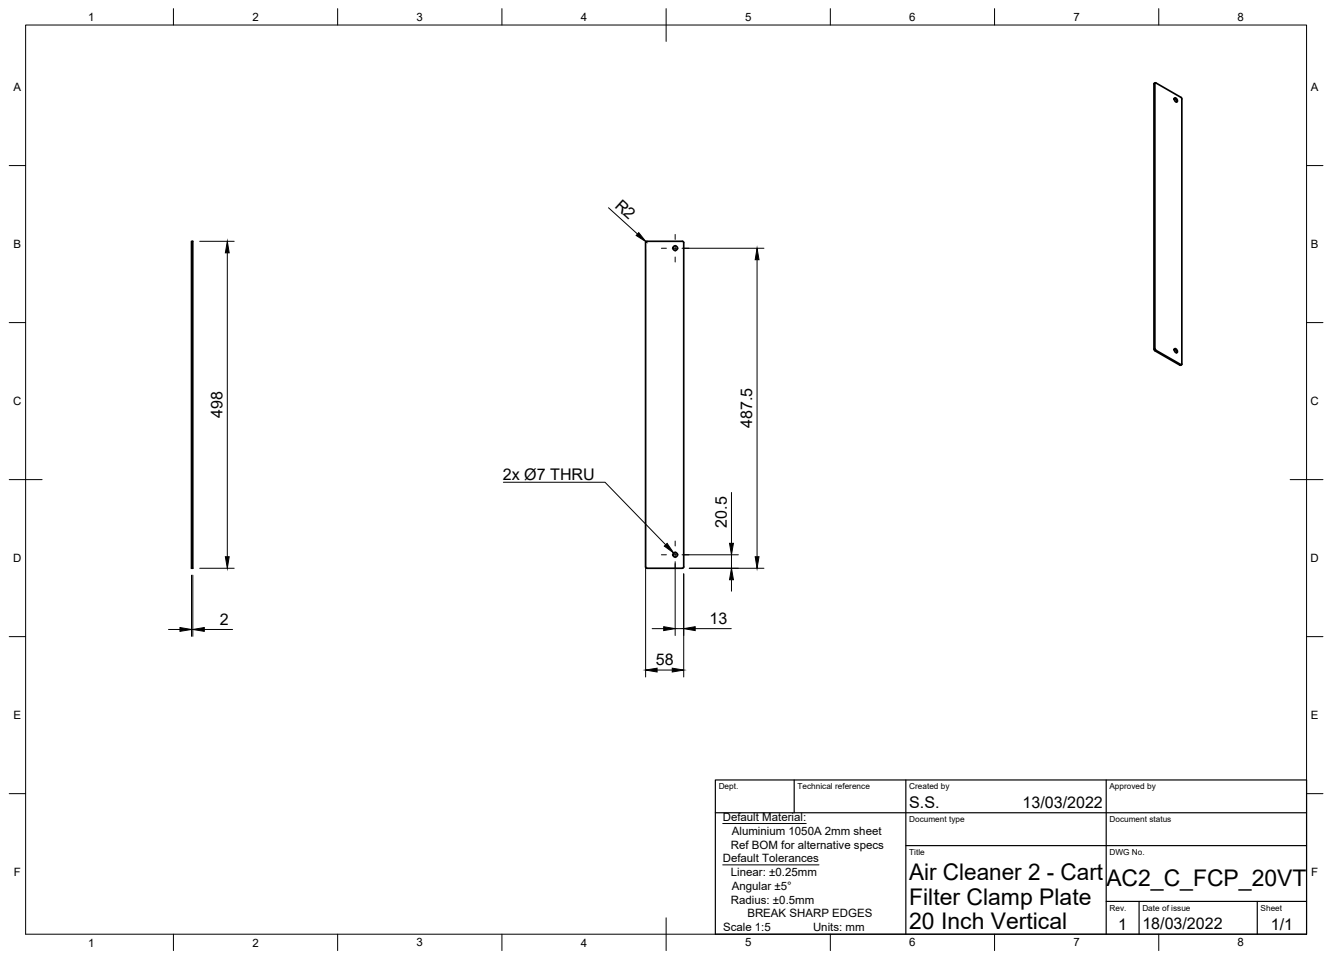
[picture p93: page 1]
Title; DWG No.; Rev.; Date of issue; Sheet; 20 Inch Vertical; 2x Ø7 THRU; Scale 1:5; Units: mm 498

Dept. | Technical reference | Created by S.S. 13/03/2022 | Approved by

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

Document type | Document status

Filter Clamp Plate

Air Cleaner 2 - CartAC2_C_FCP_20VT
