MechaFlowManiac/Air-Cleaner-2/Air-Cleaner-2 Mechanical/PDF/AC2_C_FCP_25VT_Rev1.pdf

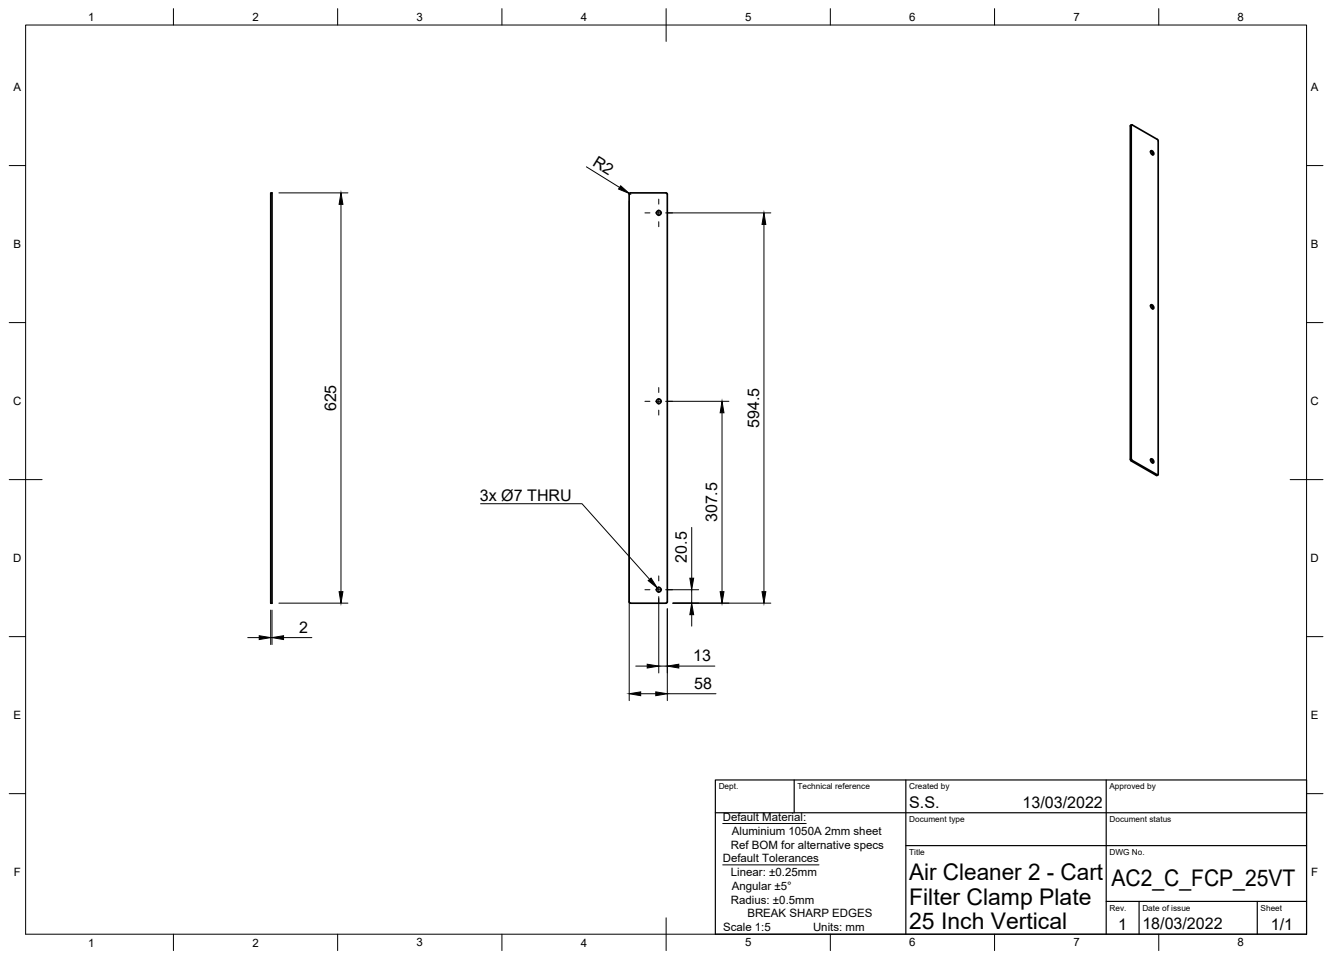
[picture p94: page 1]
Title; DWG No.; Rev.; Date of issue; Sheet; 25 Inch Vertical; Air Cleaner 2 - Cart; AC2_C_FCP_25VT; 3x Ø7 THRU; Scale 1:5; Units: mm 625

Dept. | Technical reference | Created by 13/03/2022 | Approved by

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

Document type | Document status

Filter Clamp Plate
