MechaFlowManiac/Air-Cleaner-2/Air-Cleaner-2 Mechanical/PDF/AC2_C_FEP_16HZ_Rev2.pdf

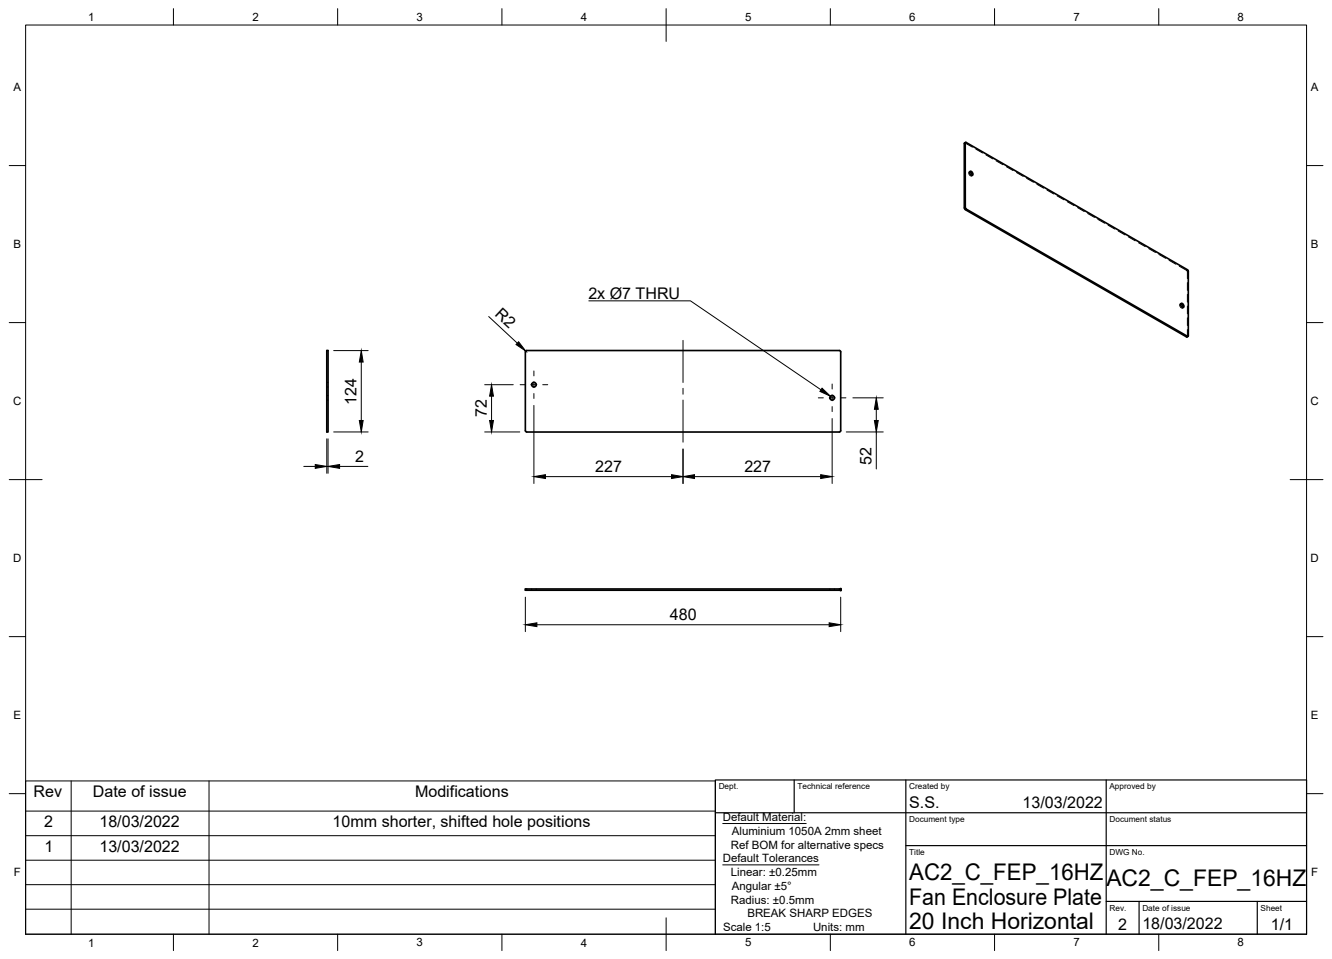
[picture p95: page 1]
2x Ø7 THRU

Rev | Date of issue | Modifications | Dept. | Technical reference | Created by S.S. 13/03/2022 | Approved by

2 | 18/03/2022 | 10mm shorter, shifted hole positions | Default Material: Aluminium 1050A 2mm sheet Ref BOM for alternative specs Default Tolerances Linear: ±0.25mm Angular ±5° Radius: ±0.5mm BREAK SHARP EDGES Scale 1:5 Units: mm | | Document type | Document status
1 | 13/03/2022

Title AC2_C_FEP_16HZAC2_C_FEP_16HZ Fan Enclosure Plate 20 Inch Horizontal | DWG No.

Rev. 2 | Date of issue 18/03/2022 | Sheet 1/1
