MechaFlowManiac/Air-Cleaner-2/Air-Cleaner-2 Mechanical/PDF/AC2_C_HPA250FBP_16HZ_Rev1.pdf

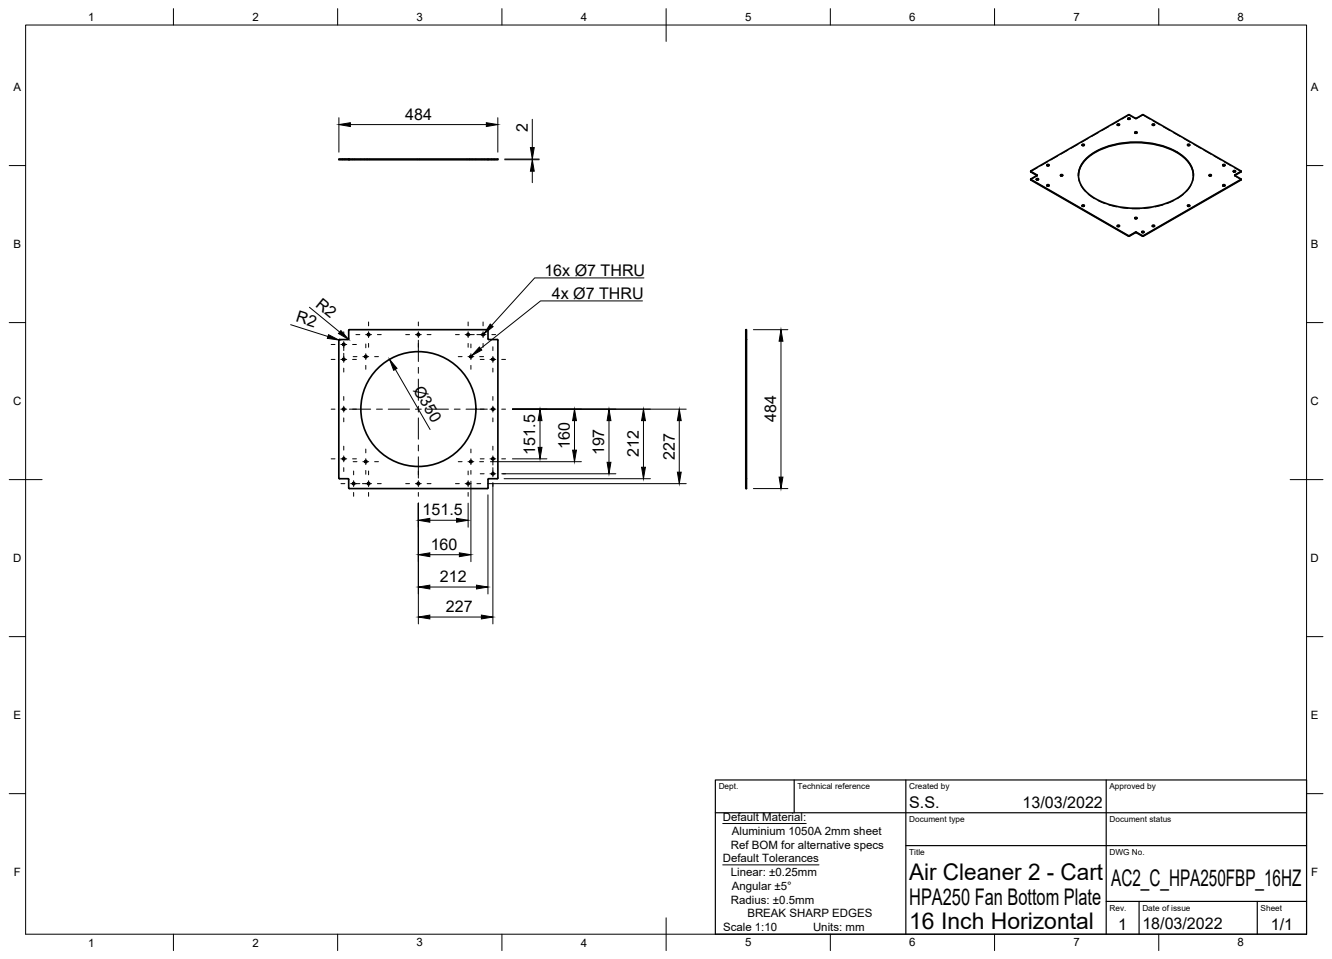
[picture p96: page 1]
Title; DWG No.; Rev.; Date of issue; Sheet; 16 Inch Horizontal; Air Cleaner 2 - Cart; AC2_C_HPA250FBP_16HZ; 16x Ø7 THRU; 4x Ø7 THRU; Scale 1:10; Units: mm 484

Dept. | Technical reference | Created by S.S. 13/03/2022 | Approved by

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

Document type | Document status

HPA250 Fan Bottom Plate
