MechaFlowManiac/Air-Cleaner-2/Air-Cleaner-2 Mechanical/PDF/AC2_C_TST_20VT_Rev1.pdf

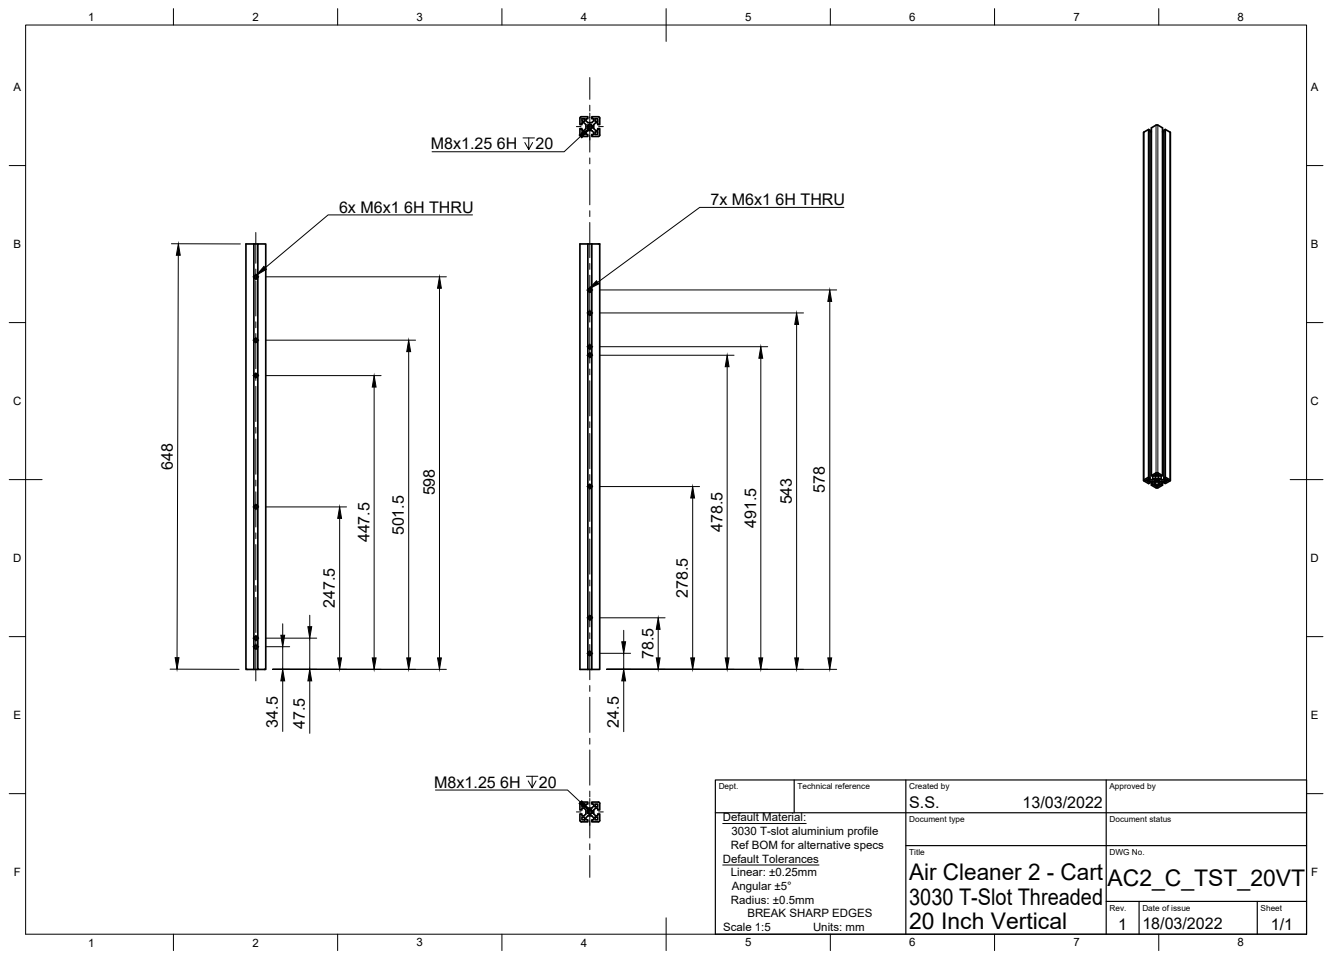
[picture p97: page 1]
Title; DWG No.; Rev.; Date of issue; Sheet; 20 Inch Vertical; 3030 T-Slot Threaded; Scale 1:5; Units: mm; 7x M6x1 6H THRU 6x M6x1 6H THRU 34.5

Dept. | Technical reference | Created by 13/03/2022 | Approved by

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

Document type | Document status

Air Cleaner 2 - Cart AC2_C_TST_20VT
