MechaFlowManiac/Air-Cleaner-2/Air-Cleaner-2 Mechanical/PDF/AC2_C_TST_24VT_Rev1.pdf

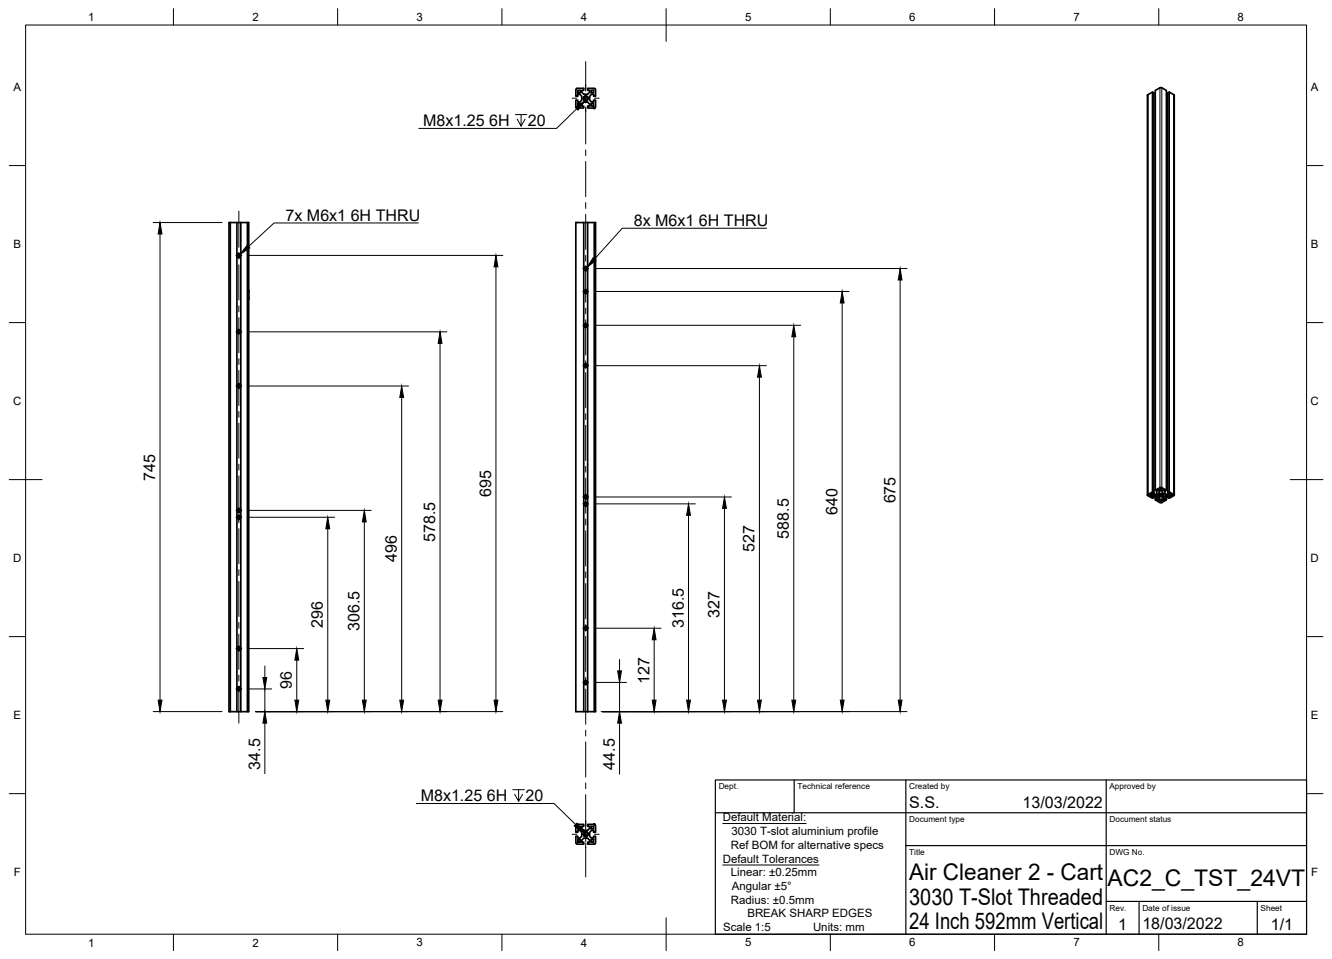
[picture p98: page 1]
Title; DWG No.; Rev.; Date of issue; Sheet; 24 Inch 592mm Vertical; 3030 T-Slot Threaded; 7x M6x1 6H THRU; 8x M6x1 6H THRU; Scale 1:5; Units: mm 745

Dept. | Technical reference | Created by S.S. 13/03/2022 | Approved by

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

Document type | Document status

Air Cleaner 2 - Cart AC2_C_TST_24VT
