MechaFlowManiac/Air-Cleaner-2/(commit log)

2022-03-18 Add files via upload
    Adding BOM and 2D drawings in PDF and DXF format
    [20220318_Air-Cleaner-2_BOM.xlsx, AC2_B_14CFBP_16HZ_Rev1.dxf, AC2_B_18CFBP_20HZ_Rev1.dxf, AC2_B_BP_16HZ_Rev1.dxf, AC2_B_BP_20HZ_Rev1.dxf, AC2_B_FCT_Rev1.dxf, AC2_B_TST_20VT_Rev1.dxf, AC2_B_TST_24VT_Rev1.dxf]
2022-03-18 Add files via upload
    Uploaded Step file models for each major component referenced in BOM.
    Included overall basic example 20x25x1 filter frame assembly without fan or filters ( AC2_C_ASSEMBLY_20HZ_25VT_01.step ).
    [AC2_B_14CFBP_16HZ_01.step, AC2_B_18CFBP_20HZ_01.step, AC2_B_BP_16HZ_01.step, AC2_B_BP_20HZ_01.step, AC2_B_FCT_01.step, AC2_C_14CFBP_16HZ_01.step, AC2_C_14CFTP_16HZ_01.step, AC2_C_18CFBP_20HZ_02.step]
